antony-sm/Ovrajnaya_stadia_RD/06 ВК/razmery-perexodnikov-dlya-kanalizacionnih-trub.jpg

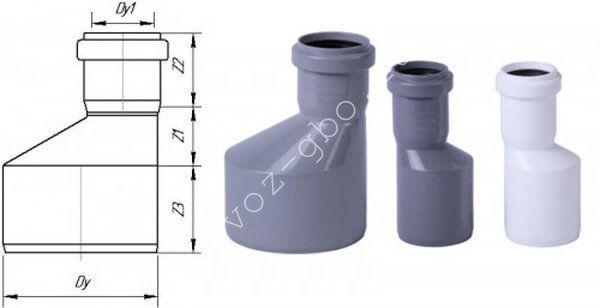
06 ВК/razmery-perexodnikov-dlya-kanalizacionnih-trub.jpg
