antony-sm/Ovrajnaya_stadia_RD/07 Перегородки потолки звукоизоляция/ПЗ.odt

# Звукоизоляция потолка.

Последовательность работ:

1. Застелить пол полиэтиленом.
2. Заложить пол листами ГВЛ старыми.
3. Занести материал.
4. Разметить высоту потолка.
5. Укрыть стены.
6. Наклеить ленту на подвесы (в т.ч. внутри) и направляющие профили.
7. Пристрелять подвесы.
8. Закрепить направляющие профили.
9. Нарезать несущие профили, нарезать Роквул и набить им профили.
10. Закрепить несущие профили.
11. Наклеить ленту по периметру и на несущие профили.
12. Закрепить Роквул.
13. Закрепить первый слой ГВЛ.
14. Промазать швы герметиком.
15. Закрепить второй слой ГВЛ.
16. Промазать швы герметиком.
17. Загрунтовать потолок.
