antony-sm/Ovrajnaya_stadia_RD/04 ЭОМ СС/ПЗ.odt

# Требования.

Расстояние между силой и СС — 20 см минимум.

Расстояние между ПС и пучком ЭО — 50 см минимум, между ПС и одиночным ЭО — 25 см.

# Аппаратура.

Звук — Logitech Media Server или HiFiBerry AMP+.

Датчик углекислого газа — TCS4161 или MQZ135.

Часы — комплектующие см. в проекте Кикад.

# Требования к электрике.

КУП для ванной и туалета.

Вводной автомат — тип C. Сразу после вводного автоматического выключателя желательно установить противопожарное УЗО на 100 мА с большим временем срабатывания.

Отключающая способность автоматов — не менее 6000А, для вводного — 10000А.

Отдельные автоматы:

- собственные нужды щита (розетка, освещение), трансформатор звонка, управляющие цепи импульсных реле;
- слаботочка и автоматика;
- ИБП;
- ПС.

Можно применить УЗО с номинальным током на 63А и не париться о сумме номиналов автоматов после него, ибо вводной автомат всё равно 45А.

УЗО - тип А.

Для линий розеток — УЗО 30 мА.

Для линий в ванной, туалете и лоджии — УЗО 10 мА.

Не более 5 линий на УЗО.

Собственные нужды щита (розетка, освещение), трансформатор звонка, управляющие цепи импульсных реле, слаботочка и автоматика — одно УЗО.

Рубильники и дистанционные расцепители:

- вводные;
- климатическое оборудование.

ВСЕ кнопки и управляющие цепи импульсных реле объединить на ОДИН автомат; выходные контакты каждого реле будут подавать на светильник фазу от его (светильника) автомата.

Устройство защиты от перенапряжения — УЗМ-51МД.

1,5 кв.мм (освещение) | 10 А, тип B
1,5 кв.мм (стационарное) | 10 А, тип C
2,5 кв.мм розетки | 16 А, тип B
2,5 кв.мм стационарное | 16 А, тип С
4 кв.мм стационарное | 20 А, тип С
6 кв.мм стационарное | 32 А, тип С

# Маркировка в электрощите.

Маркировка на плоских поверхностях (пластроны, крышки, модульное оборудование): подготовить наклейки и распечатать лазерником на самоклеящейся бумаге, два раза покрыть матовым нитролаком, порезать и наклеить.

Маркировка кабелей и проводов: подготовить наклейки и распечатать лазерником на самоклеящейся бумаге, порезать, наклеить на кабель, сверху надеть прозрачную термоусадку, осадить.

Правила формирования надписей.

1. Обозначения модульного оборудования - смотри в «перечне элементов щита».
2. Для входящих в щит кабелей и проводов: маркировка согласно кабельному журналу.
3. Для силовых проводов внутри шкафа: к обозначению модульного оборудования добавляется спереди префикс: L,N,PE. Например: «L-QD2», «N-QF5».
4. (?) Для проводов автоматики: обозначение составляется из соединяемых точек оборудования. Например, провод от клеммы X11 к клемме A2 K4.1 должен иметь обозначение «X11 - K4.1(A2)»
