antony-sm/Ovrajnaya_stadia_RD/09 Полы/ПЗ.odt

# Расчёт высот.

Кнауф Суперпол: минимальная толщина засыпки — 20 мм, элемент пола — 20 мм.

Высшая точка пола — угол кухни, отметка -0,065. При 20 мм засыпки, 20 мм элемента пола и 12,5 фанеры или ГВЛ получим отметку чернового пола -0,0125. Плюс кварцвиниловая плитка на клей 3 мм, получим отметку чистового пола около -0,01.

Высота чернового пола в «грязной» зоне: -7,6+3+2 = -2,6 см.

Высота чернового пола в «чистая» зоне: -6,5+2+2 = -2,5 см.

Будем сыпать с запасом в 3 мм. Итого, отталкиваясь от «грязной» зоны: -7,6 + 3,3 (засыпка) + 2 (элемент пола) = -2,3 см. С плиткой -1,3 см.

Чистая зона: -6,5 + 2,3 (засыпка) + 2 (элемент пола) = -2,2 см. Плюс доп слой фанеры или ГВЛ: -2,2 + 1,3 = -0,9 см. Плюс кварцвинил на клей: -0,9 + 0,3 = -0,6 см.

Получили разницу зон в 0,7 см (грязная ниже).

Верхняя отметка засыпки: -6,5 + 2,3 = -4,2 см.

Высота нижней кромки балконной двери — не ниже 1 см от отметки чистого пола. Примем 2,5 см — расстояние от кромки створки стеклоблока до кромки рамы. Высота нижней кромки блока балконного: 1 — 2,5 см = -1,5 см. В итоге нужно поднять балконный блок относительно местной отметки плиты перекрытия на: 6,6 — 0,6 + 1 -2,5 = 4,5 см.

Кирпич имеет высоту 6,5 см. Будем ставить стеклоблок прямо на существующий ряд кирпича.

В развёртках стен за нулевую отметку принимается существующая нулевая отметка — порог входной двери.
