antony-sm/Ovrajnaya_stadia_RD/05 ОВиК/TD-160 SILENTdraw01.JPG

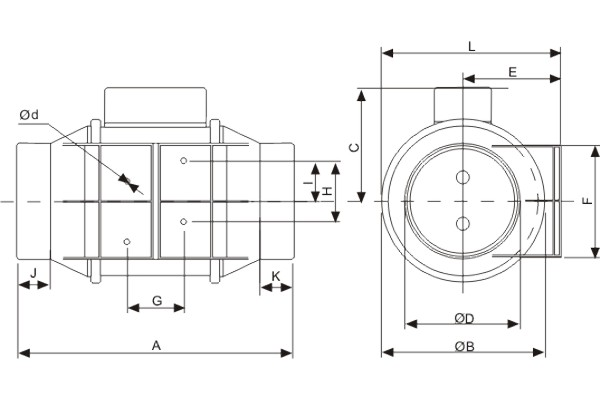
05 ОВиК/TD-160 SILENTdraw01.JPG
