antony-sm/Ovrajnaya_stadia_RD/05 ОВиК/zea3_2.jpg

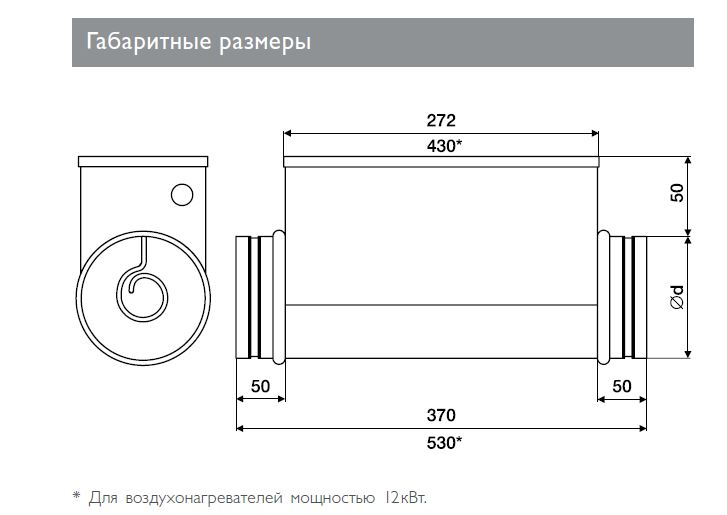
05 ОВиК/zea3_2.jpg
