antony-sm/Ovrajnaya_stadia_RD/06 ВК/mid_smesitel-dlya-vanny-hansgrohe-ecostat-13114000(5).jpg

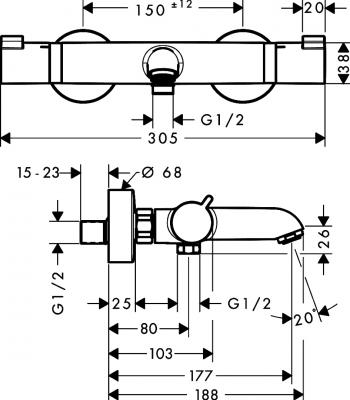
06 ВК/mid_smesitel-dlya-vanny-hansgrohe-ecostat-13114000(5).jpg
