antony-sm/Ovrajnaya_stadia_RD/06 ВК/Odeon Up E4701-00.gif

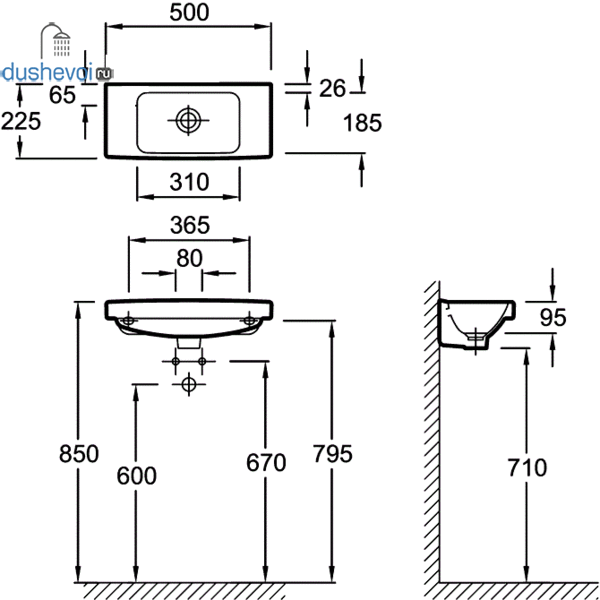
06 ВК/Odeon Up E4701-00.gif
