antony-sm/Ovrajnaya_stadia_RD/06 ВК/бачок.jpeg

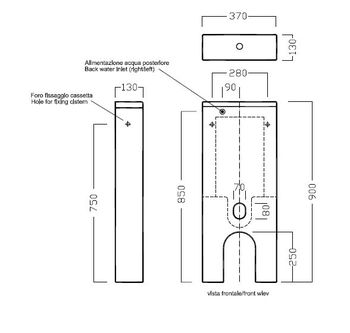
06 ВК/бачок.jpeg
