antony-sm/Ovrajnaya_stadia_RD/06 ВК/инсталляция сбоку.jpg

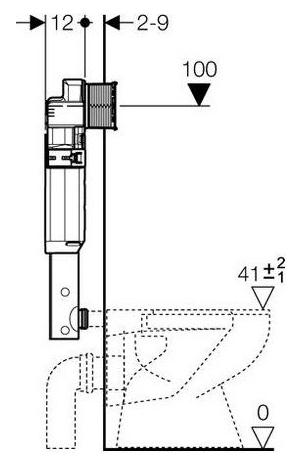
06 ВК/инсталляция сбоку.jpg
