antony-sm/Ovrajnaya_stadia_RD/06 ВК/инсталляция.jpg

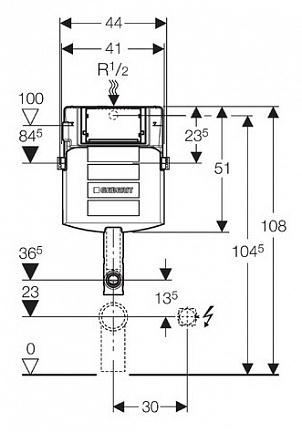
06 ВК/инсталляция.jpg
