antony-sm/Ovrajnaya_stadia_RD/06 ВК/клапан обратный 50 мм.jpg

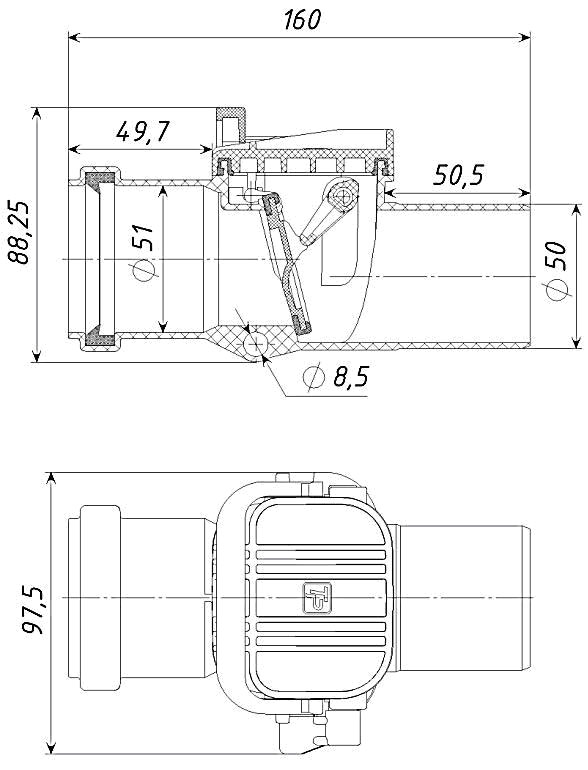
06 ВК/клапан обратный 50 мм.jpg
