antony-sm/Ovrajnaya_stadia_RD/06 ВК/клипса 20 мм.jpg

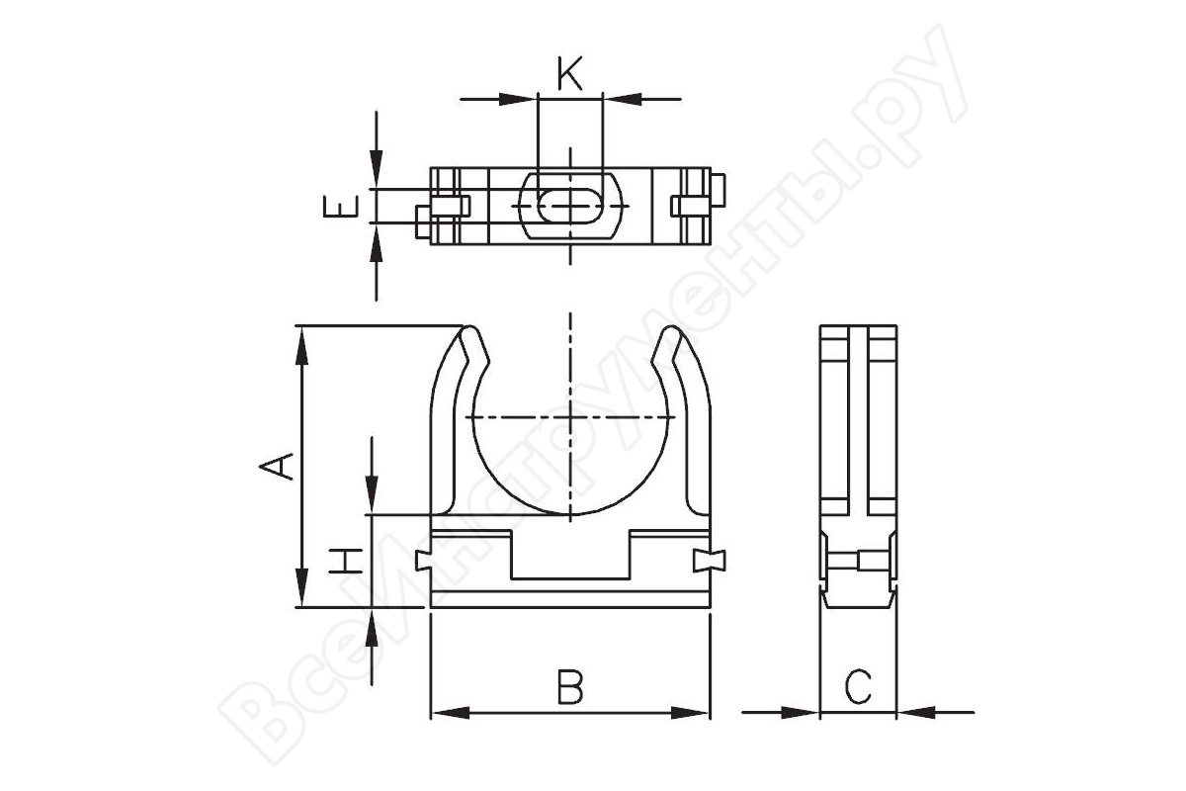
06 ВК/клипса 20 мм.jpg
