antony-sm/Ovrajnaya_stadia_RD/06 ВК/охта.jpg

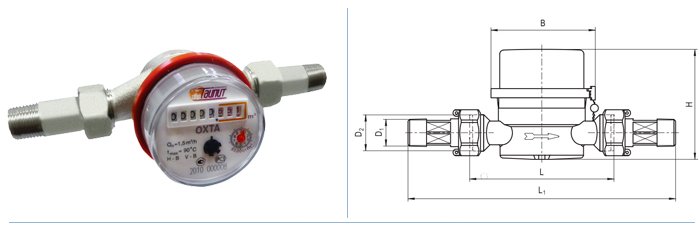
06 ВК/охта.jpg
