antony-sm/Ovrajnaya_stadia_RD/06 ВК/полотенцесушитель.jpg

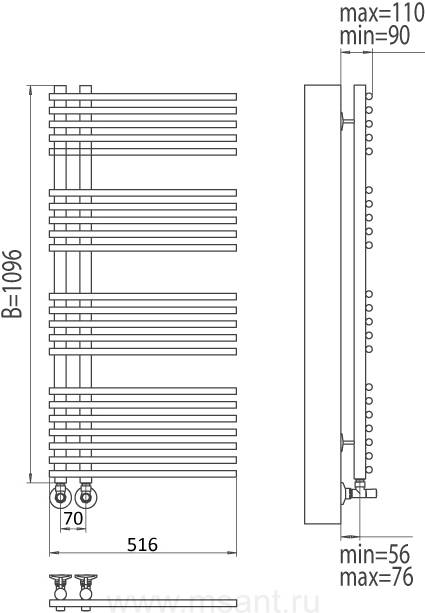
06 ВК/полотенцесушитель.jpg
