antony-sm/Ovrajnaya_stadia_RD/06 ВК/раковина.jpg

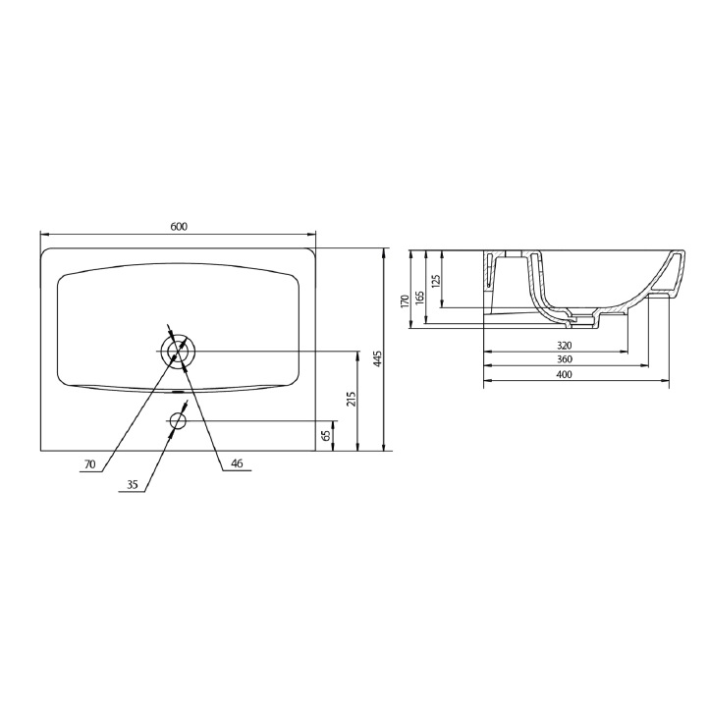
06 ВК/раковина.jpg
