antony-sm/Ovrajnaya_stadia_RD/07 Перегородки потолки звукоизоляция/knauf.jpg

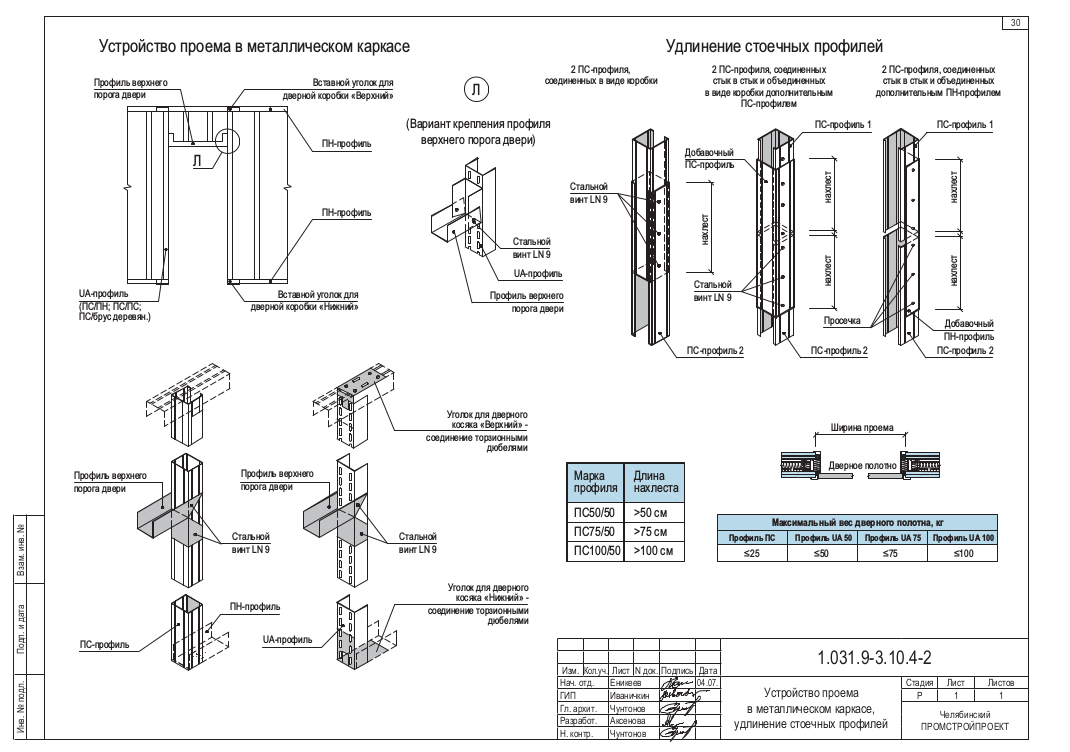
07 Перегородки потолки звукоизоляция/knauf.jpg
