antony-sm/Ovrajnaya_stadia_RD/100 Мебель/Санузлы/г.о. Химки, мкр. Сходня, ул. Овражная, д. 4, п. 2, эт. 76. Пенал подвесной + зеркало в коробе..jpg

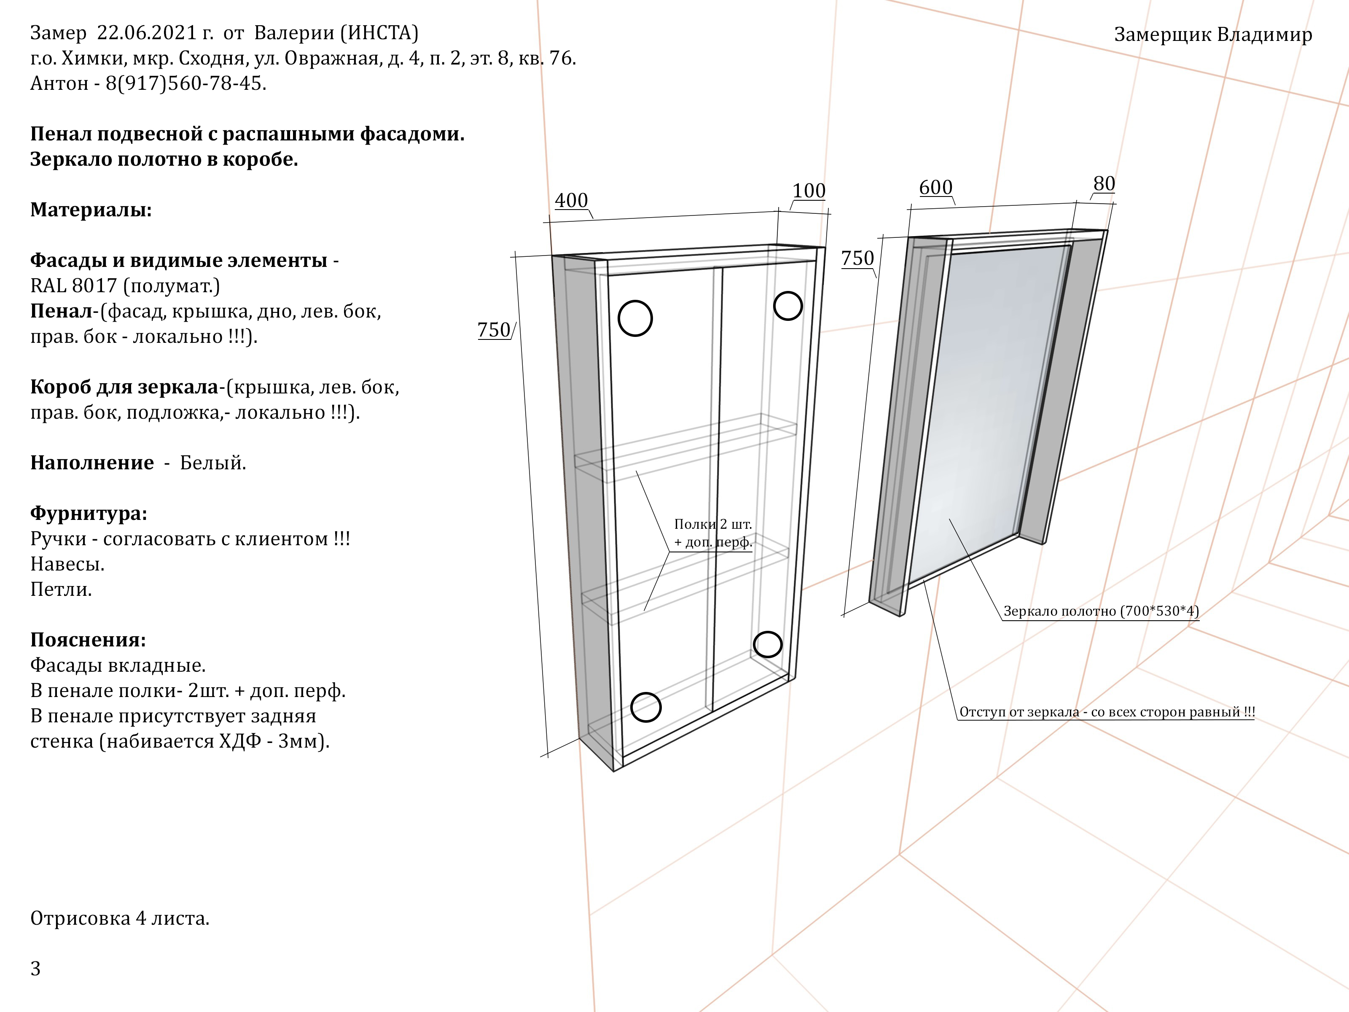
100 Мебель/Санузлы/г.о. Химки, мкр. Сходня, ул. Овражная, д. 4, п. 2, эт. 76. Пенал подвесной + зеркало в коробе..jpg
