antony-sm/Ovrajnaya_stadia_RD/Расчет точки росы/_Жилое помещение. Стена. R 1.30  29.11.2018 12_32_09 (1).png

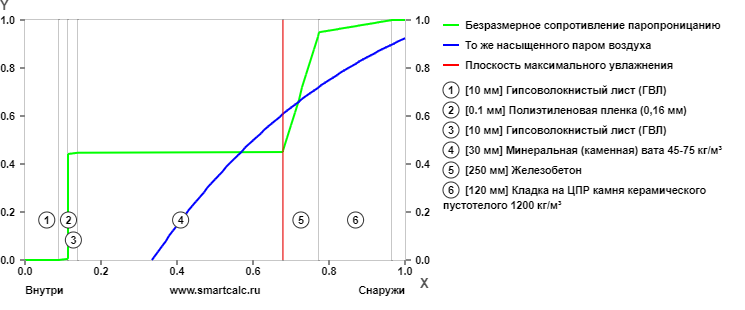
Расчет точки росы/_Жилое помещение. Стена. R 1.30 29.11.2018 12_32_09 (1).png
