antony-sm/Ovrajnaya_stadia_RD/04 ЭОМ СС/кабжур.xls

Sheet: ЭОМ
 | Опуск, см |  |  |  |  |  |  | Труба | Длина | Из автокад | 1.1
ЭОМ-1.1 | 120 | ША.6 | XD-1.1 | ВВГнг(А)-LS 3x2,5 | 10 |  |  |  |  | 8.2 | 7.2 | 1
ЭОМ-1.2 |  | XD-1.1 | XD-1.2 | ВВГнг(А)-LS 3x2,5 | 6 |  |  | 20 мм | 6 | 5.1 | 5.1
ЭОМ-1.3 |  | XD-1.2 | XS-1.3,XS-1.4 | ВВГнг(А)-LS 3x2,5 | 3 |  |  | 20 мм | 3 | 2.2 | 2.2
ЭОМ-1.4 |  | XD-1.1 | XD-1.3 | ВВГнг(А)-LS 3x2,5 | 2 |  |  | 20 мм | 2 | 1.0 | 1.0
ЭОМ-1.5 |  | XD-1.3 | XS-1.1,XS-1.2 | ВВГнг(А)-LS 3x2,5 | 3 |  |  | 20 мм | 3 | 2.5 | 2.2 | 0.3
ЭОМ-1.6 |  | XD-1.3 | XD-1.4 | ВВГнг(А)-LS 3x2,5 | 3 |  |  | 20 мм | 3 | 1.9 | 1.9
ЭОМ-1.7 |  | XD-1.4 | XS-1.5..XS-1.8 | ВВГнг(А)-LS 3x2,5 | 2 |  |  | 20 мм | 2 | 1.3 | 1.0 | 0.3
ЭОМ-1.8 |  | XD-1.4 | XD-1.7 | ВВГнг(А)-LS 3x2,5 | 2 |  |  | 20 мм | 2 | 1.4 | 1.4
ЭОМ-1.9 |  | XD-1.2 | XD-1.5 | ВВГнг(А)-LS 3x2,5 | 3 |  |  | 20 мм | 3 | 2.2 | 2.2
ЭОМ-1.10 |  | XD-1.5 | XS-1.11,XS-1.12 | ВВГнг(А)-LS 3x2,5 | 3 |  |  | 20 мм | 3 | 2.2 | 2.2
ЭОМ-1.11 |  | XD-1.5 | XD-1.8 | ВВГнг(А)-LS 3x2,5 | 2 |  |  | 20 мм | 2 | 1.4 | 1.4
ЭОМ-1.12 |  | XD-1.8 | XS-1.13,XS-1.14 | ВВГнг(А)-LS 3x2,5 | 4 |  |  | 20 мм | 4 | 2.9 | 0.4 | 2.5
ЭОМ-1.13 |  | XD-1.8 | XS-1.15,XS-1.16 | ВВГнг(А)-LS 3x2,5 | 3 |  |  | 20 мм | 3 | 1.9 | 0.4 | 1.5
ЭОМ-1.14 |  | XD-1.7 | XS-1.9,XS-1.10 | ВВГнг(А)-LS 3x2,5 | 4 |  |  | 20 мм | 4 | 2.9 | 0.4 | 2.5
ЭОМ-1.15 |  | XD-1.7 | XS-1.17,XS-1.18 | ВВГнг(А)-LS 3x2,5 | 3 |  |  | 20 мм | 3 | 2.5 | 1.0 | 1.5
ЭОМ-1.31 | 120 | ША.6 | XF-1.1 | ВВГнг(А)-LS 3x2,5 | 10 | 0.02 | Вентилятор канальный | 20 мм | 2 | 9.0 | 8.0 | 1
ЭОМ-1.32 | 120 | ША.6 | XF-1.2 | ВВГнг(А)-LS 3x2,5 | 14 | 2.1 | Канальный нагреватель | 20 мм | 6 | 12.0 | 11.0 | 1
ЭОМ-1.51 | 120 | ША.6 | HL-1.1 | ВВГнг(А)-LS 3x1,5 | 14 |  |  | 16 мм | 6 | 12.0 | 11.0 | 1
ЭОМ-1.52 | 120 | ША.6 | XD-1.3 | ВВГнг(А)-LS 3x1,5 | 10 |  |  | 16 мм | 2 | 9.0 | 8.0 | 1
ЭОМ-1.53 |  | XD-1.3 | HL-1.2 | ВВГнг(А)-LS 3x1,5 | 2 |  |  | 16 мм | 2 | 1.0 | 1.0
ЭОМ-1.54 |  | XD-1.3 | HL-1.3 | ВВГнг(А)-LS 3x1,5 | 4 |  |  | 16 мм | 4 | 3.0 | 3.0
ЭОМ-1.55 | 120 | ША.6 | HL-1.4 | ВВГнг(А)-LS 3x1,5 | 17 |  |  | 16 мм | 9 | 15.1 | 12.5 | 1 | 1.6
ЭОМ-1.56 | 120 | ША.6 | HL-1.5 | ВВГнг(А)-LS 3x1,5 | 18 |  |  | 16 мм | 10 | 16.3 | 13.7 | 1 | 1.6
ЭОМ-1.57 | 120 | ША.6 | QS-1.2 | ВВГнг(А)-LS 2x1,5 | 17 |  |  | 16 мм | 9 | 15.3 | 12.0 | 1 | 2.3
ЭОМ-1.58 | 120 | ША.6 | QS-1.3 | ВВГнг(А)-LS 2x1,5 | 20 |  |  | 16 мм | 12 | 17.5 | 14.2 | 1 | 2.3
ЭОМ-1.59 | 120 | ША.6 | XD-1.6 | ВВГнг(А)-LS 2x1,5 | 10 |  |  | 16 мм | 2 | 9.0 | 8.0 | 1
ЭОМ-1.60 |  | XD-1.6 | QS-1.1 | ВВГнг(А)-LS 2x1,5 | 3 |  |  | 16 мм | 3 | 1.9 | 1.9
ЭОМ-1.61 |  | XD-1.6 | XD-1.2 | ВВГнг(А)-LS 2x1,5 | 5 |  |  | 16 мм | 5 | 4.0 | 4.0
ЭОМ-1.62 |  | XD-1.2 | QS-1.2 | ВВГнг(А)-LS 2x1,5 | 3 |  |  | 16 мм | 3 | 2.3 | 2.3
ЭОМ-1.63 |  | XD-1.2 | QS-1.3 | ВВГнг(А)-LS 2x1,5 | 5 |  |  | 16 мм | 5 | 4.5 | 2.2 | 2.3
ЭОМ-2.1 | 120 | ША.6 | XD-2.1 | ВВГнг(А)-LS 3x2,5 | 9 |  |  |  |  | 8.0 | 7.0 | 1
ЭОМ-2.2 |  | XD-2.1 | XD-2.2 | ВВГнг(А)-LS 3x2,5 | 2 |  |  | 20 мм | 2 | 1.1 | 1.1
ЭОМ-2.3 |  | XD-2.1 | XS-2.5..XS-2.8 | ВВГнг(А)-LS 3x2,5 | 3 |  |  | 20 мм | 3 | 2.7 | 0.8 | 1.9
ЭОМ-2.4 |  | XD-2.2 | XS-2.1,XS-2.2 | ВВГнг(А)-LS 3x2,5 | 6 |  |  | 20 мм | 6 | 4.7 | 2.8 | 1.9
ЭОМ-2.5 |  | XD-2.2 | XS-2.3,XS-2.4 | ВВГнг(А)-LS 3x2,5 | 3 |  |  | 20 мм | 3 | 2.5 | 2.5
ЭОМ-2.31 | 120 | ША.6 | XF-2.1 | ВВГнг(А)-LS 3x2,5 | 13 | 2.13 | Кондиционер | 20 мм | 5 | 11.0 | 10.0 | 1
ЭОМ-2.51 | 120 | ША.6 | XD-2.1 | ВВГнг(А)-LS 3x1,5 | 9
ЭОМ-2.52 |  | XD-2.1 | HL-2.1 | ВВГнг(А)-LS 3x1,5 | 3 |  |  | 16 мм | 3 | 2.4 | 2.4
ЭОМ-2.53 |  | XD-2.1 | HL-2.2 | ВВГнг(А)-LS 3x1,5 | 3 |  |  | 16 мм | 3 | 1.9 | 1.9
ЭОМ-2.54 | 120 | ША.6 | QS-2.1 | ВВГнг(А)-LS 2x1,5 | 12 |  |  | 16 мм | 3 | 10.3 | 7.4 | 1 | 1.9
ЭОМ-3.1 | 120 | ША.6 | XD-3.1 | ВВГнг(А)-LS 3x2,5 | 9 |  |  | 20 мм | 1 | 7.7 | 6.7 | 1
ЭОМ-3.2 |  | XD-3.1 | XS-3.1,XS-3.2 | ВВГнг(А)-LS 3x2,5 | 3 |  |  | 20 мм | 3 | 2.6 | 2.6
ЭОМ-3.3 |  | XD-3.1 | XS-3.3..XS-3.5 | ВВГнг(А)-LS 3x2,5 | 4 |  |  | 20 мм | 4 | 3.4 | 1.5 | 1.9
ЭОМ-3.4 |  | XD-3.1 | XD-3.2 | ВВГнг(А)-LS 3x2,5 | 3 |  |  | 20 мм | 3 | 2.6 | 2.6
ЭОМ-3.5 |  | XD-3.2 | XS-3.6..XS-3.9 | ВВГнг(А)-LS 3x2,5 | 2 |  |  | 20 мм | 2 | 1.4 | 1.4
ЭОМ-3.6 |  | XD-3.2 | XD-3.3 | ВВГнг(А)-LS 3x2,5 | 2 |  |  | 20 мм | 2 | 1.5 | 1.5
ЭОМ-3.7 |  | XD-3.3 | XS-3.10..XS-3.13 | ВВГнг(А)-LS 3x2,5 | 3 |  |  | 20 мм | 3 | 2.0 | 2.0
ЭОМ-3.8 |  | XD-3.3 | XS-3.14,XS-3.15 | ВВГнг(А)-LS 3x2,5 | 5 |  |  | 20 мм | 5 | 3.8 | 2.3 | 1.5
ЭОМ-3.9 | 350 | ША.6 | XS-3.16..XS-3.19 | ВВГнг(А)-LS 3x2,5 | 16.5 |  |  | 20 мм |  | 2.6 | 2.6
ЭОМ-3.51 | 120 | ША.6 | HL-3.1 | ВВГнг(А)-LS 3x1,5 | 14 |  |  | 16 мм | 6 | 12.2 | 11.2 | 1
ЭОМ-3.52 | 120 | ША.6 | XD-3.4 | ВВГнг(А)-LS 3x1,5 | 11 |  |  | 16 мм | 3 | 9.1 | 8.1 | 1
ЭОМ-3.53 |  | XD-3.4 | HL-3.2 | ВВГнг(А)-LS 3x1,5 | 2 |  |  | 16 мм | 2 | 1.7 | 1.7
ЭОМ-3.54 |  | XD-3.4 | HL-3.4 | ВВГнг(А)-LS 3x1,5 | 2 |  |  | 16 мм | 2 | 1.4 | 1.4
ЭОМ-3.55 | 120 | ША.6 | HL-3.3 | ВВГнг(А)-LS 3x1,5 | 16 |  |  | 16 мм | 8 | 14.4 | 2.2 | 11.2 | 1
ЭОМ-3.56 | 120 | ША.6 | XD-3.1 | ВВГнг(А)-LS 2x1,5 | 9 |  |  | 16 мм | 1
ЭОМ-3.57 |  | XD-3.1 | QS-3.1 | ВВГнг(А)-LS 2x1,5 | 3 |  |  | 16 мм | 3 | 1.9 | 1.9
ЭОМ-3.58 |  | XD-3.1 | QS-3.2 | ВВГнг(А)-LS 2x1,5 | 4 |  |  | 16 мм | 4 | 3.5 | 1.5 | 2
ЭОМ-3.59 | 120 | ША.6 | QS-3.2 | ВВГнг(А)-LS 2x1,5 | 12 |  |  | 16 мм | 4 | 10.1 | 8.1 | 2
ЭОМ-3.60 |  | XD-3.1 | QS-3.3 | ВВГнг(А)-LS 2x1,5 | 9 |  |  | 16 мм | 9 | 8.1 | 6.2 | 1.9
ЭОМ-3.61 | 120 | ША.6 | QS-3.3 | ВВГнг(А)-LS 2x1,5 | 16 |  |  | 16 мм | 8 | 14.2 | 12.3 | 1.9
ЭОМ-4.1 | 120 | ША.6 | XD-4.1 | ВВГнг(А)-LS 3x2,5 | 5 |  |  |  |  | 4.0 | 3.0 | 1
ЭОМ-4.2 |  | XD-4.1 | XD-4.2 | ВВГнг(А)-LS 3x2,5 | 2 |  |  | 20 мм | 2 | 1.8 | 1.8
ЭОМ-4.3 |  | XD-4.2 | XS-4.1..XS-4.3 | ВВГнг(А)-LS 3x2,5 | 3 |  |  | 20 мм | 3 | 2.6 | 2.6
ЭОМ-4.4 |  | XD-4.2 | XD-4.3 | ВВГнг(А)-LS 3x2,5 | 4 |  |  | 20 мм | 4 | 3.1 | 3.1
ЭОМ-4.5 |  | XD-4.3 | XS-4.4..XS-4.6 | ВВГнг(А)-LS 3x2,5 | 3 |  |  | 20 мм | 3 | 2.5 | 2.5
ЭОМ-4.6 |  | XD-4.3 | XD-4.6 | ВВГнг(А)-LS 3x2,5 | 3 |  |  | 20 мм | 3 | 2.3 | 2.3
ЭОМ-4.7 |  | XD-4.6 | XS-4.7,XS-4.8 | ВВГнг(А)-LS 3x2,5 | 3 |  |  | 20 мм | 3 | 2.0 | 2.0
ЭОМ-4.8 |  | XD-4.6 | XS-4.16,XS-4.17 | ВВГнг(А)-LS 3x2,5 | 4 |  |  | 20 мм | 4 | 2.9 | 1.4 | 1.5
ЭОМ-4.9 |  | XD-4.1 | XD-4.4 | ВВГнг(А)-LS 3x2,5 | 2 |  |  | 20 мм | 2 | 1.3 | 1.3
ЭОМ-4.10 |  | XD-4.4 | XS-4.9..XS-4.11 | ВВГнг(А)-LS 3x2,5 | 3 |  |  | 20 мм | 3 | 2.5 | 2.5
ЭОМ-4.11 |  | XD-4.4 | XD-4.5 | ВВГнг(А)-LS 3x2,5 | 3 |  |  | 20 мм | 3 | 2.5 | 2.5
ЭОМ-4.12 |  | XD-4.5 | XS-4.12,XS-4.13 | ВВГнг(А)-LS 3x2,5 | 3 |  |  | 20 мм | 3 | 2.5 | 2.0 | 0.5
ЭОМ-4.13 |  | XD-4.5 | XS-4.14,XS-4.15 | ВВГнг(А)-LS 3x2,5 | 4 |  |  | 20 мм | 4 | 3.0 | 2.5 | 0.5
ЭОМ-4.14 |  | XD-4.5 | XS-4.18,XS-4.19 | ВВГнг(А)-LS 3x2,5 | 4 |  |  | 20 мм | 4 | 3.1 | 2.6 | 0.5
ЭОМ-4.51 | 120 | ША.6 | HL-4.1 | ВВГнг(А)-LS 3x1,5 | 9 |  |  | 16 мм | 4 | 7.5 | 6.5 | 1
ЭОМ-4.52 | 120 | ША.6 | HL-4.2 | ВВГнг(А)-LS 3x1,5 | 14 |  |  | 16 мм | 9 | 12.6 | 10.0 | 1 | 1.6
ЭОМ-4.53 | 120 | ША.6 | HL-4.3 | ВВГнг(А)-LS 3x1,5 | 11 |  |  | 16 мм | 6 | 9.1 | 6.5 | 1 | 1.6
ЭОМ-4.54 | 120 | ША.6 | XD-4.1 | ВВГнг(А)-LS 2x1,5 | 5
ЭОМ-4.55 |  | XD-4.1 | QS-4.2 | ВВГнг(А)-LS 2x1,5 | 7 |  |  | 16 мм | 7 | 6.2 | 4.2 | 2
ЭОМ-4.56 |  | XD-4.1 | XD-4.4 | ВВГнг(А)-LS 2x1,5 | 2 |  |  | 16 мм | 2
ЭОМ-4.57 |  | XD-4.4 | QS-4.1 | ВВГнг(А)-LS 2x1,5 | 3 |  |  | 16 мм | 3 | 1.9 | 1.9
ЭОМ-4.58 | 120 | ША.6 | QS-4.2 | ВВГнг(А)-LS 2x1,5 | 15 |  |  | 16 мм | 10 | 12.9 | 10.0 | 1 | 1.9
ЭОМ-4.59 |  | XD-4.4 | QS-4.3 | ВВГнг(А)-LS 2x1,5 | 5 |  |  | 16 мм | 5 | 4.2 | 2.3 | 1.9
ЭОМ-4.60 | 120 | ША.6 | QS-4.3 | ВВГнг(А)-LS 2x1,5 | 9 |  |  | 16 мм | 4 | 7.4 | 6.4 | 1
ЭОМ-5.1 | 120 | ША.6 | XS-5.1 | ВВГнг(А)-LS 3x6 | 10 | 12 кВт | плита | 25 мм | 1 | 9.0 | 5.3 | 1 | 2.7
ЭОМ-5.2 | 120 | ША.6 | XS-5.2 | ВВГнг(А)-LS 3x4 | 10 | 8 кВт | духовка | 25 мм | 1
ЭОМ-5.3 | 120 | ША.6 | XD-5.1 | ВВГнг(А)-LS 3x2,5 | 7 |  |  |  |  | 5.8 | 4.8 | 1
ЭОМ-5.4 |  | XD-5.1 | XD-5.2 | ВВГнг(А)-LS 3x2,5 | 4 |  |  | 20 мм | 4 | 2.9 | 2.9
ЭОМ-5.5 |  | XD-5.2 | XS-5.3,XS-5.4 | ВВГнг(А)-LS 3x2,5 | 2 |  |  | 20 мм | 2 | 1.6 | 1.6
ЭОМ-5.6 |  | XD-5.2 | XD-5.3 | ВВГнг(А)-LS 3x2,5 | 1 |  |  | 20 мм | 1 | 0.8 | 0.8
ЭОМ-5.7 |  | XD-5.3 | XS-5.5..XS-5.8 | ВВГнг(А)-LS 3x2,5 | 2 |  |  | 20 мм | 2 | 1.8 | 1.8
ЭОМ-5.8 |  | XD-5.3 | XS-5.19,XS-5.20 | ВВГнг(А)-LS 3x2,5 | 3 |  |  | 20 мм | 3 | 2.6 | 1.0 | 1.6
ЭОМ-5.9 |  | XD-5.1 | XS-5.9,XS-5.10 | ВВГнг(А)-LS 3x2,5 | 2 |  |  |  |  | 1.5 |  | 1 | 0.5
ЭОМ-5.10 |  | XD-5.1 | XS-5.11,XS-5.12 | ВВГнг(А)-LS 3x2,5 | 6 |  |  |  |  | 5.0 | 2.0 | 3
ЭОМ-5.11 |  | XD-5.1 | XS-5.13..XS-5.15 | ВВГнг(А)-LS 3x2,5 | 6 |  |  |  |  | 5.3 | 3.3 | 2
ЭОМ-5.12 |  | XD-5.1 | XS-5.16..XS-5.18 | ВВГнг(А)-LS 3x2,5 | 8 |  |  |  |  | 7.0 | 4.0 | 3
ЭОМ-5.13 |  | XD-5.3 | XS-5.21,XS-5.22 | ВВГнг(А)-LS 3x2,5 | 5 |  |  | 20 мм | 5 | 4.5 | 2.9 | 1.6
ЭОМ-5.51 | 120 | ША.6 | HL-5.1 | ВВГнг(А)-LS 3x1,5 | 11 |  |  | 16 мм | 4 | 9.6 | 8.6 | 1
ЭОМ-5.52 | 120 | ША.6 | HL-5.2 | ВВГнг(А)-LS 3x1,5 | 7 |  |  | 16 мм | 1
ЭОМ-5.57 | 120 | ША.6 | QS-5.1 | ВВГнг(А)-LS 2x1,5 | 8 |  |  | 16 мм | 2 | 6.6 | 4.7 | 1.9
ЭОМ-5.58 | 120 | ША.6 | HL-5.3 | ВВГнг(А)-LS 2x1,5 | 9 |  |  | 16 мм | 2 | 7.6 | 5.9 | 1.7
ЭОМ-6.1 | 120 | ША.6 | XD-6.1 | ВВГнг(А)-LS 3x2,5 | 3 |  |  |  |  | 2.2 | 1.2 | 1
ЭОМ-6.2 |  | XD-6.1 | XD-6.2 | ВВГнг(А)-LS 3x2,5 | 2 |  |  | 20 мм | 2 | 1.5 | 1.5
ЭОМ-6.3 |  | XD-6.2 | XS-6.1,XS-6.2 | ВВГнг(А)-LS 3x2,5 | 3 |  |  | 20 мм | 3 | 2.7 | 0.2 | 2.5
ЭОМ-6.4 |  | XD-6.2 | XS-6.3,XS-6.4 | ВВГнг(А)-LS 3x2,5 | 5 |  |  | 20 мм | 5 | 3.8 | 1.3 | 2.5
ЭОМ-6.5 |  | XD-6.1 | XD-6.3 | ВВГнг(А)-LS 3x2,5 | 5 |  |  |  |  | 4.4 | 4.4
ЭОМ-6.6 |  | XD-6.3 | XS-6.5,XS-6.6 | ВВГнг(А)-LS 3x2,5 | 4 |  |  | 20 мм | 4 | 3.1 | 0.6 | 2.5
ЭОМ-6.7 |  | XD-6.3 | XS-6.7,XS-6.8 | ВВГнг(А)-LS 3x2,5 | 5 |  |  | 20 мм | 3 | 4.2 | 1.7 | 2.5
ЭОМ-6.8 | - | ША.6 | XS-6.9,XS-6.10 | 3 x ПуГВ | 3 |  |  |  |  | 2.0 | 2.0
ЭОМ-6.9 | 120 | ША.6 | XS-6.11,XS-6.12 | ВВГнг(А)-LS 3x2,5 | 8 |  |  | 20 мм | 3 | 7.0 | 4.5 | 2.5
ЭОМ-6.51 | 120 | ША.6 | XD-6.1 | ВВГнг(А)-LS 3x1,5 | 3
ЭОМ-6.52 |  | XD-6.1 | HL-6.1 | ВВГнг(А)-LS 3x1,5 | 6 |  |  | 16 мм | 1 | 4.8 | 4.8
ЭОМ-6.53 |  | XD-6.1 | HL-6.2 | ВВГнг(А)-LS 3x1,5 | 1 |  |  | 16 мм | 1 | 0.5 | 0.5
ЭОМ-6.54 | 120 | ША.6 | HL-6.3 | ВВГнг(А)-LS 3x1,5 | 6 |  |  | 16 мм | 1 | 4.7 | 3.7 | 1
ЭОМ-6.55 | 120 | ША.6 | QS-6.4 | ВВГнг(А)-LS 2x1,5 | 3 |  |  | 16 мм | 1 | 2.0 | 2.0
ЭОМ-6.56 | 120 | ША.6 | XD-6.3 | ВВГнг(А)-LS 2x1,5 | 8 |  |  |  |  | 6.5 | 5.5 | 1
ЭОМ-6.57 |  | XD-6.3 | QS-6.3 | ВВГнг(А)-LS 2x1,5 | 4 |  |  | 16 мм | 3 | 3.1 | 1.2 | 1.9
ЭОМ-6.58 |  | XD-6.3 | QS-6.1 | ВВГнг(А)-LS 2x1,5 | 6 |  |  |  |  | 1.2 | 1.2
ЭОМ-6.61 | 120 | ША.6 | XD-6.4 | ВВГнг(А)-LS 2x1,5 | 5 |  |  | 16 мм | 1 | 4.0 | 3.0 | 1
ЭОМ-6.62 |  | XD-6.4 | QS-6.5 | ВВГнг(А)-LS 2x1,5 | 5 |  |  | 16 мм | 5 | 3.7 | 1.8 | 1.9
ЭОМ-6.63 |  | XD-6.4 | QS-6.6 | ВВГнг(А)-LS 2x1,5 | 5 |  |  | 16 мм | 2 | 3.8 | 1.9 | 1.9
ЭОМ-6.64 | 120 | ША.6 | QS-6.7 | ВВГнг(А)-LS 2x1,5 | 3 |  |  | 16 мм | 1
ЭОМ-6.65 | - | ША.6 | HL-6.4 | 3 x ПуГВ | 2 |  |  |  |  | 1.0 | 1.0
ЭОМ-6.66 | - | ША.6 | QS-6.8 | ВВГнг(А)-LS 2x1,5 | 2 |  |  |  |  | 1.0 | 1.0
ЭОМ-6.67 | 120 | ША.6 | QS-6.9 | ВВГнг(А)-LS 2x1,5 | 5 |  |  | 16 мм | 2 | 4.0 | 3.0 | 1
--//-- | 120 | ША.6 | QS-6.9 | ВВГнг(А)-LS 2x1,5 | 5 |  |  | 16 мм | 2
ЭОМ-6.68 | 120 | ША.6 | BGRV-6.1 | ВВГнг(А)-LS 3x1,5 | 11 |  |  | 16 мм | 3 | 9.1 | 7.2 | 1.9
ЭОМ-6.69 | 120 | ША.6 | BGRV-6.2 | ВВГнг(А)-LS 3x1,5 | 5 |  |  | 16 мм | 2
ЭОМ-7.1 | 120 | ША.6 | XS-7.1 | ВВГнг(А)-LS 3x2,5 | 8 |  |  | 20 мм | 3 | 6.6 | 3.1 | 1 | 2.5
ЭОМ-7.2 | 120 | ША.6 | XS-7.2 | ВВГнг(А)-LS 3x2,5 | 8 |  |  | 20 мм | 3
ЭОМ-7.3 | 120 | ША.6 | XS-7.3,XS-7.4 | ВВГнг(А)-LS 3x2,5 | 8 |  |  | 20 мм | 3 | 6.6 | 4.6 | 1 | 1
ЭОМ-7.51 | 120 | ША.6 | XD-7.1 | ВВГнг(А)-LS 3x1,5 | 7 |  |  | 16 мм | 1 | 5.8 | 4.6 | 1.2
ЭОМ-7.52 |  | ER-7.1 | HL-7.1 | ВВГнг(А)-LS 2x1,5 | 2 |  |  | 16 мм | 2 | 1.0 | 1.0
ЭОМ-7.53 | 120 | ША.6 | HL-7.2 | ВВГнг(А)-LS 3x1,5 | 7 |  |  | 16 мм | 2 | 6.0 | 5.0 | 1
ЭОМ-7.54 |  | ER-7.2 | HL-7.3 | ВВГнг(А)-LS 2x1,5 | 2 |  |  | 16 мм | 2 | 1.0 | 1.0
ЭОМ-8.1 | 120 | ША.6 | XS-8.1..XS-8.3 | ВВГнг(А)-LS 3x2,5 | 8 |  |  | 20 мм | 5 | 6.5 | 4.2 | 1 | 1.3
ЭОМ-8.31 | 120 | ША.6 | XF-8.1 | ВВГнг(А)-LS 3x1,5 | 7 | 0.05 | Увлажнитель | 16 мм | 5 | 6.2 | 4.2 | 1 | 1
ЭОМ-8.32 | 120 | ША.6 | XF-8.2 | ВВГнг(А)-LS 3x6 | 10 | 6 | Водонагреватель | 25 мм | 7 | 8.2 | 4.2 | 1 | 3
ЭОМ-8.33 | 220 | ША.6 | XF-8.1 | ВВГнг(А)-LS 2x1,5 | 7 | 0.05 | Увлажнитель | 16 мм | 5
ЭОМ-8.51 | 120 | ША.6 | XD-8.1 | ВВГнг(А)-LS 3x1,5 | 5 |  |  | 16 мм | 1 | 3.8 | 2.6 | 1.2
ЭОМ-8.52 |  | ER-8.1 | HL-8.1 | ВВГнг(А)-LS 2x1,5 | 1 |  |  | 16 мм | 1 | 0.4 | 0.4
ЭОМ-8.53 | 120 | ША.6 | HL-8.2 | ВВГнг(А)-LS 3x1,5 | 7 |  |  | 16 мм | 4 | 6.2 | 4.2 | 1 | 1
ЭОМ-8.54 | 120 | ША.6 | QS-8.1 | ВВГнг(А)-LS 2x1,5 | 8 |  |  | 16 мм | 5 | 7.1 | 4.2 | 1 | 1.9
+ |  | XD-8.1 | автоматика гигиенического душа | ВВГнг(А)-LS 3x1,5 | 5
ЭОМ-9.1 | 120 | ША.6 | XS-9.1,XS-9.2 | ВВГнг(А)-LS 3x2,5 | 18 |  |  | 20 мм | 9 | 15.6 | 12.1 | 1 | 2.5
ЭОМ-9.31 | 120 | ША.6 | XF-9.1 | ВВГнг(А)-LS 3x2,5 | 18 | 0.6 | Теплый пол | 20 мм | 9 | 15.6 | 11.8 | 1 | 2.8
ЭОМ-9.51 | 120 | ША.6 | HL-9.1 | ВВГнг(А)-LS 3x1,5 | 16 |  |  | 16 мм | 7 | 14.3 | 13.3 | 1
ЭОМ-9.52 |  | HL-9.1 | HL-9.2 | ВВГнг(А)-LS 3x1,5 | 2 |  |  | 16 мм | 2 | 1.7 | 1.7
ЭОМ-9.53 | 120 | ША.6 | QS-9.1 | ВВГнг(А)-LS 2x1,5 | 18 |  |  | 16 мм | 9 | 15.7 | 12.8 | 1 | 1.9
ЭОМ-0.1 | 120 | ША.6 | ША.2 | ВВГнг(А)-LS 3x1,5 | 11 |  |  | 16 мм | 2 | 10.0 | 9.0 | 1
ЭОМ-0.2 | 120 | ША.6 | ША.4 | ВВГнг(А)-LS 3x1,5 | 7 |  |  | 16 мм | 2 | 5.9 | 4.9 | 1
ЭОМ-0.3 | 120 | ША.6 | ША.5 | ВВГнг(А)-LS 3x1,5 | 6 |  |  | 16 мм | 1 | 4.8 | 4.8
ЭОМ-0.4 | 120 | ША.6 | KB-1 | ВВГнг(А)-LS 2x1,5 | 5 |  |  | 16 мм | 3 | 3.9 | 1.6 | 1 | 1.3
ЭОМ-0.5 | 120 | ША.6 | HA-1 | ВВГнг(А)-LS 2x1,5 | 1
ДСУП-1 | 250 | ША.6 | КУП | ПуГВ 1х6 | 11 |  |  |  |  | 9.9 | 4.4 | 2.5 | 3
ДСУП-2 |  | КУП | ХВС | ПуГВ 1х4 | 1
ДСУП-3 |  | КУП | ГВС | ПуГВ 1х4 | 1
ДСУП-4 |  | КУП | оГВС | ПуГВ 1х4 | 1
ДСУП-5 |  | КУП | полотенцесушитель | ПуГВ 1х4 | 3
ДСУП-6 |  | КУП | ванна | ПуГВ 1х4 | 5
ДСУП-7 |  | КУП | умывальник | ПуГВ 1х4 | 5 |  |  |  |  | 4.5 | 3.0 | 1.5
ДСУП-8 | 250 | ША.6 | лоток ЭОМ | ПуГВ 1х4 | 10 |  |  |  |  | 8.3 | 5.8 | 2.5
ДСУП-9 | 250 | ША.6 | лоток ЭОМ | ПуГВ 1х4 | 7 |  |  |  |  | 5.5 | 3.0 | 2.5
ДСУП-10 | 250 | ША.6 | лоток СС | ПуГВ 1х4 | 12 |  |  |  |  | 10.2 | 7.7 | 2.5
ДСУП-11 |  | лоток ЭОМ | лоток ЭОМ | ПуГВ 1х4 | 3 |  |  |  |  | 2.5 | 2.5
ДСУП-13 |  | лоток СС | лоток СС | ПуГВ 1х4 | 9 |  |  |  |  | 7.6 | 7.6
ДСУП-14 |  | лоток СС | отвод | ПуГВ 1х4 | 2 |  |  |  |  | 1.1 | 1.1
ДСУП-15 |  | лоток СС | лоток СС | ПуГВ 1х4 | 8 |  |  |  |  | 6.5 | 6.5
ДСУП-16 |  | лоток СС | отвод | ПуГВ 1х4 | 3
ДСУП-17 |  | лоток СС | отвод | ПуГВ 1х4 | 2
ДСУП-18 |  | лоток СС | отвод | ПуГВ 1х4 | 2
ДСУП-19 |  | лоток СС | лоток СС | ПуГВ 1х4 | 4 |  |  |  |  | 3.4 | 3.4
ДСУП-20 |  | лоток СС | отвод | ПуГВ 1х4 | 4 |  |  |  |  | 2.8 | 2.8
ДСУП-21 |  | лоток СС | отвод | ПуГВ 1х4 | 1
ДСУП-22 |  | лоток СС | отвод | ПуГВ 1х4 | 2 |  |  |  |  | 1.1 | 1.1
ДСУП-23 |  | лоток СС | лоток СС | ПуГВ 1х4 | 5 |  |  |  |  | 4.5 | 4.5
ДСУП-24 |  | лоток СС | отвод | ПуГВ 1х4 | 2
ДСУП-25 |  | лоток СС | отвод | ПуГВ 1х4 | 2

Sheet: СС
 |  |  |  |  |  | Труба | Длина | Из автокад | 1.2
СС-1.1 | ША-6 | XL-1.1 | ParLan U/UTP 4х2х0,52 мм | 21 |  | 16 мм | 5 | 17.5 | 13.8 | 1.5 | 2.2
СС-1.2 | ША-6 | XL-1.2 | ParLan U/UTP 4х2х0,52 мм | 24 |  | 16 мм | 5 | 19.7 | 16.0 | 1.5 | 2.2
СС-1.3 | ША-6 | XL-1.3 | ParLan U/UTP 4х2х0,52 мм | 20 |  | 16 мм | 4 | 15.9 | 13.3 | 1.5 | 1.1
СС-1.4 | ША-6 | XT-1.1 | РК75-4,9-312А (RG-6) | 20 |  | 16 мм | 4
СС-1.5 | ША-6 | BA-1.1 | Аудиошнур 40183 2х2,5 кв.мм ГОСТ прозрачный | 17 |  | 16 мм | 2 | 14.1 | 12.1 | 1.5 | 0.5
СС-1.6 | ША-6 | BA-1.2 | Аудиошнур 40183 2х2,5 кв.мм ГОСТ прозрачный | 20 |  | 16 мм | 2 | 16.4 | 14.4 | 1.5 | 0.5
СС-2.1 | ША-6 | XL-2.1 | ParLan U/UTP 4х2х0,52 мм | 17 |  | 16 мм | 3 | 13.5 | 10.7 | 1.5 | 1.3
СС-2.2 | ША-6 | XL-2.2 | ParLan U/UTP 4х2х0,52 мм | 16 |  | 16 мм | 4 | 12.8 | 9.4 | 1.5 | 1.9
СС-3.1 | ША-6 | XL-3.1 | ParLan U/UTP 4х2х0,52 мм | 15 |  | 16 мм | 4 | 11.8 | 8.5 | 1.5 | 1.8
СС-3.2 | ША-6 | XL-3.2 | ParLan U/UTP 4х2х0,52 мм | 20 |  | 16 мм | 5 | 16.3 | 12.3 | 1.5 | 2.5
СС-3.3 | ША-6 | XL-3.3 | ParLan U/UTP 4х2х0,52 мм | 19 |  | 16 мм | 4 | 15.7 | 12.3 | 1.5 | 1.9
СС-3.4 | ША-6 | XL-3.4 | ParLan U/UTP 4х2х0,52 мм | 17 |  | 16 мм | 4 | 13.6 | 10.8 | 1.5 | 1.3
СС-3.5 | ША-6 | XT-3.1 | РК75-4,9-312А (RG-6) | 17 |  | 16 мм | 4
СС-3.6 | ША-6 | BA-3.1 | Аудиошнур 40183 2х2,5 кв.мм ГОСТ прозрачный | 17 |  | 16 мм | 3 | 13.8 | 12.0 | 1.5 | 0.3
СС-3.7 | ША-6 | BA-3.2 | Аудиошнур 40183 2х2,5 кв.мм ГОСТ прозрачный | 15 |  | 16 мм | 3 | 12.1 | 10.3 | 1.5 | 0.3
СС-4.1 | ША-6 | XL-4.1 | ParLan U/UTP 4х2х0,52 мм | 15 |  | 16 мм | 3 | 12.5 | 9.2 | 1.5 | 1.8
СС-4.2 | ША-6 | XL-4.2 | ParLan U/UTP 4х2х0,52 мм | 14 |  | 16 мм | 4 | 10.9 | 6.9 | 1.5 | 2.5
СС-4.3 | ША-6 | XL-4.3 | ParLan U/UTP 4х2х0,52 мм | 12 |  | 16 мм | 4 | 9.2 | 5.2 | 1.5 | 2.5
СС-4.4 | ША-6 | XL-4.4 | ParLan U/UTP 4х2х0,52 мм | 12 |  | 16 мм | 3 | 9.4 | 6.1 | 1.5 | 1.8
СС-4.5 | ША-6 | XL-4.5 | ParLan U/UTP 4х2х0,52 мм | 9 |  | 16 мм | 4 | 7.4 | 3.4 | 1.5 | 2.5
СС-4.6 | ША-6 | BA-4.1 | Аудиошнур 40183 2х2,5 кв.мм ГОСТ прозрачный | 9 |  | 16 мм | 1 | 7.0 | 4.9 | 1.5 | 0.6
СС-4.7 | ША-6 | BA-4.2 | Аудиошнур 40183 2х2,5 кв.мм ГОСТ прозрачный | 10 |  | 16 мм | 2 | 8.3 | 6.2 | 1.5 | 0.6
СС-5.1 | ША-6 | XL-5.1 | ParLan U/UTP 4х2х0,52 мм | 13 |  | 16 мм | 2 | 10.5 | 7.3 | 1.5 | 1.7
СС-5.2 | ША-6 | XT-5.1 | РК75-4,9-312А (RG-6) | 13 |  | 16 мм | 2
СС-5.3 | ША-6 | BA-5.1 | Аудиошнур 40183 2х2,5 кв.мм ГОСТ прозрачный | 12 |  | 16 мм | 1 | 9.3 | 7.5 | 1.5 | 0.3
СС-5.4 | ША-6 | BA-5.2 | Аудиошнур 40183 2х2,5 кв.мм ГОСТ прозрачный | 11 |  | 16 мм | 1 | 8.4 | 6.6 | 1.5 | 0.3
СС-6.1 | ША-6 | MON-0 | ВВГнг(А)-LS 2x1,5 | 6 |  | 16 мм | 3 | 4.3 | 1.5 | 1.5 | 1.3
СС-6.2 | ША-6 | MON-0 | РК75-4,9-312А (RG-6) | 6 |  | 16 мм | 3
СС-6.3 | ША-6 | V-0 | ВВГнг(А)-LS 2x1,5 | 3 |  | 16 мм | 2 | 2.2 | 0.7 | 1.5
СС-6.4 | ША-6 | V-0 | РК75-4,9-312А (RG-6) | 3 |  | 16 мм | 2
СС-6.5 | ША-6 | KB-2 | КСПВ 2х0,50 мм | 6
СС-6.6 | ША-6 | XL-6.1 | ParLan U/UTP 4х2х0,52 мм
СС-7.1 | ША-6 | BA-7.1 | Аудиошнур 40183 2х2,5 кв.мм ГОСТ прозрачный | 8 |  | 16 мм | 2 | 6.6 | 5.1 | 1.5
СС-8.1 | ША-6 | BA-8.1 | Аудиошнур 40183 2х2,5 кв.мм ГОСТ прозрачный | 7 |  | 16 мм | 2 | 5.2 | 3.7 | 1.5
СС-0.1 | ША-6 | XD-6.4 | ВВГнг(А)-LS 2x1,5 | 11 |  |  |  | 8.9 | 7.4 | 1.5
СС-0.2 | ША-6 | XD-6.4 | ParLan U/UTP 2х2х0,52 мм | 11
СС-0.3 | XD-6.4 | AT-2 | ВВГнг(А)-LS 2x1,5 | 4 |  | 20 мм | 4 | 2.8 | 1.0 | 1.8
СС-0.4 | XD-6.4 | AT-2 | ParLan U/UTP 2х2х0,52 мм | 4
СС-0.5 | XD-6.4 | AT-1 | ВВГнг(А)-LS 2x1,5 | 4 |  | 20 мм | 2 | 2.9 | 2.4 | 0.5
СС-0.6 | XD-6.4 | AT-1 | ParLan U/UTP 2х2х0,52 мм | 4
СС-0.8 | ША-6 | XD-6.4 | ParLan U/UTP 2х2х0,52 мм | #REF!
СС-0.9 | XD-6.4 | AT-3 | ВВГнг(А)-LS 2x1,5 | 2 |  | 20 мм | 2 | 1.6 | 1.1 | 0.5
СС-0.10 | XD-6.4 | AT-3 | ParLan U/UTP 2х2х0,52 мм | 2
СС-0.11 | XD-6.4 | AT-9 | ВВГнг(А)-LS 2x1,5 | 7 |  | 20 мм | 3 | 5.5 | 5.0 | 0.5
СС-0.12 | XD-6.4 | AT-9 | ParLan U/UTP 2х2х0,52 мм | 7
СС-0.13 | ША-6 | XD-6.1 | ВВГнг(А)-LS 2x1,5 | 3 |  |  |  | 2.4 | 0.9 | 1.5
СС-0.14 | ША-6 | XD-6.1 | ParLan U/UTP 2х2х0,52 мм | 3
СС-0.15 | XD-6.1 | AT-6 | ВВГнг(А)-LS 2x1,5 | 2 |  | 20 мм | 2 | 1.3 | 0.9 | 0.4
СС-0.16 | XD-6.1 | AT-6 | ParLan U/UTP 2х2х0,52 мм | 2
СС-0.17 | XD-6.1 | XD-6.2 | ВВГнг(А)-LS 2x1,5 | 2 |  |  |  | 1.6 | 1.6
СС-0.18 | XD-6.1 | XD-6.2 | ParLan U/UTP 2х2х0,52 мм | 2
СС-0.19 | XD-6.2 | AT-4 | ВВГнг(А)-LS 2x1,5 | 1 |  | 20 мм | 1 | 0.7 | 0.2 | 0.5
СС-0.20 | XD-6.2 | AT-4 | ParLan U/UTP 2х2х0,52 мм | 1
СС-0.21 | XD-6.2 | AT-5 | ВВГнг(А)-LS 2x1,5 | 5 |  | 20 мм | 1 | 3.4 | 2.9 | 0.5
СС-0.22 | XD-6.2 | AT-5 | ParLan U/UTP 2х2х0,52 мм | 5
СС-0.31 | ША-6 | ША-4 | ParLan U/UTP 2х2х0,52 мм | 8 |  | 16 мм | 1 | 6.5 | 5.0 | 1.5
СС-0.32 | ША-4 | ША-2 | ParLan U/UTP 2х2х0,52 мм | 14 |  | 16 мм | 2 | 10.9 | 9.4 | 1.5
СС-0.33 | ША-6 | ША-5 | ParLan U/UTP 2х2х0,52 мм | 10 |  | 16 мм | 1 | 7.6 | 6.1 | 1.5
СС-1.21 | ША-2 | MW-1 | ВВГнг(А)-LS 2x1,5 | 15 |  | 16 мм | 4 | 11.7 | 9.2 | 2.5
СС-1.22 | ША-2 | BC-1 | ParLan U/UTP 4х2х0,52 мм | 12 |  | 16 мм | 2 | 9.8 | 9.3 | 0.5
СС-1.23 | ША-2 | BC-1 | ParLan U/UTP 4х2х0,52 мм | 12 |  | 16 мм | 2
СС-1.24 | ША-2 | XD-1.1 | ParLan U/UTP 2х2х0,52 мм | 9 |  |  |  | 7.0 | 7.0
СС-1.25 | XD-1.1 | BT-1.2 | ParLan U/UTP 2х2х0,52 мм | 2 |  | 16 мм | 1 | 0.9 | 0.9
СС-1.26 | XD-1.1 | BT-1.1 | ParLan U/UTP 2х2х0,52 мм | 3 |  | 16 мм | 1 | 2.1 | 2.1
СС-1.27 | ША-2 | RP-1.1 | ParLan U/UTP 4х2х0,52 мм | 8 |  | 16 мм | 3 | 6.1 | 4.3 | 1.8
СС-1.28 | ША-2 | XF-1.1 | ParLan U/UTP 2х2х0,52 мм | 6 | вентилятор | 16 мм | 1 | 4.7 | 4.7
СС-2.21 | ША-2 | M-2.1 | ВВГнг(А)-LS 2x1,5 | 1 |  | 20 мм | 1 | 0.5 | 0.5
СС-2.22 | ША-2 | M-2.1 | ParLan U/UTP 2х2х0,52 мм | 1
СС-2.23 | ША-2 | M-2.2 | ВВГнг(А)-LS 2x1,5 | 1 |  | 20 мм | 1 | 0.8 | 0.8
СС-2.24 | ША-2 | M-2.2 | ParLan U/UTP 2х2х0,52 мм | 1
СС-2.25 | ША-2 | M-2.3 | ВВГнг(А)-LS 2x1,5 | 2 |  | 20 мм | 2 | 1.0 | 1.0
СС-2.26 | ША-2 | M-2.3 | ParLan U/UTP 2х2х0,52 мм | 2
СС-2.27 | ША-6 | RP-2.1 | ParLan U/UTP 2х2х0,52 мм | 5 |  | 20 мм | 2 | 3.5 | 1.7 | 1.8
СС-2.28 | ША-2 | RP-2.2 | ParLan U/UTP 2х2х0,52 мм | 5
СС-2.29 | YK-2 | XD-2.1 | штатный | - |  | 20 мм | 2
СС-2.30 | XD-2.1 | ША-6 | КВВГнг(А)-LS 5х0,75 | 12 |  |  |  | 9.4 | 7.9 | 1.5
СС-2.31 | ША-2 | BT-2.1 | ParLan U/UTP 2х2х0,52 мм | 2 |  | 16 мм | 2 | 1.4 | 1.4
СС-2.32 | ША-6 | XF-2.1 | КВВГнг(А)-LS 5х0,75 | 14 | кондиционер | 16 мм | 2 | 11.5 | 10.0 | 1.5
СС-3.21 | ША-2 | RP-3.1 | ParLan U/UTP 4х2х0,52 мм | 6 |  | 16 мм | 3 | 4.6 | 2.8 | 1.8
СС-3.22 | ША-2 | M-3.1 | ВВГнг(А)-LS 2x1,5 | 5 |  | 20 мм | 2 | 3.5 | 3.5
СС-3.23 | ША-2 | M-3.1 | ParLan U/UTP 2х2х0,52 мм | 5
СС-3.24 | ША-2 | MW-3 | ВВГнг(А)-LS 2x1,5 | 10 |  | 16 мм | 3 | 8.3 | 6.3 | 2
СС-3.25 | ША-2 | BC-3 | ParLan U/UTP 4х2х0,52 мм | 10 |  | 16 мм | 2 | 7.6 | 7.1 | 0.5
СС-3.26 | ША-2 | BC-3 | ParLan U/UTP 4х2х0,52 мм | 10 |  | 16 мм | 2
СС-4.21 | ША-4 | MW-4 | ВВГнг(А)-LS 2x1,5 | 9 |  | 16 мм | 3 | 7.3 | 5.3 | 2
СС-4.22 | ША-4 | BC-4 | ParLan U/UTP 4х2х0,52 мм | 7 |  | 16 мм | 2 | 5.7 | 5.2 | 0.5
СС-4.23 | ША-4 | BC-4 | ParLan U/UTP 4х2х0,52 мм | 7 |  | 16 мм | 2
СС-4.24 | ША-4 | M-4.1 | ВВГнг(А)-LS 2x1,5 | 6 |  | 20 мм | 1 | 4.2 | 4.2
СС-4.25 | ША-4 | M-4.1 | ParLan U/UTP 2х2х0,52 мм | 6
СС-4.26 | ША-4 | RP-4.1 | ParLan U/UTP 4х2х0,52 мм | 9 |  | 16 мм | 3 | 6.8 | 5.0 | 1.8
СС-5.21 | ША-5 | M-5.1 | ВВГнг(А)-LS 2x1,5 | 2 |  | 20 мм | 1 | 1.0 | 1.0
СС-5.22 | ША-5 | M-5.1 | ParLan U/UTP 2х2х0,52 мм | 2
СС-5.23 | ША-5 | RP-5.1 | ParLan U/UTP 4х2х0,52 мм | 3 |  | 16 мм | 3 | 2.3 | 0.5 | 1.8
СС-5.24 | ША-5 | MW-5 | ВВГнг(А)-LS 2x1,5 | 10 |  | 16 мм | 5 | 7.8 | 5.8 | 2
СС-5.25 | ША-5 | BC-5 | ParLan U/UTP 4х2х0,52 мм | 6 |  | 16 мм | 1 | 4.2 | 3.7 | 0.5
СС-5.26 | ША-5 | BC-5 | ParLan U/UTP 4х2х0,52 мм | 6 |  | 16 мм | 1
СС-6.21 | ША-2 | M-6.1 | ВВГнг(А)-LS 2x1,5 | 6 |  | 20 мм | 2 | 4.8 | 4.8
СС-6.22 | ША-2 | M-6.1 | ParLan U/UTP 2х2х0,52 мм | 6
СС-6.23 | ША-6 | BC-6 | ParLan U/UTP 4х2х0,52 мм | 2 |  | 16 мм | 1 | 1.5 | 1.5
СС-6.24 | ША-6 | BT-6.1 | ParLan U/UTP 4х2х0,52 мм | 14 |  | 16 мм | 1 | 11.4 | 9.7 | 1.5 | 0.2
СС-7.21 | ША-6 | M-7.1 | ВВГнг(А)-LS 2x1,5 | 9 |  | 20 мм | 2 | 7.0 | 5.5 | 1.5
СС-7.22 | ША-6 | M-7.1 | ParLan U/UTP 2х2х0,52 мм | 9
СС-7.23 | ША-6 | BC-7 | ParLan U/UTP 4х2х0,52 мм | 8 |  | 16 мм | 2 | 6.5 | 5.0 | 1.5
СС-8.21 | ША-6 | M-8.1 | ВВГнг(А)-LS 2x1,5 | 8 |  | 20 мм | 2 | 5.9 | 4.4 | 1.5
СС-8.22 | ША-6 | M-8.1 | ParLan U/UTP 2х2х0,52 мм | 8
СС-8.23 | ША-6 | BC-8 | ParLan U/UTP 4х2х0,52 мм | 8 |  | 16 мм | 3 | 6.3 | 4.8 | 1.5
СС-9.21 | ША-2 | BC-9 | ParLan U/UTP 4х2х0,52 мм | 9 |  | 16 мм | 3 | 7.3 | 6.9 | 0.4
СС-9.22 | ША-6 | BT-9 | ParLan U/UTP 2х2х0,52 мм | 20 |  | 16 мм | 5 | 16.4 | 12.1 | 1.5 | 2.8
СС-1.41 | ША-2 | M-1.1 | ParLan U/UTP 4х2х0,52 мм | 11 |  | 16 мм | 1 | 8.9 | 8.9
СС-1.42 | ША-2 | BR-1.1 | ParLan U/UTP 4х2х0,52 мм | 13 |  | 16 мм | 2 | 10.2 | 10.2
СС-1.43 | ША-2 | QS-1.1 | ParLan U/UTP 2х2х0,52 мм | 13 |  | 16 мм | 3 | 10.7 | 8.9 | 1.8
СС-3.41 | ША-2 | M-3.2 | ParLan U/UTP 4х2х0,52 мм | 11 |  | 16 мм | 3 | 8.4 | 8.4
СС-3.42 | ША-2 | BR-3.1 | ParLan U/UTP 4х2х0,52 мм | 10 |  | 16 мм | 3 | 7.7 | 7.7
СС-3.43 | ША-2 | QS-3.1 | ParLan U/UTP 2х2х0,52 мм | 8 |  | 20 мм | 3 | 6.0 | 6.0
СС-3.44 | ША-2 | M-3.3 | ParLan U/UTP 4х2х0,52 мм | 11 |  | 16 мм | 2 | 8.6 | 6.8 | 1.8
СС-3.45 | ША-2 | BR-3.2 | ParLan U/UTP 4х2х0,52 мм | 9 |  | 16 мм | 3 | 7.5 | 7.5
СС-3.46 | ША-2 | QS-3.2 | ParLan U/UTP 2х2х0,52 мм | 11
СС-3.47 | ША-2 | M-3.4 | ParLan U/UTP 4х2х0,52 мм | 8 |  | 16 мм | 2 | 6.5 | 6.5
СС-3.48 | ША-2 | BR-3.3 | ParLan U/UTP 4х2х0,52 мм | 8 |  | 16 мм | 1 | 6.1 | 6.1
СС-3.49 | ША-2 | QS-3.3 | ParLan U/UTP 2х2х0,52 мм | 11
СС-4.41 | ША-4 | M-4.2 | ParLan U/UTP 4х2х0,52 мм | 6 |  | 16 мм | 2 | 4.8 | 4.8
СС-4.42 | ША-4 | BR-4.1 | ParLan U/UTP 4х2х0,52 мм | 7 |  | 16 мм | 3 | 5.7 | 5.7
СС-4.43 | ША-4 | QS-4.1 | ParLan U/UTP 2х2х0,52 мм | 8 |  | 16 мм | 4 | 6.6 | 4.8 | 1.8
СС-5.41 | ША-5 | M-5.2 | ParLan U/UTP 4х2х0,52 мм | 7 |  | 16 мм | 4 | 5.5 | 5.5
СС-5.42 | ША-5 | BR-5.1 | ParLan U/UTP 4х2х0,52 мм | 5 |  | 16 мм | 2 | 3.8 | 3.8
СС-5.43 | ША-5 | QS-5.1 | ParLan U/UTP 2х2х0,52 мм | 7 |  | 16 мм | 4 | 5.6 | 3.8 | 1.8
СС-5.44 | ША-5 | BR-5.2 | ParLan U/UTP 2х2х0,52 мм | 6 |  | 16 мм | 6 | 4.5 | 1.7 | 2.8
СС-0.102 | BW-5 | ARKW-1 | ParLan U/UTP 2х2х0,52 мм | 6 |  | 16 мм | 6 | 4.5 | 3.0 | 1.5
СС-0.104 | BW-7 | ARKW-1 | ParLan U/UTP 2х2х0,52 мм | 3 |  | 16 мм | 3 | 2.2 | 0.7 | 1.5
СС-0.106 | BW-8 | ARKW-1 | ParLan U/UTP 2х2х0,52 мм | 2 |  | 16 мм | 2 | 1.5 | 1.5
СС-0.107 | ARKW-1 | XD-8.2 | ParLan U/UTP 2х2х0,52 мм | 4 |  | 16 мм | 4 | 3.0 | 3.0
СС-0.108 | BR-8.1 | XD-8.2 | КСПВ 2х0,50 мм | 3 |  | 16 мм | 3 | 2.0 | 2.0
СС-0.109 | BR-8.2 | XD-8.2 | КСПВ 2х0,50 мм | 3 |  | 16 мм | 3 | 2.0 | 2.0
СС-0.110 | BR-8.3 | XD-8.2 | ParLan U/UTP 2х2х0,52 мм | 4 |  | 16 мм | 4 | 3.0 | 3.0
СС-0.111 | XD-8.2 | ША-6 | ParLan U/UTP 4х2х0,52 мм | 9 |  | 20 мм | 3 | 7.0 | 5.5 | 1.5
СС-0.112 | XD-8.2 | ША-6 | ParLan U/UTP 4х2х0,52 мм | 9
ПС-0.1 | ARK-1 | BTH-1 | КПСнг(А)-FRLS 1x2x0,5 мм | 2 |  |  |  | 1.5 | 1.5
ПС-0.2 | BTH-1 | BTH-2 | КПСнг(А)-FRLS 1x2x0,5 мм | 4 |  | 16 мм | 1 | 2.7 | 2.7
ПС-0.3 | BTH-2 | BTH-3 | КПСнг(А)-FRLS 1x2x0,5 мм | 6 |  | 16 мм | 1 | 4.6 | 3.6 | 1
ПС-0.4 | BTH-3 | BTH-4 | КПСнг(А)-FRLS 1x2x0,5 мм | 8 |  | 16 мм | 1 | 6.2 | 5.2 | 1
ПС-0.5 | BTH-4 | BTH-5 | КПСнг(А)-FRLS 1x2x0,5 мм | 9 |  | 16 мм | 1 | 7.4 | 6.4 | 1
ПС-0.6 | BTH-5 | BTH-6 | КПСнг(А)-FRLS 1x2x0,5 мм | 4 |  | 16 мм | 2 | 2.7 | 2.2 | 0.5
ПС-0.7 | BTAR-1 | BTH-7 | КПСнг(А)-FRLS 1x2x0,5 мм | 1 |  | 16 мм | 1 | 0.5 | 0.5
ПС-0.8 | BTH-7 | BTH-8 | КПСнг(А)-FRLS 1x2x0,5 мм | 4 |  | 16 мм | 3 | 3.0 | 2.0 | 1
ПС-0.9 | BTH-8 | BTH-9 | КПСнг(А)-FRLS 1x2x0,5 мм | 4 |  | 16 мм | 2 | 3.3 | 2.3 | 1
ПС-0.10 | BTAR-3 | ARK-1 | КПСнг(А)-FRLS 1x2x0,5 мм | 15 |  |  |  | 12.1 | 10.1 | 1.5 | 0.5
ПС-0.11 | BTH-6 | BTAR-1 | КПСнг(А)-FRLS 1x2x0,5 мм | 1
ПС-0.12 | BTAR-1 | BTK-3 | КПСнг(А)-FRLS 1x2x0,5 мм | 2
ПС-0.13 | BTH-9 | BTAR-2 | КПСнг(А)-FRLS 1x2x0,5 мм | 1
ПС-0.14 | BTAR-2 | BTK-4 | КПСнг(А)-FRLS 1x2x0,5 мм | 1
ПС-0.15 | BTAR-2 | BTAR-3 | КПСнг(А)-FRLS 1x2x0,5 мм | 1
ПС-0.16 | BTAR-3 | BTK-5 | КПСнг(А)-FRLS 1x2x0,5 мм | 6
ТС-1.1 | ША-2 | BGB-1.1 | КСПВ 2х0,50 мм | 6 |  | 16 мм | 1 | 4.9 | 4.2 | 0.7
ТС-1.2 | ША-2 | BGB-1.2 | КСПВ 2х0,50 мм | 12 |  | 16 мм | 2 | 9.9 | 9.5 | 0.4
ТС-1.3 | BGB-1.2 | BGB-1.3 | КСПВ 2х0,50 мм | 1 |  | 16 мм | 1 | 0.5 | 0.5
ТС-1.4 | ША-2 | BGB-1.4 | КСПВ 2х0,50 мм | 12
ТС-1.5 | BGB-1.4 | BGB-1.5 | КСПВ 2х0,50 мм | 1 |  |  |  | 0.5 | 0.5
ТС-1.6 | ША-2 | BL-1 | КСПВ 2х0,50 мм | 12
ТС-2.1 | ША-2 | BGB-2.1 | КСПВ 2х0,50 мм | 4 |  | 16 мм | 2 | 2.6 | 1.9 | 0.7
ТС-3.1 | ША-2 | BGB-3.1 | КСПВ 2х0,50 мм | 9 |  | 16 мм | 1 | 7.3 | 6.6 | 0.7
ТС-3.2 | BGB-3.1 | BGB-3.2 | КСПВ 2х0,50 мм | 1 |  |  |  | 0.5 | 0.5
ТС-3.3 | ША-2 | BL-3 | КСПВ 2х0,50 мм | 8 |  |  |  | 6.6 | 6.6
ТС-3.4 | ША-2 | BGB-3.3 | КСПВ 2х0,50 мм | 5 |  | 16 мм | 1 | 3.7 | 3.0 | 0.7
ТС-4.1 | ША-4 | BGB-4.1 | КСПВ 2х0,50 мм | 7 |  | 16 мм | 2 | 5.3 | 4.9 | 0.4
ТС-4.2 | BGB-4.1 | BGB-4.2 | КСПВ 2х0,50 мм | 1 |  | 16 мм | 1 | 0.5 | 0.5
ТС-4.3 | ША-4 | BGB-4.3 | КСПВ 2х0,50 мм | 7
ТС-4.4 | BGB-4.3 | BGB-4.4 | КСПВ 2х0,50 мм | 1 |  |  |  | 0.5 | 0.5
ТС-4.5 | ША-4 | BL-4 | КСПВ 2х0,50 мм | 7
ТС-4.6 | ША-4 | BGB-4.5 | КСПВ 2х0,50 мм | 7 |  | 16 мм | 1 | 5.4 | 4.7 | 0.7
ТС-5.1 | ША-5 | BGB-5.1 | КСПВ 2х0,50 мм | 6 |  | 16 мм | 3 | 5.0 | 4.6 | 0.4
ТС-5.2 | BGB-5.1 | BGB-5.2 | КСПВ 2х0,50 мм | 1 |  | 16 мм | 1 | 0.5 | 0.5
ТС-5.3 | ША-5 | BGB-5.3 | КСПВ 2х0,50 мм | 6
ТС-5.4 | BGB-5.3 | BGB-5.4 | КСПВ 2х0,50 мм | 1 |  |  |  | 0.5 | 0.5
ТС-5.5 | ША-5 | BL-5 | КСПВ 2х0,50 мм | 6
ТС-5.6 | ША-5 | BGB-5.5 | КСПВ 2х0,50 мм | 2 |  | 16 мм | 2 | 1.3 | 0.6 | 0.7
ТС-6.1 | ША-6 | BGB-6.1, BGB-6.2 | КСПВ 2х0,50 мм | 3 |  | 16 мм | 1 | 2.1 | 0.6 | 1.5
ТС-7.1 | ША-6 | BGB-7.1 | КСПВ 2х0,50 мм | 8 |  | 16 мм | 2 | 6.1 | 5.4 | 0.7
ТС-7.2 | ША-6 | BIGL-7 | ParLan U/UTP 2х2х0,52 мм | 9 |  | 16 мм | 4 | 6.9 | 5.4 | 1.5
ТС-8.1 | ША-6 | BGB-8.1 | КСПВ 2х0,50 мм | 6 |  | 16 мм | 2 | 4.7 | 4.0 | 0.7
ТС-8.2 | ША-6 | BIGL-8 | ParLan U/UTP 2х2х0,52 мм | 7 |  | 16 мм | 4 | 5.5 | 4.0 | 1.5
ТС-9.1 | ША-2 | BGB-9.1 | КСПВ 2х0,50 мм | 10 |  | 16 мм | 3 | 7.6 | 7.6
ТС-9.2 | BGB-9.1 | BGB-9.2 | КСПВ 2х0,50 мм | 3 |  | 16 мм | 3 | 1.7 | 1.7
ТС-9.3 | BGB-9.2 | BGB-9.3 | КСПВ 2х0,50 мм | 2 |  | 16 мм | 2 | 1.4 | 1.4

Sheet: щит
Наим.
Магистраль
X1 | Q1 | ПУГВ 1х10 бел.
X2 | Q1 | ПУГВ 1х10 гол.
Q1 | VA1 | 0,75 кор.
Q1 | VA1 | 0,75 гол.
VA1(I+) | T1(1) | ПУГВ 1х2,5 ч.
VA1(I-) | T1(2) | ПУГВ 1х2,5 б.
VA1(I-) | земля | ПУГВ 1х2,5 ж/з.
Q1 | UZM1 | ПУГВ 1х10 бел.
Q1 | UZM1 | ПУГВ 1х2,5 гол.
UZM1 | X94 | ПУГВ 1х10 бел.
Q1 | X95 | ПУГВ 1х10 гол.
X94 | QD1 | ПУГВ 1х10 бел.
X95 | QD1 | ПУГВ 1х10 гол.
X94 | QD6 | ПУГВ 1х10 бел.
X95 | QD6 | ПУГВ 1х10 гол.
QD7 | Q2 | ПУГВ 1х10 бел.
QD7 | Q2 | ПУГВ 1х10 гол.
QD12 | QD18 | ПУГВ 1х10 бел.
QD12 | QD18 | ПУГВ 1х10 гол.
X94 | QF15 | ПУГВ 1х2,5 бел.
X95 | ПС | ПУГВ 1х2,5 гол.
X3 | X92 | ПУГВ 1х10 ж/з.
X3 | UPS1 | ПУГВ 1х2,5 ж/з.
X3 | X96 | ПУГВ 1х2,5 ж/з.
Разводка
QD1 | QF1 | ПУГВ 1х2,5 бел.
QD1 | QF2 | ПУГВ 1х2,5 бел.
QD1 | QF3 | ПУГВ 1х2,5 бел.
QD1 | X4 | ПУГВ 1х10 гол.
QF1 | X25 | ПУГВ 1х2,5 бел.
QF2 | X26 | ПУГВ 1х2,5 бел.
QF3 | X27 | ПУГВ 1х2,5 бел.
X4 | X25 | ПУГВ 1х2,5 гол.
X4 | X26 | ПУГВ 1х2,5 гол.
X4 | X27 | ПУГВ 1х2,5 гол.
QD2 | QF4 | ПУГВ 1х2,5 бел.
QD2 | UPS1 | ПУГВ 1х2,5 гол.
QD3 | QF5 | ПУГВ 1х2,5 бел.
QD3 | QF6 | ПУГВ 1х2,5 бел.
QD3 | X5 | ПУГВ 1х10 гол.
QF5 | X28 | ПУГВ 1х2,5 бел.
QF6 | X29 | ПУГВ 1х2,5 бел.
QF6 | X30 | ПУГВ 1х2,5 бел.
X5 | X28 | ПУГВ 1х2,5 гол.
X5 | X29 | ПУГВ 1х2,5 гол.
X5 | X30 | ПУГВ 1х2,5 гол.
QD4 | QF7 | ПУГВ 1х2,5 бел.
QD4 | X31 | ПУГВ 1х2,5 гол.
QF7 | X31 | ПУГВ 1х2,5 бел.
QD5 | QF8 | ПУГВ 1х6 бел.
QD5 | QF9 | ПУГВ 1х4 бел.
QD5 | X32 | ПУГВ 1х6 гол.
QD5 | X33 | ПУГВ 1х4 гол.
QF8 | X32 | ПУГВ 1х6 бел.
QF9 | X33 | ПУГВ 1х4 бел.
QD6 | QF10 | ПУГВ 1х2,5 бел.
QD6 | X34 | ПУГВ 1х2,5 гол.
QF10 | X34 | ПУГВ 1х2,5 бел.
QD7 | QF11 | ПУГВ 1х2,5 бел.
QD7 | X35 | ПУГВ 1х2,5 гол.
QF11 | X35 | ПУГВ 1х2,5 бел.
QD8 | QF12 | ПУГВ 1х2,5 бел.
QD8 | X36 | ПУГВ 1х2,5 гол.
QF12 | X36 | ПУГВ 1х2,5 бел.
QD9 | QF13 | ПУГВ 1х2,5 бел.
QD9 | X37 | ПУГВ 1х2,5 гол.
QF13 | X37 | ПУГВ 1х2,5 бел.
QD10 | QF14 | ПУГВ 1х2,5 бел.
QD10 | X38 | ПУГВ 1х2,5 гол.
QF14 | X38 | ПУГВ 1х2,5 бел.
Q2 | QD11 | ПУГВ 1х6 бел.
Q2 | QD11 | ПУГВ 1х6 гол.
QD11 | QF16 | ПУГВ 1х2,5 бел.
QD11 | QF17 | ПУГВ 1х2,5 бел.
QD11 | X6 | ПУГВ 1х6 гол.
QF16 | X7 | ПУГВ 1х2,5 бел.
QF17 | K18(1) | ПУГВ 1х2,5 бел.
X7 | X39 | ПУГВ 1х2,5 бел.
X6 | X39 | ПУГВ 1х2,5 гол.
X6 | X41 | ПУГВ 1х2,5 гол.
X6 | X42 | ПУГВ 1х2,5 гол.
X6 | K18(2) | ПУГВ 1х2,5 гол.
K18(3) | X42 | ПУГВ 1х2,5 бел.
QD12 | QF18 | ПУГВ 1х6 бел.
QD12 | X43 | ПУГВ 1х6 гол.
QF18 | X43 | ПУГВ 1х6 бел.
QD13 | QF19 | ПУГВ 1х2,5 бел.
QD14 | QF20 | ПУГВ 1х2,5 бел.
QD14 | QF21 | ПУГВ 1х2,5 бел.
QD14 | X9 | ПУГВ 1х4 гол.
QF20 | X8 | ПУГВ 1х2,5 бел.
QF21 | X10 | ПУГВ 1х2,5 бел.
X8 | X45 | ПУГВ 1х2,5 бел.
X8 | X46 | ПУГВ 1х2,5 бел.
X8 | X47 | ПУГВ 1х2,5 бел.
X10 | ER1 | ПУГВ 1х2,5 бел.
X10 | X96 | ПУГВ 1х2,5 бел.
X10 | X48 | ПУГВ 1х2,5 бел.
X10 | X49 | ПУГВ 1х2,5 бел.
X10 | X50 | ПУГВ 1х2,5 бел.
X9 | ER1 | ПУГВ 1х2,5 гол.
X9 | X45 | ПУГВ 1х2,5 гол.
X9 | X46 | ПУГВ 1х2,5 гол.
X9 | X47 | ПУГВ 1х2,5 гол.
X9 | X96 | ПУГВ 1х2,5 гол.
X9 | X48 | ПУГВ 1х2,5 гол.
X9 | X49 | ПУГВ 1х2,5 гол.
X9 | X50 | ПУГВ 1х2,5 гол.
QD15 | QF22 | ПУГВ 1х2,5 бел.
QD15 | QF25 | ПУГВ 1х2,5 бел.
QD15 | X18 | 2 х ПУГВ 1х2,5 гол.
QF23 | X19 | ПУГВ 1х2,5 бел.
QF24 | X20 | ПУГВ 1х2,5 бел.
QF25 | X21 | ПУГВ 1х2,5 бел.
QF27 | K14.2(2) | ПУГВ 1х2,5 бел.
K14.2(1) | X22 | ПУГВ 1х2,5 бел.
QF22 | K4.2(2) | ПУГВ 1х2,5 бел.
K4.2(1) | X72 | ПУГВ 1х2,5 бел.
X18 | X72 | ПУГВ 1х2,5 гол.
X19 | K5.2(2) | ПУГВ 1х2,5 бел.
K5.2(1) | X73 | ПУГВ 1х2,5 бел.
X18 | X73 | ПУГВ 1х2,5 гол.
X19 | K5.3(4) | ПУГВ 1х2,5 бел.
K5.3(3) | X74 | ПУГВ 1х2,5 бел.
X18 | X74 | ПУГВ 1х2,5 гол.
X19 | K6.2(2) | ПУГВ 1х2,5 бел.
K6.2(1) | X75 | ПУГВ 1х2,5 бел.
X18 | X75 | ПУГВ 1х2,5 гол.
X19 | K7.2(2) | ПУГВ 1х2,5 бел.
K7.2(1) | X76 | ПУГВ 1х2,5 бел.
X18 | X76 | ПУГВ 1х2,5 гол.
X20 | K8.2(2) | ПУГВ 1х2,5 бел.
K8.2(1) | X77 | ПУГВ 1х2,5 бел.
X18 | X77 | ПУГВ 1х2,5 гол.
X20 | K9.2(2) | ПУГВ 1х2,5 бел.
K9.2(1) | X78 | ПУГВ 1х2,5 бел.
X18 | X78 | ПУГВ 1х2,5 гол.
X20 | K9.3(4) | ПУГВ 1х2,5 бел.
K9.3(3) | X79 | ПУГВ 1х2,5 бел.
X18 | X79 | ПУГВ 1х2,5 гол.
X21 | K10.2(2) | ПУГВ 1х2,5 бел.
K10.2(1) | X80 | ПУГВ 1х2,5 бел.
X18 | X80 | ПУГВ 1х2,5 гол.
X21 | K11.2(2) | ПУГВ 1х2,5 бел.
K11.2(1) | X81 | ПУГВ 1х2,5 бел.
X18 | X81 | ПУГВ 1х2,5 гол.
X21 | K12.2(2) | ПУГВ 1х2,5 бел.
K12.2(1) | X82 | ПУГВ 1х2,5 бел.
X18 | X82 | ПУГВ 1х2,5 гол.
QF26 | K13.2(2) | ПУГВ 1х2,5 бел.
K13.2(1) | X83 | ПУГВ 1х2,5 бел.
X18 | X83 | ПУГВ 1х2,5 гол.
QF26 | K13.3(4) | ПУГВ 1х2,5 бел.
K13.3(3) | X84 | ПУГВ 1х2,5 бел.
X18 | X84 | ПУГВ 1х2,5 гол.
X22 | X85 | ПУГВ 1х2,5 бел.
X18 | X85 | ПУГВ 1х2,5 гол.
X22 | X86 | ПУГВ 1х2,5 бел.
X18 | X86 | ПУГВ 1х2,5 гол.
QD16 | QF28 | ПУГВ 1х2,5 бел.
QF28 | K15.2(2) | ПУГВ 1х2,5 бел.
K15.2(1) | X87 | ПУГВ 1х2,5 бел.
QD16 | X87 | ПУГВ 1х2,5 гол.
QD17 | QF29 | ПУГВ 1х2,5 бел.
QF29 | K16.2(2) | ПУГВ 1х2,5 бел.
K16.2(1) | X24 | ПУГВ 1х2,5 бел.
QD17 | X23 | ПУГВ 1х2,5 гол.
X24 | X88 | ПУГВ 1х2,5 бел.
X23 | X88 | ПУГВ 1х2,5 гол.
X24 | X89 | ПУГВ 1х2,5 бел.
X23 | X89 | ПУГВ 1х2,5 гол.
QD18 | QF30 | ПУГВ 1х2,5 бел.
QF30 | K17.2(2) | ПУГВ 1х2,5 бел.
K17.2(1) | X90 | ПУГВ 1х2,5 бел.
QD18 | X90 | ПУГВ 1х2,5 гол.
QD18 | X91 | ПУГВ 1х2,5 гол.
QF30 | X91 | ПУГВ 1х2,5 бел.
Освещение
ER1 | X11 | ПУГВ 1х2,5 ч.
ER1 | X12 | ПУГВ 1х2,5 кр.
X11 | K4.1(А2) | ПУГВ 1х2,5 ч.
X11 | K5.1(А2) | ПУГВ 1х2,5 ч.
X11 | K6.1(А2) | ПУГВ 1х2,5 ч.
X11 | K7.1(А2) | ПУГВ 1х2,5 ч.
X11 | K8.1(А2) | ПУГВ 1х2,5 ч.
X11 | K9.1(А2) | ПУГВ 1х2,5 ч.
X11 | K15.1(А2) | ПУГВ 1х2,5 ч.
X11 | K10.1(А2) | ПУГВ 1х2,5 ч.
X11 | K11.1(А2) | ПУГВ 1х2,5 ч.
X11 | K12.1(А2) | ПУГВ 1х2,5 ч.
X11 | K13.1(А2) | ПУГВ 1х2,5 ч.
X11 | K14.1(А2) | ПУГВ 1х2,5 ч.
X11 | K16.1(А2) | ПУГВ 1х2,5 ч.
X11 | K17.1(А2) | ПУГВ 1х2,5 ч.
X11 | X61 | ПУГВ 1х2,5 ч.
X12 | X51 | ПУГВ 1х2,5 кр.
X12 | X52 | ПУГВ 1х2,5 кр.
X12 | X53 | ПУГВ 1х2,5 кр.
X12 | X54 | ПУГВ 1х2,5 кр.
X12 | X55 | ПУГВ 1х2,5 кр.
X12 | X56 | ПУГВ 1х2,5 кр.
X12 | X57 | ПУГВ 1х2,5 кр.
X12 | X58 | ПУГВ 1х2,5 кр.
X12 | X59 | ПУГВ 1х2,5 кр.
X12 | X60 | ПУГВ 1х2,5 кр.
X12 | X62 | ПУГВ 1х2,5 кр.
X12 | X63 | ПУГВ 1х2,5 кр.
X12 | X64 | ПУГВ 1х2,5 кр.
X12 | X65 | ПУГВ 1х2,5 кр.
X12 | X66 | ПУГВ 1х2,5 кр.
X12 | X67 | ПУГВ 1х2,5 кр.
X12 | X68 | ПУГВ 1х2,5 кр.
X12 | X70 | ПУГВ 1х2,5 кр.
X12 | X71 | ПУГВ 1х2,5 кр.
K4.1(А1) | X51 | ПУГВ 1х2,5 бел.
K5.1(А1) | X52 | ПУГВ 1х2,5 бел.
K6.1(А1) | X53 | ПУГВ 1х2,5 бел.
K7.1(А1) | X54 | ПУГВ 1х2,5 бел.
K8.1(А1) | X55 | ПУГВ 1х2,5 бел.
K9.1(А1) | X56 | ПУГВ 1х2,5 бел.
K15.1(А1) | X15 | ПУГВ 1х2,5 бел.
X15 | X58 | ПУГВ 1х2,5 бел.
X15 | X59 | ПУГВ 1х2,5 бел.
K10.1(А1) | X62 | ПУГВ 1х2,5 бел.
K11.1(А1) | X63 | ПУГВ 1х2,5 бел.
K12.1(А1) | X64 | ПУГВ 1х2,5 бел.
K13.1(А1) | X16 | ПУГВ 1х2,5 бел.
X16 | X65 | ПУГВ 1х2,5 бел.
X16 | X66 | ПУГВ 1х2,5 бел.
K14.1(А1) | X17 | ПУГВ 1х2,5 бел.
X17 | X57 | ПУГВ 1х2,5 бел.
X17 | X67 | ПУГВ 1х2,5 бел.
X17 | X68 | ПУГВ 1х2,5 бел.
K16.1(А1) | X70 | ПУГВ 1х2,5 бел.
K17.1(А1) | X71 | ПУГВ 1х2,5 бел.
