antony-sm/Ovrajnaya_stadia_RD/04 ЭОМ СС/перечень элементов щита.xls

Sheet: щит
Обозначение | Наименование | Кол. | Примечание
 | Модульное оборудование
Q1,Q2 | Выключатель ABB SD202/63 | 2
UZM1 | Устройство защитное РН-260t | 1
VA1 | Прибор комбинированный OMIX P94-ML-1-0,5-RS485 | 1
T1 | Трансформатор тока ABB TRFM/60 | 1
ER1 | Источник питания «МОЛЛЮСК-12/1,3 DIN» | 1
UPS1 | ИБП Штиль STR1101SL | 1 | 490х88х400
QF1..QF7 | Выключатель автоматический ABB S201-B16 | 7
QF8 | Выключатель автоматический ABB S201-C32 | 1
QF9 | Выключатель автоматический ABB S201-C20 | 1
QF10..QF14 | Выключатель автоматический ABB S201-B16 | 5
QF15 | Выключатель автоматический ABB S201-C10 | 1
QF16,QF17 | Выключатель автоматический ABB S201-C16 | 2
QF18 | Выключатель автоматический ABB S201-C32 | 1
QF19 | Выключатель автоматический ABB S201-C16 | 1
QF20,QF21 | Выключатель автоматический ABB S201-C10 | 2
QF22..QF30 | Выключатель автоматический ABB S201-B10 | 9
QD0 | существующее | 1
QD1 | Устройство защитного отключения ABB F202 A-63/0.03 | 1
QD2 | Устройство защитного отключения ABB F202 A-25/0.03 | 1
QD3 | Устройство защитного отключения ABB F202 A-40/0.03 | 1
QD4 | Устройство защитного отключения ABB F202 A-16/0.01 | 1
QD5 | Устройство защитного отключения ABB F202 A-63/0.03 | 1
QD6..QD10 | Устройство защитного отключения ABB F202 A-16/0.01 | 5
QD11,QD12 | Устройство защитного отключения ABB F202 A-40/0.03 | 2
QD13 | Устройство защитного отключения ABB F202 A-16/0.01 | 1
QD14 | Устройство защитного отключения ABB F202 A-40/0.03 | 1
QD15 | Устройство защитного отключения ABB F202 A-63/0.03 | 1
QD16..QD18 | Устройство защитного отключения ABB F202 A-16/0.01 | 3
K1,K2 | Расцепитель независимый ABB S2C-A1 | 2
K4 | Реле блокировочное ABB E290-16-10/24 | 1
K5 | Реле блокировочное ABB E291S-16-20/24 | 1
K6..K8 | Реле блокировочное ABB E290-16-10/24 | 3
K9 | Реле блокировочное ABB E291S-16-20/24 | 1
K10..K12 | Реле блокировочное ABB E290-16-10/24 | 3
K13 | Реле блокировочное ABB E291S-16-20/24 | 1
K14..K17 | Реле блокировочное ABB E290-16-10/24 | 4
K18 | Реле напряжения РН-104 | 1
 | Клеммы
X1..X3 | Блок ИЕК ШНК4х7 | 1
X4..X6 | Блок JHUKK-80 | 3
X7 | Клемма ABB ZS4 | 3
 | Перемычка ABB JB5 | 1
X8 | Клемма ABB ZS4 | 4
 | Перемычка ABB JB5 | 1
X9 | Блок JHUKK-80 | 2
X10 | Клемма ABB ZS4 | 3
 | Перемычка ABB JB5 | 1
X11 | Блок JHUKK-80 | 3
X12 | Блок JHUKK-80 | 4
X15 | Клемма ABB ZS4 | 2
 | Перемычка ABB JB5 | 1
X16 | Клемма ABB ZS4 | 2
 | Перемычка ABB JB5 | 1
X17 | Клемма ABB ZS4 | 2
 | Перемычка ABB JB5 | 1
X18 | Блок JHUKK-80 | 4
X19 | Клемма ABB ZS4 | 3
 | Перемычка ABB JB5 | 1
X20 | Клемма ABB ZS4 | 2
 | Перемычка ABB JB5 | 1
X21 | Клемма ABB ZS4 | 2
 | Перемычка ABB JB5 | 1
X22 | Клемма ABB ZS4 | 2
 | Перемычка ABB JB5 | 1
X23 | Клемма ABB ZS4-BL | 2
 | Перемычка ABB JB5 | 1
X24 | Клемма ABB ZS4 | 2
 | Перемычка ABB JB5 | 1
X25 | Клемма ABB ZS4 | 1
 | Клемма ABB ZS4-BL | 1
X26 | Клемма ABB ZS4 | 1
 | Клемма ABB ZS4-BL | 1
X27 | Клемма ABB ZS4 | 1
 | Клемма ABB ZS4-BL | 1
X28 | Клемма ABB ZS4 | 1
 | Клемма ABB ZS4-BL | 1
X29 | Клемма ABB ZS4 | 1
 | Клемма ABB ZS4-BL | 1
X30 | Клемма ABB ZS4 | 1
 | Клемма ABB ZS4-BL | 1
X31 | Клемма ABB ZS4 | 1
 | Клемма ABB ZS4-BL | 1
X32 | Клемма NSYTRV62 | 1
 | Клемма NSYTRV62BL | 1
X33 | Клемма ABB ZS4 | 1
 | Клемма ABB ZS4-BL | 1
X34 | Клемма ABB ZS4 | 1
 | Клемма ABB ZS4-BL | 1
X35 | Клемма ABB ZS4 | 1
 | Клемма ABB ZS4-BL | 1
X36 | Клемма ABB ZS4 | 1
 | Клемма ABB ZS4-BL | 1
X37 | Клемма ABB ZS4 | 1
 | Клемма ABB ZS4-BL | 1
X38 | Клемма ABB ZS4 | 1
 | Клемма ABB ZS4-BL | 1
X39 | Клемма ABB ZS4 | 1
 | Клемма ABB ZS4-BL | 1
X40 | Клемма ABB ZS4 | 1
 | Клемма ABB ZS4-BL | 1
X41 | Клемма ABB ZS4 | 1
 | Клемма ABB ZS4-BL | 1
X42 | Клемма ABB ZS4 | 1
 | Клемма ABB ZS4-BL | 1
X43 | Клемма NSYTRV62 | 1
 | Клемма NSYTRV62BL | 1
X44 | Клемма ABB ZS4 | 1
 | Клемма ABB ZS4-BL | 1
X45 | Клемма ABB ZS4 | 1
 | Клемма ABB ZS4-BL | 1
X46 | Клемма ABB ZS4 | 1
 | Клемма ABB ZS4-BL | 1
X47 | Клемма ABB ZS4 | 1
 | Клемма ABB ZS4-BL | 1
X48 | Клемма MRK 4 1652 | 1
 | Клемма ABB ZS4 | 1
 | Клемма ABB ZS4-BL | 1
X49 | Клемма ABB ZS4 | 1
 | Клемма ABB ZS4-BL | 1
 | Клемма ABB ZS4 | 1
X50 | Клемма ABB ZS4 | 1
 | Клемма ABB ZS4-BL | 1
 | Клемма ABB ZS4 | 1
X51..X71 | Клемма MRK 4 1652 | 21
X72 | Клемма ABB ZS4 | 1
 | Клемма ABB ZS4-BL | 1
X73 | Клемма ABB ZS4 | 1
 | Клемма ABB ZS4-BL | 1
X74 | Клемма ABB ZS4 | 1
 | Клемма ABB ZS4-BL | 1
X75 | Клемма ABB ZS4 | 1
 | Клемма ABB ZS4-BL | 1
X76 | Клемма ABB ZS4 | 1
 | Клемма ABB ZS4-BL | 1
X77 | Клемма ABB ZS4 | 1
 | Клемма ABB ZS4-BL | 1
X78 | Клемма ABB ZS4 | 1
 | Клемма ABB ZS4-BL | 1
X79 | Клемма ABB ZS4 | 1
 | Клемма ABB ZS4-BL | 1
X80 | Клемма ABB ZS4 | 1
 | Клемма ABB ZS4-BL | 1
X81 | Клемма ABB ZS4 | 1
 | Клемма ABB ZS4-BL | 1
X82 | Клемма ABB ZS4 | 1
 | Клемма ABB ZS4-BL | 1
X83 | Клемма ABB ZS4 | 1
 | Клемма ABB ZS4-BL | 1
X84 | Клемма ABB ZS4 | 1
 | Клемма ABB ZS4-BL | 1
X85 | Клемма ABB ZS4 | 1
 | Клемма ABB ZS4-BL | 1
X86 | Клемма ABB ZS4 | 1
 | Клемма ABB ZS4-BL | 1
X87 | Клемма ABB ZS4 | 1
 | Клемма ABB ZS4-BL | 1
X88 | Клемма ABB ZS4 | 1
 | Клемма ABB ZS4-BL | 1
X89 | Клемма ABB ZS4 | 1
 | Клемма ABB ZS4-BL | 1
X90 | Клемма ABB ZS4 | 1
 | Клемма ABB ZS4-BL | 1
X91 | Клемма ABB ZS4 | 1
 | Клемма ABB ZS4-BL | 1
 | Клемма MRK 4 1652 | 1
X92 | Шина ABB 12535 (25 отв.) | 1
 | Держатель шины ABB 12541 | 1
X93 | Шина ABB 12535 (25 отв.) | 1
 | Держатель шины ABB 12541 | 1
X94 | Блок JHUKK-80 | 1 | после УЗМ
X95 | Блок JHUKK-80 | 1 | после УЗМ
X96 | Розетки со шторкой | 2
 | Слаботочное оборудование
X100 | Блок ИЕК ШНК4х7 | 1
X101 | Блок розеток 19" 8 розеток евро, 16А, клеммное подключение — MDX-PDU-8E-16A-Term | 1
X102..X120 | Клеммы
TX0 | PP3-19-16-8P8C-C5E-110D Патч-панель 19", 1U, 16 портов RJ-45, категория 5e | 1 | 483x44x44
SW0 | TP-LINK T2600G-28TS, коммутатор 24 порта управляемый | 1
KRB0 | Rexant 05-6002, разветвитель ТВ 1 на 3 | 1
 | Аудио
PC1..PC5 | Paspberry Pi B+, компьютер одноплатный | 5
 | HiFiBerry Amp2, аудиомодуль | 5
 | Steel case for HiFiBerry Amp2 | 5
ER2 | МОЛЛЮСК-12/10 IP20-DIN, источник питания 12В 10А | 1
X121,X122 | Блок JHUKK-80 | 2
 | Автоматика
PC0 | Paspberry Pi 3B, компьютер одноплатный | 1 | сервер, есть
 | Официальный корпус для Raspberry Pi 3 красно-белый | 1
 | Адаптер 5В 1А, USB | 1
 | Шнур USB-microUSB | 1
CNV1..CNV3 | Преобразователь USB-RS485 | 3
 | Удлинитель USB | 3
TR1 | Теплолюкс ТР 510, терморегулятор | 1 | 220В
TR2 | TC F-3,7/1, терморегулятор | 1 | 220В
TR3 | Kentatsu AF-KS, контроллер | 1
K20 | ABB CR-P012DC1, реле промежуточное 12В 1 перекл. | 1 | 12В
 | ABB CR-PLSx, колодка реле | 1
K21 | ABB CR-P012DC1, реле промежуточное 12В 1 перекл. | 1 | 12В
 | ABB CR-PLSx, колодка реле | 1
 | Клемма ABB ZS4 | 5
BP1..BP7 | Датчик давления QBM2030-1U | 7 | 24В
 | Блок питания увлажнителя | 1
K3 | Реле влажности RH-1 | 1
X123 | Клемма ABB ZS4 | 1
X124 | Клемма ABB ZS4 | 2
 | Перемычка ABB JB5 | 1
X125 | Клемма ABB ZS4 | 2
 | Перемычка ABB JB5 | 1
ER3 | Блок питания 1ф выход 24В пост. тока 2,5А стабилизированный MDR-60-24 | 1
ER4 | Блок питания MDR-20-12 1ф выход 12В пост. тока 1,7А стабилизированный | 1
X126..X129 | Блок JHUKK-80 | 4
 | Пожарная сигнализация
ARK-1 | Контроллер двухпроводной линии С2000-КДЛ | 1
ARK-2 | Пульт контроля и управления С2000М | 1
K-1 | Блок реле С2000-СП1 | 1
ER5 | СКАТ-1200С, источник питания | 1
 | Аккумулятор 12В 7Ач | 1
 | Кросс
 | Плинт LSA-PLUS 2/10 10 пар неразмык. контакты маркировка 0…9 | 6
 | Хомут KR-FRAME-30 монтажный на 3 плинта 2/10 глубина 30мм шаг 22,5мм (Hyperline Тайвань) | 2
 | Кабели и шнуры
1 | Патч-корд | 21
 | F-разъем | 4

Sheet: для спеки
0 | 18
Выключатель автоматический ABB S201-B10 | 9
Выключатель автоматический ABB S201-B16 | 12
Выключатель автоматический ABB S201-C10 | 3
Выключатель автоматический ABB S201-C16 | 3
Выключатель автоматический ABB S201-C20 | 1
Выключатель автоматический ABB S201-C32 | 2
Выключатель ABB SD202/63 | 2
Держатель шины ABB 12541 | 2
Источник питания «МОЛЛЮСК-12/1,3 DIN» | 1
Блок JHUKK-80 | 18
Клемма ABB ZCBC10GR | 1
Клемма ABB ZCBI10 | 1
Клемма ABB ZS4 | 73
Клемма ABB ZS4-BL | 46
Клемма MRK 4 1652 | 23
Клемма NSYTRV62 | 2
Клемма NSYTRV62BL | 2
Перемычка ABB JB5 | 12
Прибор комбинированный OMIX P94-ML-1-0,5-RS485 | 1
Расцепитель независимый ABB S2C-A1 | 2
Реле блокировочное ABB E290-16-10/24 | 11
Реле блокировочное ABB E291S-16-20/24 | 3
Реле влажности RH-1 | 1
Реле напряжения РН-104 | 1
Розетки со шторкой | 2
Трансформатор тока ABB TRFM/60 | 1
Устройство защитного отключения ABB F202 A S-63/0.1 | 1
Устройство защитного отключения ABB F202 A-16/0.01 | 10
Устройство защитного отключения ABB F202 A-25/0.03 | 1
Устройство защитного отключения ABB F202 A-40/0.03 | 4
Устройство защитного отключения ABB F202 A-63/0.03 | 3
Устройство защитное РН-260t | 1
Шина ABB 12535 (25 отв.) | 2
Э1322 | 1
APC Smart-UPS XL 1000 ВА, ИБП | 1
Блок РБД-80А | 3
Блок РБД-80А | 2
Блок РБД-80А | 3
Блок РБД-80А | 4
Блок РБД-80А | 4
Блок РБД-80А | 1 | после УЗМ
Блок РБД-80А | 1 | после УЗМ
Выключатель автоматический ABB S201-B10 | 9
Выключатель автоматический ABB S201-B16 | 7
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
Устройство защитного отключения ABB F202 A-63/0.03 | 1
Устройство защитного отключения ABB F202 A-63/0.03 | 1
Устройство защитное РН-260t | 1
Шина ABB 12535 (25 отв.) | 1
Шина ABB 12535 (25 отв.) | 1
Э1322 | 1
APC Smart-UPS XL 1000 ВА, ИБП | 1
