antony-sm/Ovrajnaya_stadia_RD/04 ЭОМ СС/расчеты.xls

Sheet: потребление
Потребитель | Мощность, кВт | Кол-во | Коэффициент спроса | Общее, кВт
Климатика
Кондиционер | 2.13 | 1 | 0.35 | 0.7455
Канальный нагреватель | 2.1 | 1 | 0.35 | 0.735
Вентилятор канальный | 0.02 | 1 | 0.9 | 0.018
Увлажнитель | 0.05 | 1 | 0.5 | 0.025
Приводы | 0.0041 | 9 | 0.01 | 0.000369
Теплый пол | 0.6 | 1 | 0.5 | 0.3
Бытовая техника
Стиральная машина | 2 | 1 | 0.6 | 1.2
Сушильная машина | 2.8 | 1 | 0.6 | 1.68
Варочная панель | 7 | 1 | 0.4 | 2.8
Духовой шкаф | 3 | 1 | 0.32 | 0.96
Посудомоечная машина | 1 | 1 | 0.8 | 0.8
Мультиварка | 0.5 | 1 | 0.4 | 0.2
Микроволновка | 1.4 | 1 | 0.2 | 0.28
Холодильник | 0.6 | 1 | 0.5 | 0.3
Водонагреватель | 6 | 1 | 0.3 | 1.8
Утюг | 1.8 | 1 | 0.3 | 0.54
Фен | 1.2 | 1 | 0.3 | 0.36
Чайник/кофеварка | 1.2 | 1 | 0.3 | 0.36
Пылесос | 1 | 1 | 0.3 | 0.3
Электроника
Телевизор | 0.3 | 3 | 0.5 | 0.45
Компьютер | 0.5 | 1 | 1 | 0.5
Монитор | 0.1 | 2 | 1 | 0.2
Сервер | 0.2 | 1 | 1 | 0.2
Принтер | 0.5 | 1 | 0.05 | 0.025
Слаботочка | 0.1 | 1 | 1 | 0.1
Освещение
Спальня | 0.08 | 1 | 0.7 | 0.056
Кабинет | 0.08 | 1 | 0.7 | 0.056
Кладовая | 0.02 | 1 | 0.7 | 0.014
Коридор | 0.18 | 1 | 0.7 | 0.126
Детская | 0.08 | 1 | 0.7 | 0.056
Кухня | 0.06 | 1 | 0.7 | 0.042
Туалет | 0.02 | 1 | 0.7 | 0.014
Ванная | 0.04 | 1 | 0.7 | 0.028
Лоджия | 0.02 | 1 | 0.7 | 0.014
ИТОГО |  |  |  | 15.284869

Sheet: шкаф
Наименование | № кабеля | Тип кабеля | Номинал и тип автомата | Клеммы | Примеч.
Розетки спальня | ЭОМ-1.1 | ВВГнг(А)-LS 3x2,5 | 16 A, тип B
Розетки кладовая | ЭОМ-2.1 | ВВГнг(А)-LS 3x2,5 | 16 A, тип B
Розетки кабинет | ЭОМ-3.1 | ВВГнг(А)-LS 3x2,5 | 16 A, тип B
Розетки ИБП кабинет | ЭОМ-3.9 | ВВГнг(А)-LS 3x2,5 | 16 A, тип B
Розетки детская | ЭОМ-4.1 | ВВГнг(А)-LS 3x2,5 | 16 A, тип B
Варочная панель | ЭОМ-5.1 | ВВГнг(А)-LS 3x6 | 32 A, тип C
Духовка | ЭОМ-5.2 | ВВГнг(А)-LS 3x4 | 20 A, тип C
Розетки коридора | ЭОМ-6.1 | ВВГнг(А)-LS 3x2,5 | 16 A, тип B
 | ЭОМ-6.9 | ВВГнг(А)-LS 3x2,5
Стиральная машина | ЭОМ-7.1 | ВВГнг(А)-LS 3x2,5 | 16 A, тип B
Сушильная машина | ЭОМ-7.2 | ВВГнг(А)-LS 3x2,5 | 16 A, тип B
Розетки ванной | ЭОМ-7.3 | ВВГнг(А)-LS 3x2,5 | 16 A, тип B
Розетки туалет | ЭОМ-8.1 | ВВГнг(А)-LS 3x2,5 | 16 A, тип B
Розетки лоджия | ЭОМ-9.1 | ВВГнг(А)-LS 3x2,5 | 16 A, тип B
Вентилятор | ЭОМ-1.31 | ВВГнг(А)-LS 3x2,5 | 16 A, тип C
Нагреватель | ЭОМ-1.32 | ВВГнг(А)-LS 3x2,5
Кондиционер | ЭОМ-2.31 | ВВГнг(А)-LS 3x2,5 | 16 A, тип C
Увлажнитель | ЭОМ-8.31 | ВВГнг(А)-LS 3x1,5 | 10 A, тип C
 | ЭОМ-8.33 | ВВГнг(А)-LS 2x1,5 | - (36 В)
Водонагреватель | ЭОМ-8.32 | ВВГнг(А)-LS 3x6 | 32 A, тип C
Теплый пол | ЭОМ-9.31 | ВВГнг(А)-LS 3x2,5 | 16 A, тип C
Автоматика, ША, слаботочное оборудование | ЭОМ-0.1 | ВВГнг(А)-LS 3x1,5 | 10 A, тип C
 | ЭОМ-0.2 | ВВГнг(А)-LS 3x1,5
 | ЭОМ-0.3 | ВВГнг(А)-LS 3x1,5
Кнопка звонка | ЭОМ-0.4 | ВВГнг(А)-LS 2x1,5 | - (24 В)
Звонок | ЭОМ-0.5 | ВВГнг(А)-LS 2x1,5 | - (24 В)
Кнопки спальня | ЭОМ-1.57 | ВВГнг(А)-LS 2x1,5 | 10 A, тип B
 | ЭОМ-1.58 | ВВГнг(А)-LS 2x1,5
 | ЭОМ-1.59 | ВВГнг(А)-LS 2x1,5
Кнопка кладовой | ЭОМ-2.54 | ВВГнг(А)-LS 2x1,5
Кнопки кабинета | ЭОМ-3.56 | ВВГнг(А)-LS 2x1,5
 | ЭОМ-3.59 | ВВГнг(А)-LS 2x1,5
 | ЭОМ-3.61 | ВВГнг(А)-LS 2x1,5
Кнопки детской | ЭОМ-4.54 | ВВГнг(А)-LS 2x1,5
 | ЭОМ-4.58 | ВВГнг(А)-LS 2x1,5
 | ЭОМ-4.60 | ВВГнг(А)-LS 2x1,5
Кнопки кухни | ЭОМ-5.57 | ВВГнг(А)-LS 2x1,5
 | ЭОМ-5.58 | ВВГнг(А)-LS 2x1,5
Кнопки коридора | ЭОМ-6.55 | ВВГнг(А)-LS 2x1,5
 | ЭОМ-6.56 | ВВГнг(А)-LS 2x1,5
 | ЭОМ-6.61 | ВВГнг(А)-LS 2x1,5
 | ЭОМ-6.64 | ВВГнг(А)-LS 2x1,5
 | ЭОМ-6.66 | ВВГнг(А)-LS 2x1,5
 | ЭОМ-6.67 | ВВГнг(А)-LS 2x1,5
 | --//-- | ВВГнг(А)-LS 2x1,5
Датчики коридора | ЭОМ-6.68 | ВВГнг(А)-LS 3x1,5
 | ЭОМ-6.69 | ВВГнг(А)-LS 3x1,5
Кнопки туалет | ЭОМ-8.55 | ВВГнг(А)-LS 2x1,5
Кнопки лоджия | ЭОМ-9.53 | ВВГнг(А)-LS 2x1,5
Светильники спальня | ЭОМ-1.51 | ВВГнг(А)-LS 3x1,5 | 10 A, тип B
 | ЭОМ-1.52 | ВВГнг(А)-LS 3x1,5
 | ЭОМ-1.55 | ВВГнг(А)-LS 3x1,5
 | ЭОМ-1.56 | ВВГнг(А)-LS 3x1,5
Светильники кладовая | ЭОМ-2.51 | ВВГнг(А)-LS 3x1,5 | 10 A, тип B
Светильники кабинет | ЭОМ-3.51 | ВВГнг(А)-LS 3x1,5 | 10 A, тип B
 | ЭОМ-3.52 | ВВГнг(А)-LS 3x1,5
 | ЭОМ-3.55 | ВВГнг(А)-LS 3x1,5
Светильники детская | ЭОМ-4.51 | ВВГнг(А)-LS 3x1,5 | 10 A, тип B
 | ЭОМ-4.52 | ВВГнг(А)-LS 3x1,5
 | ЭОМ-4.53 | ВВГнг(А)-LS 3x1,5
Светильники кухня | ЭОМ-5.51 | ВВГнг(А)-LS 3x1,5 | 10 A, тип B
 | ЭОМ-5.52 | ВВГнг(А)-LS 3x1,5
Светильники коридор | ЭОМ-6.51 | ВВГнг(А)-LS 3x1,5 | 10 A, тип B
 | ЭОМ-6.54 | ВВГнг(А)-LS 3x1,5
Светильники ванная | ЭОМ-7.51 | ВВГнг(А)-LS 3x1,5 | 10 A, тип B
 | ЭОМ-7.56 | ВВГнг(А)-LS 3x1,5
Светильники туалет | ЭОМ-8.51 | ВВГнг(А)-LS 3x1,5 | 10 A, тип B
 | ЭОМ-8.54 | ВВГнг(А)-LS 3x1,5
Светильники лоджия | ЭОМ-9.51 | ВВГнг(А)-LS 3x1,5 | 10 A, тип B
Пожарная сигнализация | - |  | 10 A, тип C | - | Без УЗО!
Собственные нужды шкафа | ЭОМ-6.8 | ВВГнг(А)-LS 3x2,5 | 10 A, тип B
 | ЭОМ-6.65 | ВВГнг(А)-LS 3x1,5
Подсчёт
10 A, тип C | 3
10 A, тип B | 11
16 A, тип B | 11
16 A, тип C | 3
20 A, тип C | 1
32 A, тип C | 2
---------------------------------------------
10 A, тип C | 1
10 A, тип C | 1
10 A, тип C | 1
10 A, тип B | 1
10 A, тип B | 1
10 A, тип B | 1
10 A, тип B | 1
10 A, тип B | 1
10 A, тип B | 1
10 A, тип B | 1
10 A, тип B | 1
10 A, тип B | 1
10 A, тип B | 1
10 A, тип B | 1
16 A, тип B | 1
16 A, тип B | 1
16 A, тип B | 1
16 A, тип B | 1
16 A, тип B | 1
16 A, тип B | 1
16 A, тип B | 1
16 A, тип B | 1
16 A, тип B | 1
16 A, тип B | 1
16 A, тип B | 1
16 A, тип C | 1
16 A, тип C | 1
16 A, тип C | 1
20 A, тип C | 1
32 A, тип C | 1
32 A, тип C | 1

Sheet: приход кабелей
Слева по плану |  |  | Номер клемм |  | Отв. PE
ЭОМ-0.1 | ША.6 | ША.2 | X45 | ВВГнг(А)-LS 3x1,5 | 1
ЭОМ-1.1 | ША.6 | XD-1.1 | X25 | ВВГнг(А)-LS 3x2,5 | 1
ЭОМ-1.31 | ША.6 | XF-1.1 | X39 | ВВГнг(А)-LS 3x2,5 | 1
ЭОМ-1.32 | ША.6 | XF-1.2 | X40 | ВВГнг(А)-LS 3x2,5 | 1
ЭОМ-1.51 | ША.6 | HL-1.1 | X73 | ВВГнг(А)-LS 3x1,5 | 1
ЭОМ-1.52 | ША.6 | XD-1.3 | X74 | ВВГнг(А)-LS 3x1,5 | 1
ЭОМ-1.55 | ША.6 | HL-1.4 | X75 | ВВГнг(А)-LS 3x1,5 | 1
ЭОМ-1.56 | ША.6 | HL-1.5 | X76 | ВВГнг(А)-LS 3x1,5 | 1
ЭОМ-1.57 | ША.6 | QS-1.2 | X53 | ВВГнг(А)-LS 2x1,5
ЭОМ-1.58 | ША.6 | QS-1.3 | X54 | ВВГнг(А)-LS 2x1,5
ЭОМ-1.59 | ША.6 | XD-1.6 | X52 | ВВГнг(А)-LS 2x1,5
ЭОМ-2.1 | ША.6 | XD-2.1 | X26 | ВВГнг(А)-LS 3x2,5 | 1
ЭОМ-2.31 | ША.6 | XF-2.1 | X42 | ВВГнг(А)-LS 3x2,5 | 1
ЭОМ-2.51 | ША.6 | XD-2.1 | X72 | ВВГнг(А)-LS 3x1,5 | 1
ЭОМ-2.54 | ША.6 | QS-2.1 | X51 | ВВГнг(А)-LS 2x1,5
ЭОМ-3.1 | ША.6 | XD-3.1 | X27 | ВВГнг(А)-LS 3x2,5 | 1
ЭОМ-3.51 | ША.6 | HL-3.1 | X77 | ВВГнг(А)-LS 3x1,5 | 1
ЭОМ-3.52 | ША.6 | XD-3.4 | X78 | ВВГнг(А)-LS 3x1,5 | 1
ЭОМ-3.55 | ША.6 | HL-3.3 | X79 | ВВГнг(А)-LS 3x1,5 | 1
ЭОМ-3.56 | ША.6 | XD-3.1 | X55 | ВВГнг(А)-LS 2x1,5
ЭОМ-3.59 | ША.6 | QS-3.2 | X56 | ВВГнг(А)-LS 2x1,5
ЭОМ-3.61 | ША.6 | QS-3.3 | X58 | ВВГнг(А)-LS 2x1,5
ЭОМ-3.9 | ША.6 | XS-3.16..XS-3.19 | - | ВВГнг(А)-LS 3x2,5 | 1
ЭОМ-6.1 | ША.6 | XD-6.1 | X29 | ВВГнг(А)-LS 3x2,5 | 1
ЭОМ-6.51 | ША.6 | XD-6.1 | X85 | ВВГнг(А)-LS 3x1,5 | 1
ЭОМ-6.56 | ША.6 | XD-6.3 | X57 | ВВГнг(А)-LS 2x1,5
ЭОМ-6.65 | ША.6 | HL-6.4 | X48 | ВВГнг(А)-LS 3x1,5 | 1
ЭОМ-6.66 | ША.6 | QS-6.8 | X48 | ВВГнг(А)-LS 2x1,5
ЭОМ-6.68 | ША.6 | BGRV-6.1 | X49 | ВВГнг(А)-LS 3x1,5 | 1
ЭОМ-9.1 | ША.6 | XS-9.1,XS-9.2 | X38 | ВВГнг(А)-LS 3x2,5 | 1
ЭОМ-9.31 | ША.6 | XF-9.1 | X44 | ВВГнг(А)-LS 3x2,5 | 1
ЭОМ-9.51 | ША.6 | HL-9.1 | X87 | ВВГнг(А)-LS 3x1,5 | 1
ЭОМ-9.53 | ША.6 | QS-9.1 | X59 | ВВГнг(А)-LS 2x1,5
 |  |  |  |  | 23
Справа по плану |  |  |  |  | Отв. PE
ЭОМ-0.2 | ША.6 | ША.4 | X46 | ВВГнг(А)-LS 3x1,5 | 1
ЭОМ-0.3 | ША.6 | ША.5 | X47 | ВВГнг(А)-LS 3x1,5 | 1
ЭОМ-0.4 | ША.6 | KB-1 | X60 | ВВГнг(А)-LS 2x1,5
ЭОМ-0.5 | ША.6 | HA-1 | X61 | ВВГнг(А)-LS 2x1,5
ЭОМ-4.1 | ША.6 | XD-4.1 | X28 | ВВГнг(А)-LS 3x2,5 | 1
ЭОМ-4.51 | ША.6 | HL-4.1 | X80 | ВВГнг(А)-LS 3x1,5 | 1
ЭОМ-4.52 | ША.6 | HL-4.2 | X81 | ВВГнг(А)-LS 3x1,5 | 1
ЭОМ-4.53 | ША.6 | HL-4.3 | X82 | ВВГнг(А)-LS 3x1,5 | 1
ЭОМ-4.54 | ША.6 | XD-4.1 | X62 | ВВГнг(А)-LS 2x1,5
ЭОМ-4.58 | ША.6 | QS-4.2 | X63 | ВВГнг(А)-LS 2x1,5
ЭОМ-4.60 | ША.6 | QS-4.3 | X64 | ВВГнг(А)-LS 2x1,5
ЭОМ-5.1 | ША.6 | XS-5.1 | X32 | ВВГнг(А)-LS 3x6 | 1
ЭОМ-5.2 | ША.6 | XS-5.2 | X33 | ВВГнг(А)-LS 3x4 | 1
ЭОМ-5.3 | ША.6 | XD-5.1 | X31 | ВВГнг(А)-LS 3x2,5 | 1
ЭОМ-5.51 | ША.6 | HL-5.1 | X83 | ВВГнг(А)-LS 3x1,5 | 1
ЭОМ-5.52 | ША.6 | ER-5.1 | X84 | ВВГнг(А)-LS 3x1,5 | 1
ЭОМ-5.57 | ША.6 | QS-5.1 | X65 | ВВГнг(А)-LS 2x1,5
ЭОМ-5.58 | ША.6 | QS-5.2 | X66 | ВВГнг(А)-LS 2x1,5
ЭОМ-6.54 | ША.6 | HL-6.3 | X86 | ВВГнг(А)-LS 3x1,5 | 1
ЭОМ-6.55 | ША.6 | QS-6.4 | X67 | ВВГнг(А)-LS 2x1,5
ЭОМ-6.61 | ША.6 | XD-6.4 | X68 | ВВГнг(А)-LS 2x1,5
ЭОМ-6.64 | ША.6 | QS-6.7 | X69 | ВВГнг(А)-LS 2x1,5
ЭОМ-6.67 | ША.6 | QS-6.9 | X70 | ВВГнг(А)-LS 2x1,5
--//-- | ША.6 | QS-6.9 | X71 | ВВГнг(А)-LS 2x1,5
ЭОМ-6.69 | ША.6 | BGRV-6.2 | X50 | ВВГнг(А)-LS 3x1,5 | 1
ЭОМ-6.9 | ША.6 | XS-6.11,XS-6.12 | X30 | ВВГнг(А)-LS 3x2,5 | 1
ЭОМ-7.1 | ША.6 | XS-7.1 | X34 | ВВГнг(А)-LS 3x2,5 | 1
ЭОМ-7.2 | ША.6 | XS-7.2 | X35 | ВВГнг(А)-LS 3x2,5 | 1
ЭОМ-7.3 | ША.6 | XS-7.3,XS-7.4 | X36 | ВВГнг(А)-LS 3x2,5 | 1
ЭОМ-7.51 | ША.6 | ER-7.1 | X88 | ВВГнг(А)-LS 3x1,5 | 1
ЭОМ-7.56 | ША.6 | HL-7.5 | X89 | ВВГнг(А)-LS 3x1,5 | 1
ЭОМ-8.1 | ША.6 | XS-8.1..XS-8.3 | X37 | ВВГнг(А)-LS 3x2,5 | 1
ЭОМ-8.31 | ША.6 | XF-8.1 | X41 | ВВГнг(А)-LS 3x1,5 | 1
ЭОМ-8.32 | ША.6 | XF-8.2 | X43 | ВВГнг(А)-LS 3x6 | 1
ЭОМ-8.33 | ША.6 | XF-8.1 | - | ВВГнг(А)-LS 2x1,5
ЭОМ-8.51 | ША.6 | ER-8.1 | X90 | ВВГнг(А)-LS 3x1,5 | 1
ЭОМ-8.54 | ША.6 | HL-8.3 | X91 | ВВГнг(А)-LS 3x1,5 | 1
ЭОМ-8.55 | ША.6 | QS-8.1 | X91 | ВВГнг(А)-LS 2x1,5
 |  |  |  |  | 24
ЭОМ-0.5 | ША.6 | HA-1 |  | ВВГнг(А)-LS 2x1,5

Sheet: питание
Наименование | Ток норма, А | Ток тревога, А | Кол-во | Общий норма, А | Общий тревога, А
Пожарная сигнализация
С2000М | 0.060 | 0.080 | 1 | 0.06 | 0.08
С2000-КДЛ | 0.1 | 0.4 | 1 | 0.10 | 0.4 | Резерв 24+3 часа
С2000-СП1 | 0.02 | 0.3 | 1 | 0.02 | 0.3
 |  |  |  | 0.18 | 0.78 | 6.66 | СКАТ-1200С
 |  |  |  |  |  |  | 7Ач
24В
QBM2030-1U | 0.02 |  | 7 | 0.15
часофикация | 2.00 |  | 1 | 2.00
DA04N24P | 0.10 |  | 2 | 0.20
 |  |  |  | 2.15 |  |  | MDR-60-24
12В
AF-KS | 0.15 |  | 1 | 0.15 |  |  | MDR-20-12
