antony-sm/Ovrajnaya_stadia_RD/04 ЭОМ СС/перечень элементов основной.xls

Sheet: розетки
Поз. | Наименование | Кол. | Примечание
XS-1.1, XS-1.2 | ДКС 76482B, модуль розеточный с заземлением и шторками, белый | 2
 | ДКС 75012W, рамка для монтажа ЭУИ "Brava" в стены и коробки PDD-N60, двухместная (4 модуля) | 1
 | ДКС 75023W, каркас для монтажа ЭУИ "Brava" в стены и коробки PDD-N60, белый, без лапок | 2
 | Коробка установочная 65-68 мм, глубина не менее 40 мм | 2
XS-1.3, XS-1.4 | ДКС 76482B, модуль розеточный с заземлением и шторками, белый | 2
 | ДКС 75014W, рамка для монтажа ЭУИ "Brava" в стены и коробки PDD-N60, четыреххместная (8 модулей) | 0.5
 | ДКС 75023W, каркас для монтажа ЭУИ "Brava" в стены и коробки PDD-N60, белый, без лапок | 2
 | Коробка установочная 65-68 мм, глубина не менее 40 мм | 2
XS-1.5… XS-1.8 | ДКС 76482B, модуль розеточный с заземлением и шторками, белый | 4
 | ДКС 75012W, рамка для монтажа ЭУИ "Brava" в стены и коробки PDD-N60, двухместная (4 модуля) | 2
 | ДКС 75023W, каркас для монтажа ЭУИ "Brava" в стены и коробки PDD-N60, белый, без лапок | 4
 | Коробка установочная 65-68 мм, глубина не менее 40 мм | 4
XS-1.9, XS-1.10 | ДКС 76482B, модуль розеточный с заземлением и шторками, белый | 2
 | ДКС 75012W, рамка для монтажа ЭУИ "Brava" в стены и коробки PDD-N60, двухместная (4 модуля) | 1
 | ДКС 75023W, каркас для монтажа ЭУИ "Brava" в стены и коробки PDD-N60, белый, без лапок | 2
 | Коробка установочная 65-68 мм, глубина не менее 40 мм | 2
XS-1.11, XS-1.12 | ДКС 76482B, модуль розеточный с заземлением и шторками, белый | 2
 | ДКС 75014W, рамка для монтажа ЭУИ "Brava" в стены и коробки PDD-N60, четыреххместная (8 модулей) | 0.5
 | ДКС 75023W, каркас для монтажа ЭУИ "Brava" в стены и коробки PDD-N60, белый, без лапок | 2
 | Коробка установочная 65-68 мм, глубина не менее 40 мм | 2
XS-1.13.. XS-1.18 | ДКС 76482B, модуль розеточный с заземлением и шторками, белый | 6
 | ДКС 75012W, рамка для монтажа ЭУИ "Brava" в стены и коробки PDD-N60, двухместная (4 модуля) | 3
 | ДКС 75023W, каркас для монтажа ЭУИ "Brava" в стены и коробки PDD-N60, белый, без лапок | 6
 | Коробка установочная 65-68 мм, глубина не менее 40 мм | 6
XS-2.1,XS-2.2 | ДКС 10482, коробка в сборе с силовой электрической розеткой, с заземлением, с защитными шторками | 2
XS-2.5...XS-2.8 | ДКС 76482B, модуль розеточный с заземлением и шторками, белый | 4
 | ДКС 75015W, рамка для монтажа ЭУИ "Brava" в стены и коробки PDD-N60, пятиместная (10 модулей) | 0.8
 | ДКС 75023W, каркас для монтажа ЭУИ "Brava" в стены и коробки PDD-N60, белый, без лапок | 4
 | Коробка установочная 65-68 мм, глубина не менее 40 мм | 4
XS-2.3,XS-2.4 | ДКС 76482B, модуль розеточный с заземлением и шторками, белый | 2
 | ДКС 75012W, рамка для монтажа ЭУИ "Brava" в стены и коробки PDD-N60, двухместная (4 модуля) | 1
 | ДКС 75023W, каркас для монтажа ЭУИ "Brava" в стены и коробки PDD-N60, белый, без лапок | 2
 | Коробка установочная 65-68 мм, глубина не менее 40 мм | 2
XS-3.1,XS-3.2 | ДКС 76482B, модуль розеточный с заземлением и шторками, белый | 2
 | ДКС 75012W, рамка для монтажа ЭУИ "Brava" в стены и коробки PDD-N60, двухместная (4 модуля) | 1
 | ДКС 75023W, каркас для монтажа ЭУИ "Brava" в стены и коробки PDD-N60, белый, без лапок | 2
 | Коробка установочная 65-68 мм, глубина не менее 40 мм | 2
XS-3.3..XS-3.5 | ДКС 76482B, модуль розеточный с заземлением и шторками, белый | 3
 | ДКС 75015W, рамка для монтажа ЭУИ "Brava" в стены и коробки PDD-N60, пятиместная (10 модулей) | 0.6
 | ДКС 75023W, каркас для монтажа ЭУИ "Brava" в стены и коробки PDD-N60, белый, без лапок | 3
 | Коробка установочная 65-68 мм, глубина не менее 40 мм | 3
XS-3.6..XS-3.9 | ДКС 76482B, модуль розеточный с заземлением и шторками, белый | 4
 | ДКС 75012W, рамка для монтажа ЭУИ "Brava" в стены и коробки PDD-N60, двухместная (4 модуля) | 2
 | ДКС 75023W, каркас для монтажа ЭУИ "Brava" в стены и коробки PDD-N60, белый, без лапок | 4
 | Коробка установочная 65-68 мм, глубина не менее 40 мм | 4
XS-3.10..XS-3.13 | ДКС 76482B, модуль розеточный с заземлением и шторками, белый | 4
 | ДКС 75015W, рамка для монтажа ЭУИ "Brava" в стены и коробки PDD-N60, пятиместная (10 модулей) | 0.8
 | ДКС 75023W, каркас для монтажа ЭУИ "Brava" в стены и коробки PDD-N60, белый, без лапок | 4
 | Коробка установочная 65-68 мм, глубина не менее 40 мм | 4
XS-3.14,XS-3.15 | ДКС 76482B, модуль розеточный с заземлением и шторками, белый | 2
 | ДКС 75012W, рамка для монтажа ЭУИ "Brava" в стены и коробки PDD-N60, двухместная (4 модуля) | 1
 | ДКС 75023W, каркас для монтажа ЭУИ "Brava" в стены и коробки PDD-N60, белый, без лапок | 2
 | Коробка установочная 65-68 мм, глубина не менее 40 мм | 2
XS-3.16..XS-3.19 | ДКС 76482B, модуль розеточный с заземлением и шторками, белый | 4
 | ДКС 75015W, рамка для монтажа ЭУИ "Brava" в стены и коробки PDD-N60, пятиместная (10 модулей) | 0.8
 | ДКС 75023W, каркас для монтажа ЭУИ "Brava" в стены и коробки PDD-N60, белый, без лапок | 4
 | Коробка установочная 65-68 мм, глубина не менее 40 мм | 4
XS-4.1..XS-4.3 | ДКС 76482B, модуль розеточный с заземлением и шторками, белый | 3
 | ДКС 75014W, рамка для монтажа ЭУИ "Brava" в стены и коробки PDD-N60, четыреххместная (8 модулей) | 0.75
 | ДКС 75023W, каркас для монтажа ЭУИ "Brava" в стены и коробки PDD-N60, белый, без лапок | 3
 | Коробка установочная 65-68 мм, глубина не менее 40 мм | 3
XS-4.4..XS-4.6 | ДКС 76482B, модуль розеточный с заземлением и шторками, белый | 3
 | ДКС 75014W, рамка для монтажа ЭУИ "Brava" в стены и коробки PDD-N60, четыреххместная (8 модулей) | 0.75
 | ДКС 75023W, каркас для монтажа ЭУИ "Brava" в стены и коробки PDD-N60, белый, без лапок | 3
 | Коробка установочная 65-68 мм, глубина не менее 40 мм | 3
XS-4.7,XS-4.8 | ДКС 76482B, модуль розеточный с заземлением и шторками, белый | 2
 | ДКС 75014W, рамка для монтажа ЭУИ "Brava" в стены и коробки PDD-N60, четыреххместная (8 модулей) | 0.5
 | ДКС 75023W, каркас для монтажа ЭУИ "Brava" в стены и коробки PDD-N60, белый, без лапок | 2
 | Коробка установочная 65-68 мм, глубина не менее 40 мм | 2
XS-4.9..XS-4.11 | ДКС 76482B, модуль розеточный с заземлением и шторками, белый | 3
 | ДКС 75014W, рамка для монтажа ЭУИ "Brava" в стены и коробки PDD-N60, четыреххместная (8 модулей) | 0.75
 | ДКС 75023W, каркас для монтажа ЭУИ "Brava" в стены и коробки PDD-N60, белый, без лапок | 3
 | Коробка установочная 65-68 мм, глубина не менее 40 мм | 3
XS-4.12,XS-4.13 | ДКС 76482B, модуль розеточный с заземлением и шторками, белый | 2
 | ДКС 75014W, рамка для монтажа ЭУИ "Brava" в стены и коробки PDD-N60, четыреххместная (8 модулей) | 0.5
 | ДКС 75023W, каркас для монтажа ЭУИ "Brava" в стены и коробки PDD-N60, белый, без лапок | 2
 | Коробка установочная 65-68 мм, глубина не менее 40 мм | 2
XS-4.14..XS-4.19 | ДКС 76482B, модуль розеточный с заземлением и шторками, белый | 6
 | ДКС 75012W, рамка для монтажа ЭУИ "Brava" в стены и коробки PDD-N60, двухместная (4 модуля) | 3
 | ДКС 75023W, каркас для монтажа ЭУИ "Brava" в стены и коробки PDD-N60, белый, без лапок | 6
 | Коробка установочная 65-68 мм, глубина не менее 40 мм | 6
XS-5.1,XS-5.2 | ДКС 10482, коробка в сборе с силовой электрической розеткой, с заземлением, с защитными шторками | 2
XS-5.3,XS-5.4 | ДКС 76482B, модуль розеточный с заземлением и шторками, белый | 2
 | ДКС 75014W, рамка для монтажа ЭУИ "Brava" в стены и коробки PDD-N60, четыреххместная (8 модулей) | 0.5
 | ДКС 75023W, каркас для монтажа ЭУИ "Brava" в стены и коробки PDD-N60, белый, без лапок | 2
 | Коробка установочная 65-68 мм, глубина не менее 40 мм | 2
XS-5.5..XS-5.8 | ДКС 76482B, модуль розеточный с заземлением и шторками, белый | 4
 | ДКС 75014W, рамка для монтажа ЭУИ "Brava" в стены и коробки PDD-N60, четыреххместная (8 модулей) | 1
 | ДКС 75023W, каркас для монтажа ЭУИ "Brava" в стены и коробки PDD-N60, белый, без лапок | 4
 | Коробка установочная 65-68 мм, глубина не менее 40 мм | 4
XS-5.9, XS-5.10 | ДКС 10482, коробка в сборе с силовой электрической розеткой, с заземлением, с защитными шторками | 2
XS-5.11..XS-5.16 | Розетка угловая | 6
XS-5.17..XS-5.19 | ДКС 10482, коробка в сборе с силовой электрической розеткой, с заземлением, с защитными шторками | 3
XS-5.20..XS-5.23 | ДКС 76482B, модуль розеточный с заземлением и шторками, белый | 4
 | ДКС 75012W, рамка для монтажа ЭУИ "Brava" в стены и коробки PDD-N60, двухместная (4 модуля) | 2
 | ДКС 75023W, каркас для монтажа ЭУИ "Brava" в стены и коробки PDD-N60, белый, без лапок | 4
 | Коробка установочная 65-68 мм, глубина не менее 40 мм | 4
XS-6.1..XS-6.8 | ДКС 76482B, модуль розеточный с заземлением и шторками, белый | 8
 | ДКС 75012W, рамка для монтажа ЭУИ "Brava" в стены и коробки PDD-N60, двухместная (4 модуля) | 4
 | ДКС 75023W, каркас для монтажа ЭУИ "Brava" в стены и коробки PDD-N60, белый, без лапок | 8
 | Коробка установочная 65-68 мм, глубина не менее 40 мм | 8
XS-6.9,XS-6.10 | ДКС 10482, коробка в сборе с силовой электрической розеткой, с заземлением, с защитными шторками | 2
XS-6.11,XS-6.12 | ДКС 76482B, модуль розеточный с заземлением и шторками, белый | 2
 | ДКС 75012W, рамка для монтажа ЭУИ "Brava" в стены и коробки PDD-N60, двухместная (4 модуля) | 1
 | ДКС 75023W, каркас для монтажа ЭУИ "Brava" в стены и коробки PDD-N60, белый, без лапок | 2
 | Коробка установочная 65-68 мм, глубина не менее 40 мм | 2
XS-7.1..XS-7.4 | ДКС 76482B, модуль розеточный с заземлением и шторками, белый | 4
 | ДКС 75012W, рамка для монтажа ЭУИ "Brava" в стены и коробки PDD-N60, двухместная (4 модуля) | 2
 | ДКС 75023W, каркас для монтажа ЭУИ "Brava" в стены и коробки PDD-N60, белый, без лапок | 4
 | Коробка установочная 65-68 мм, глубина не менее 40 мм | 4
XS-8.1..XS-8.3 | ДКС 10482, коробка в сборе с силовой электрической розеткой, с заземлением, с защитными шторками | 3
XS-9.1,XS-9.2 | ДКС 76482B, модуль розеточный с заземлением и шторками, белый | 2
 | ДКС 75012W, рамка для монтажа ЭУИ "Brava" в стены и коробки PDD-N60, двухместная (4 модуля) | 1
 | ДКС 75023W, каркас для монтажа ЭУИ "Brava" в стены и коробки PDD-N60, белый, без лапок | 2
 | Коробка установочная 65-68 мм, глубина не менее 40 мм | 2

Sheet: освещение
Обозначение | Наименование | Кол. | Примечание
 | Светильники
HL-1.1 | Светильник настенно-потолочный ARTE LAMP A6462PL-3CK ARCHIMEDE 3xE27 60W 220V IP | 1
HL-1.2 | Потолочный светильник Velante 592-727-01 | 1 | возможна замена на Люстра потолочная Svetresurs/Светресурс 513-727-01
HL-1.3 | Потолочный светильник Velante 592-727-01 | 1
HL-1.4 | Светильник настенно-потолочный Arte Lamp ARCHIMEDE A6462AP-1CK (1х40) | 1
HL-1.5 | Светильник настенно-потолочный Arte Lamp ARCHIMEDE A6462AP-1CK (1х40) | 1
HL-2.1 | Светильник настенно-потолочный Arte Lamp ARCHIMEDE A6462AP-1CK (1х40) | 1
HL-2.2 | Светильник настенно-потолочный Arte Lamp ARCHIMEDE A6462AP-1CK (1х40) | 1
HL-3.1 | Светильник настенно-потолочный ARTE LAMP A6462PL-3CK ARCHIMEDE 3xE27 60W 220V IP | 1
HL-3.2 | Светильник Citilux CL512523 Готика | 1
HL-3.3 | Светильник Citilux CL512523 Готика | 1
HL-3.4 | Светильник Citilux CL512523 Готика | 1
HL-4.1 | Светильник настенно-потолочный ARTE LAMP A6462PL-3CK ARCHIMEDE 3xE27 60W 220V IP | 1
HL-4.2 | Светильник настенно-потолочный Arte Lamp ARCHIMEDE A6462AP-1CK (1х40) | 1
HL-4.3 | Светильник настенно-потолочный Arte Lamp ARCHIMEDE A6462AP-1CK (1х40) | 1
HL-5.1 | Светильник настенно-потолочный ARTE LAMP A6462PL-3CK ARCHIMEDE 3xE27 60W 220V IP | 1
HL-5.2 | Встраиваемый светильник WOOD 369715, 50 Вт, GX5.3, Лампа светодиодная Philips LED MR16 5W (50W) 2700K 24° 12V 415lm GU5.3 теплый свет | 1 | устанавливают мебельщики
HL-5.3 | Встраиваемый светильник WOOD 369715, 50 Вт, GX5.3, Лампа светодиодная Philips LED MR16 5W (50W) 2700K 24° 12V 415lm GU5.3 теплый свет | 1 | устанавливают мебельщики
HL-5.4 | Встраиваемый светильник WOOD 369715, 50 Вт, GX5.3, Лампа светодиодная Philips LED MR16 5W (50W) 2700K 24° 12V 415lm GU5.3 теплый свет | 1 | устанавливают мебельщики
HL-5.5 | Встраиваемый светильник WOOD 369715, 50 Вт, GX5.3, Лампа светодиодная Philips LED MR16 5W (50W) 2700K 24° 12V 415lm GU5.3 теплый свет | 1 | устанавливают мебельщики
HL-6.1 | Светильник настенно-потолочный ARTE LAMP A6462PL-3CK ARCHIMEDE 3xE27 60W 220V IP | 1
HL-6.2 | Светильник настенно-потолочный ARTE LAMP A6462PL-3CK ARCHIMEDE 3xE27 60W 220V IP | 1
HL-6.3 | Светильник настенно-потолочный ARTE LAMP A6462PL-3CK ARCHIMEDE 3xE27 60W 220V IP | 1
HL-6.4 | Светильник 94822 NBL-PO1-7-4K-WH-IP65-LED светодиод. настенно-потолочный 7Вт бел.IP65 (Navigator) | 1 | или любой другой овальный настенно-потолочный
HL-7.1 | Светодиодная лента | 1
HL-7.2 | Светодиодная лента | 1
HL-7.3 | Светодиодная лента | 1
HL-7.4 | Светодиодная лента | 1
HL-7.5 | Светильник для ванных комнат Svetresurs IP44 254-101-02 | 1
HL-8.1 | Светодиодная лента | 1
HL-8.2 | Светодиодная лента | 1
HL-8.3 | Светильник 94822 NBL-PO1-7-4K-WH-IP65-LED светодиод. настенно-потолочный 7Вт бел.IP65 (Navigator) | 1 | или любой другой овальный настенно-потолочный
HL-9.1 | Светильник настенно-потолочный Arte Lamp ARCHIMEDE A6462AP-1CK (1х40) | 1
HL-9.2 | Светильник настенно-потолочный Arte Lamp ARCHIMEDE A6462AP-1CK (1х40) | 1
 | Источники питания
ER-5.1 | Блок питания ARPV-12045B (12V, 3.75A, 45W) | 1
ER-7.1 | Блок питания ARPV-12045B (12V, 3.75A, 45W) | 1
ER-8.1 | Блок питания ARPV-12045B (12V, 3.75A, 45W) | 1
 | Кнопки
QS-1.1 | ДКС 76022B, кнопка белая, 2 модуля | 1
 | ДКС 75010W, рамка для монтажа ЭУИ "Brava" в стены и коробки PDD-N60, одноместная (2 модуля) | 1
 | ДКС 75023W, каркас для монтажа ЭУИ "Brava" в стены и коробки PDD-N60, белый, без лапок | 1
 | Коробка установочная 65-68 мм, глубина не менее 40 мм | 1
QS-1.2 | ДКС 76021B, кнопка белая, 1 модуль | 2
 | ДКС 75014W, рамка для монтажа ЭУИ "Brava" в стены и коробки PDD-N60, четыреххместная (8 модулей) | 0.25
 | ДКС 75023W, каркас для монтажа ЭУИ "Brava" в стены и коробки PDD-N60, белый, без лапок | 1
 | Коробка установочная 65-68 мм, глубина не менее 40 мм | 1
QS-1.3 | ДКС 76021B, кнопка белая, 1 модуль | 2
 | ДКС 75014W, рамка для монтажа ЭУИ "Brava" в стены и коробки PDD-N60, четыреххместная (8 модулей) | 0.25
 | ДКС 75023W, каркас для монтажа ЭУИ "Brava" в стены и коробки PDD-N60, белый, без лапок | 1
 | Коробка установочная 65-68 мм, глубина не менее 40 мм | 1
QS-2.1 | ДКС 76022B, кнопка белая, 2 модуля | 1
 | ДКС 75010W, рамка для монтажа ЭУИ "Brava" в стены и коробки PDD-N60, одноместная (2 модуля) | 1
 | ДКС 75023W, каркас для монтажа ЭУИ "Brava" в стены и коробки PDD-N60, белый, без лапок | 1
 | Коробка установочная 65-68 мм, глубина не менее 40 мм | 1
QS-3.1 | ДКС 76022B, кнопка белая, 2 модуля | 1
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
 | ДКС 75010W, рамка для монтажа ЭУИ "Brava" в стены и коробки PDD-N60, одноместная (2 модуля) | 1
 | ДКС 75023W, каркас для монтажа ЭУИ "Brava" в стены и коробки PDD-N60, белый, без лапок | 1
 | Коробка установочная 65-68 мм, глубина не менее 40 мм | 1

Sheet: электрика прочее
Обозначение | Наименование | Кол. | Примечание
 | Извещатели
BGRV-6.1, BGRV-6.2 | Датчик движения ЭРА MD10 | 2
 | Коробка установочная 65-68 мм, глубина не менее 40 мм | 2
 | Коробки
XD-1.1..XD-1.8 | Коробка 84х84х45 мм ДКС 53700 | 8
XD-2.1, XD-2.2 | Коробка 84х84х45 мм ДКС 53700 | 2
XD-3.1..XD-3.4 | Коробка 84х84х45 мм ДКС 53700 | 4
XD-4.1..XD-4.7 | Коробка 84х84х45 мм ДКС 53700 | 7
XD-5.1..XD-5.6 | Коробка 84х84х45 мм ДКС 53700 | 6
XD-6.1..XD-6.4 | Коробка 84х84х45 мм ДКС 53700 | 4
 | Звонок
KB-1 | Кнопка звонка | 1
HA-1 | Звонок дверной | 1

Sheet: слаботочка
Обозначение | Наименование | Кол. | Примечание
 | СКС
XL-1.1 | ДКС 76655B, компьютерная розетка RJ-45 с 1 разъемом, 2 модуля, белая | 1
 | ДКС 75014W, рамка для монтажа ЭУИ "Brava" в стены и коробки PDD-N60, четыреххместная (8 модулей) | 0.25
 | ДКС 75023W, каркас для монтажа ЭУИ "Brava" в стены и коробки PDD-N60, белый, без лапок | 1
 | Коробка установочная 65-68 мм, глубина не менее 40 мм | 1
XL-1.2 | ДКС 76655B, компьютерная розетка RJ-45 с 1 разъемом, 2 модуля, белая | 1
 | ДКС 75014W, рамка для монтажа ЭУИ "Brava" в стены и коробки PDD-N60, четыреххместная (8 модулей) | 0.25
 | ДКС 75023W, каркас для монтажа ЭУИ "Brava" в стены и коробки PDD-N60, белый, без лапок | 1
 | Коробка установочная 65-68 мм, глубина не менее 40 мм | 1
XL-1.3 | ДКС 76655B, компьютерная розетка RJ-45 с 1 разъемом, 2 модуля, белая | 1
 | ДКС 75012W, рамка для монтажа ЭУИ "Brava" в стены и коробки PDD-N60, двухместная (4 модуля) | 0.5
 | ДКС 75023W, каркас для монтажа ЭУИ "Brava" в стены и коробки PDD-N60, белый, без лапок | 1
 | Коробка установочная 65-68 мм, глубина не менее 40 мм | 1
XL-2.1 | ДКС 76655B, компьютерная розетка RJ-45 с 1 разъемом, 2 модуля, белая | 1
 | ДКС 10034, PDB коробка монтажная под 2 модуля "Brava" | 1
XL-2.2 | ДКС 76655B, компьютерная розетка RJ-45 с 1 разъемом, 2 модуля, белая | 1
 | ДКС 75015W, рамка для монтажа ЭУИ "Brava" в стены и коробки PDD-N60, пятиместная (10 модулей) | 0.2
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
 | Коробка установочная 65-68 мм, глубина не менее 40 мм | 1
XT-5.1 | ДКС 76721B, розетка ТВ, 1 модуль, белая | 1
 | ДКС 76616B, заглушка 1 модуль, белая | 1
 | ДКС 75014W, рамка для монтажа ЭУИ "Brava" в стены и коробки PDD-N60, четыреххместная (8 модулей) | 0.25
 | ДКС 75023W, каркас для монтажа ЭУИ "Brava" в стены и коробки PDD-N60, белый, без лапок | 1
 | Коробка установочная 65-68 мм, глубина не менее 40 мм | 1
 | Аудио
BA-1.1, BA-1.2 | Колонка настенная SHOW CSB150/CV BK | 2
BA-3.1, BA-3.2 | Колонка настенная SHOW CSB150/CV BK | 2
BA-4.1, BA-4.2 | Колонка настенная SHOW CSB150/CV BK | 2
BA-5.1, BA-5.2 | Колонка настенная SHOW CSB150/CV BK | 2
BA-7.1 | Колонка потолочная встраиваемая Apart CM5EH White | 1
BA-8.1 | Колонка потолочная встраиваемая Apart CM5EH White | 1
 | Коробка установочная 65-68 мм, глубина не менее 40 мм | 10
 | Шкафы, коробки
ША.2 | Шкаф автоматики | 1
ША.4 | Шкаф автоматики | 1
ША.5 | Шкаф автоматики | 1
 | Часы вторичные
AT-1 | Часы вторичные | 1
AT-2 | Часы вторичные | 1
AT-3 | Часы вторичные | 1
AT-4 | Часы вторичные | 1
AT-5 | Часы вторичные | 1
AT-6 | Часы вторичные | 1
AT-9 | Часы вторичные | 1
 | Коробка установочная 65-68 мм, глубина не менее 40 мм | 7
 | Автоматика климата
MW-1 | Головка электротермическая нормально открытая двухпроводная 24В FAR 1929 | 1
MW-3 | Головка электротермическая нормально открытая двухпроводная 24В FAR 1929 | 1
MW-4 | Головка электротермическая нормально открытая двухпроводная 24В FAR 1929 | 1
MW-5 | Головка электротермическая нормально открытая двухпроводная 24В FAR 1929 | 1
 | Коробка установочная 65-68 мм, глубина не менее 40 мм | 4
BG-1 | Детектор углекислого газа SNS-MQ135 | 1
BHT-1 | Датчик температуры и влажности SHT1x | 1
 | Коробка установочная 65-68 мм, глубина не менее 40 мм | 1
BG-3 | Детектор углекислого газа SNS-MQ135 | 1
BHT-3 | Датчик температуры и влажности SHT1x | 1
 | Коробка установочная 65-68 мм, глубина не менее 40 мм | 1
BG-4 | Детектор углекислого газа SNS-MQ135 | 1
BHT-4 | Датчик температуры и влажности SHT1x | 1
 | Коробка установочная 65-68 мм, глубина не менее 40 мм | 1
BG-5 | Детектор углекислого газа SNS-MQ135 | 1
BHT-5 | Датчик температуры и влажности SHT1x | 1
 | Коробка установочная 65-68 мм, глубина не менее 40 мм | 1
BHT-6 | Датчик температуры и влажности SHT1x | 1
BHT-7 | Датчик температуры и влажности SHT1x | 1
BHT-8 | Датчик температуры и влажности SHT1x | 1
BHT-9 | Датчик температуры и влажности SHT1x | 1
 | Коробка установочная 65-68 мм, глубина не менее 40 мм | 4
BT-1.1, BT-1.2 | Датчик температуры DS18B20 | 2
BT-2.1 | Датчик температуры DS18B20 | 1
BT-9 | Датчик температуры VALTEC VT.AC501.0.0 | 1
 | Коробка установочная 65-68 мм, глубина не менее 40 мм | 1
BT-6.1 | Датчик температуры VALTEC VT.AC501.0.0 | 1
M-2.1..M-2.3 | Электропривод воздушных клапанов Luftberg DA04N24P | 3
M-3.1 | Электропривод воздушных клапанов Luftberg DA04N24P | 1
M-4.1 | Электропривод воздушных клапанов Luftberg DA04N24P | 1
M-5.1 | Электропривод воздушных клапанов Luftberg DA04N24P | 1
M-6.1 | Электропривод воздушных клапанов Luftberg DA04N24P | 1
M-7.1 | Электропривод воздушных клапанов Luftberg DA04N24P | 1
M-8.1 | Электропривод воздушных клапанов Luftberg DA04N24P | 1
RP-1.1 | Регулятор 0/1-10В Arlight Rotary SR-2202-IN | 1
 | Коробка установочная 65-68 мм, глубина не менее 40 мм | 1
RP-2.1 | Резистор переменный 10 кОм* | 1
 | ДКС 75012W, рамка для монтажа ЭУИ "Brava" в стены и коробки PDD-N60, двухместная (4 модуля) | 0.5
 | ДКС 75023W, каркас для монтажа ЭУИ "Brava" в стены и коробки PDD-N60, белый, без лапок | 1
 | Коробка установочная 65-68 мм, глубина не менее 40 мм | 1
RP-2.2 | Резистор переменный 10 кОм* | 1
 | ДКС 75012W, рамка для монтажа ЭУИ "Brava" в стены и коробки PDD-N60, двухместная (4 модуля) | 0.5
 | ДКС 75023W, каркас для монтажа ЭУИ "Brava" в стены и коробки PDD-N60, белый, без лапок | 1
 | Коробка установочная 65-68 мм, глубина не менее 40 мм | 1
RP-3.1 | Регулятор 0/1-10В Arlight Rotary SR-2202-IN | 1
 | Коробка установочная 65-68 мм, глубина не менее 40 мм | 1
RP-4.1 | Регулятор 0/1-10В Arlight Rotary SR-2202-IN | 1
 | Коробка установочная 65-68 мм, глубина не менее 40 мм | 1
RP-5.1 | Регулятор 0/1-10В Arlight Rotary SR-2202-IN | 1
 | Коробка установочная 65-68 мм, глубина не менее 40 мм | 1
YK-2 | Пульт управления кондиционером Kentatsu KWC | 1
 | Коробка установочная 65-68 мм, глубина не менее 40 мм | 1
BP-1..BP-7 | Дифференциальный датчик давления Siemens QBM2030-1U | 7
 | Общая автоматика
M-1.1 | Сервопривод FS5103R | 1
M-3.2..M-3.4 | Сервопривод FS5103R | 3
M-4.2 | Сервопривод FS5103R | 1
M-5.2 | Сервопривод FS5103R | 1
BR-1.1 | Энкодер miniQ | 1
BR-3.1..BR-3.3 | Энкодер miniQ | 3
BR-4.1 | Энкодер miniQ | 1
BR-5.1 | Энкодер miniQ | 1
 | Коробка установочная в гипсокартон неглубокая | 12
QS-1.1 | ДКС 76021B, кнопка белая, 1 модуль | 2
 | ДКС 75010W, рамка для монтажа ЭУИ "Brava" в стены и коробки PDD-N60, одноместная (2 модуля) | 1
 | ДКС 75023W, каркас для монтажа ЭУИ "Brava" в стены и коробки PDD-N60, белый, без лапок | 1
 | Коробка установочная 65-68 мм, глубина не менее 40 мм | 1
QS-3.1..QS-3.3 | ДКС 76021B, кнопка белая, 1 модуль | 6
 | ДКС 75014W, рамка для монтажа ЭУИ "Brava" в стены и коробки PDD-N60, четыреххместная (8 модулей) | 0.75
 | ДКС 75023W, каркас для монтажа ЭУИ "Brava" в стены и коробки PDD-N60, белый, без лапок | 3
 | Коробка установочная 65-68 мм, глубина не менее 40 мм | 3
QS-4.1 | ДКС 76021B, кнопка белая, 1 модуль | 2
 | ДКС 75010W, рамка для монтажа ЭУИ "Brava" в стены и коробки PDD-N60, одноместная (2 модуля) | 1
 | ДКС 75023W, каркас для монтажа ЭУИ "Brava" в стены и коробки PDD-N60, белый, без лапок | 1
 | Коробка установочная 65-68 мм, глубина не менее 40 мм | 1
QS-5.1 | ДКС 76021B, кнопка белая, 1 модуль | 2
 | ДКС 75010W, рамка для монтажа ЭУИ "Brava" в стены и коробки PDD-N60, одноместная (2 модуля) | 1
 | ДКС 75023W, каркас для монтажа ЭУИ "Brava" в стены и коробки PDD-N60, белый, без лапок | 1
 | Коробка установочная 65-68 мм, глубина не менее 40 мм | 1
BR-5.2 | Счетчик воды с импульсным выходом ½ Valtec | 1
 | Коробка установочная в гипсокартон неглубокая | 1
BR-8.1 | Счетчик воды с импульсным выходом ½ Valtec | 1
BR-8.2 | Счетчик воды с импульсным выходом ¾ ВСКМ 90-20 | 1
BR-8.3 | Счетчик воды с импульсным выходом ¾ ВСКМ 90-20 | 1
 | ДКС 53500R, коробка круглая ответвительная | 3
BW-5 | Датчик протечки (из комплекта «Аквасторож») | 1
 | Коробка установочная в гипсокартон неглубокая | 1
BW-7 | Датчик протечки (из комплекта «Аквасторож») | 1
BW-8 | Датчик протечки (из комплекта «Аквасторож») | 1
 | ДКС 53500R, коробка круглая ответвительная | 2
ARKW-1 | Контроллер «Аквасторож-Эксперт» | 1
 | Пожарная сигнализация
BTH-1..BTH-9 | Извещатель пожарный дымовой адресный ДИП-34А-03 | 9
 | Технологическая сигнализация
BGB-1.1 | Извещатель магнитоконтактный врезной ИО 102-5 | 1
BGB-1.2..BGB-1.5 | Извещатель магнитоконтактный накладной ИО 102-14, белый | 4
BL-1 | Фотодиод SFH 203 P | 1
 | Коробка установочная в монолит | 3
BGB-2.1 | Извещатель магнитоконтактный врезной ИО 102-5 | 1
 | Коробка установочная в монолит | 1
BGB-3.1, BGB-3.2 | Извещатель магнитоконтактный накладной ИО 102-14, белый | 2
BL-3 | Фотодиод SFH 203 P | 1
 | Коробка установочная в гипсокартон неглубокая | 1
BGB-3.3 | Извещатель магнитоконтактный врезной ИО 102-5 | 1
 | Коробка установочная в монолит | 1
BGB-4.1..BGB-4.4 | Извещатель магнитоконтактный накладной ИО 102-14, белый | 4
BL-4 | Фотодиод SFH 203 P | 1
 | Коробка установочная в монолит | 1
BGB-4.5 | Извещатель магнитоконтактный врезной ИО 102-5 | 1
 | Коробка установочная в монолит | 1
BGB-5.1..BGB-5.4 | Извещатель магнитоконтактный накладной ИО 102-14, белый | 4
BL-5 | Фотодиод SFH 203 P | 1
 | Коробка установочная в монолит | 1
BGB-5.5 | Извещатель магнитоконтактный врезной ИО 102-5 | 1
 | Коробка установочная в монолит | 1
BGB-6.1 | Извещатель магнитоконтактный врезной ИО 102-5 | 1
BGB-6.2 | Извещатель магнитоконтактный накладной для металлических конструкций ИО 102-29 "Эстет-сейф" | 1
 | Коробка установочная в монолит | 2
BGB-7.1 | Извещатель магнитоконтактный врезной ИО 102-5 | 1
BGB-8.1 | Извещатель магнитоконтактный врезной ИО 102-5 | 1
 | Коробка установочная в монолит | 2
BGB-9.1..BGB-9.3 | Извещатель магнитоконтактный накладной ИО 102-14, белый | 3
 | Коробка установочная в гипсокартон неглубокая | 3
BIGL-7 | L-814Y, Светодиод с держателем желтый 12V | 1
BIGL-8 | L-814Y, Светодиод с держателем желтый 12V | 1
 | Коробка установочная в монолит | 2
 | Коробки
XD-1.1 | Коробка 84х84х45 мм ДКС 53700 | 1
XD-2.1 | Коробка 84х84х45 мм ДКС 53700 | 1
XD-3.1 | Коробка 84х84х45 мм ДКС 53700 | 1
XD-5.1 | Коробка 84х84х45 мм ДКС 53700 | 1
XD-6.1 | Коробка 84х84х45 мм ДКС 53700 | 1
XD-6.2 | Коробка 84х84х45 мм ДКС 53700 | 1
XD-6.3 | Коробка 84х84х45 мм ДКС 53700 | 1
XD-6.4 | Коробка 84х84х45 мм ДКС 53700 | 1
XD-7.1 | Коробка 84х84х45 мм ДКС 53700 | 1
XD-8.1 | Коробка 84х84х45 мм ДКС 53700 | 1
XD-8.2 | Коробка большая (для плинтов) | 1
 | Система безопасности
BA-0 | Аудиодомофон | 1
V-0 | Камера-видеоглазок цветная | 1
MON-0 | Монитор TFT миниатюрный цветной | 1
 | Коробка установочная в монолит | 3

Sheet: ЭУИ ABB Cosmo
Поз. | Наименование | Кол. | Примечание
Спальня
XS-1.1, XS-1.2 | ABB 619-010200-243, модуль розеточный с заземлением и шторками, белый | 2
 | ABB 612-010200-226, рамка 2 поста белая | 1
XS-1.3, XS-1.4 | ABB 619-010200-243, модуль розеточный с заземлением и шторками, белый | 2
XL-1.1 | ABB 619-010200-247, розетка RJ-45, белая | 1
QS-1.2 | ABB 619-010200-257, выключатель кнопочный двуклавишный | 1
 | ABB 612-010200-228, рамка 4 поста белая | 1
XS-1.5… XS-1.8 | ABB 619-010200-243, модуль розеточный с заземлением и шторками, белый | 4
XL-1.3 | ABB 619-010200-247, розетка RJ-45, белая | 1
XT-1.1 | ABB 619-010200-273, розетка ТВ оконечная с экранированием, белая | 1
 | ABB 612-010200-226, рамка 2 поста белая | 3
XS-1.9, XS-1.10 | ABB 619-010200-243, модуль розеточный с заземлением и шторками, белый | 2
 | ABB 612-010200-226, рамка 2 поста белая | 1
XS-1.11, XS-1.12 | ABB 619-010200-243, модуль розеточный с заземлением и шторками, белый | 2
XL-1.2 | ABB 619-010200-247, розетка RJ-45, белая | 1
QS-1.3 | ABB 619-010200-257, выключатель кнопочный двуклавишный | 1
 | ABB 612-010200-228, рамка 4 поста белая | 1
XS-1.13.. XS-1.18 | ABB 619-010200-243, модуль розеточный с заземлением и шторками, белый | 6
 | ABB 612-010200-226, рамка 2 поста белая | 3
QS-1.1 (свет) | ABB 619-010200-205, выключатель кнопочный одноклавишный | 1
 | ABB 612-010200-271, рамка 1 пост белая | 1
RP-1.1 | Регулятор 0/1-10В Arlight Rotary SR-2202-IN | 1
BA-1.1, BA-1.2 | ABB 619-010200-241, аудиорозетка двойная, белая | 2
 | ABB 612-010200-271, рамка 1 пост белая | 2
QS-1.1 (жалюзи) | ABB 619-010200-216, выключатель кнопочный 2-клавишный для управления жалюзи | 1
 | ABB 612-010200-271, рамка 1 пост белая | 1
Кладовая
XS-2.1,XS-2.2 | ABB 619-010200-243, модуль розеточный с заземлением и шторками, белый | 2
XL-2.1 | ABB 619-010200-247, розетка RJ-45, белая | 1
 | ABB 612-010200-227, рамка 3 поста белая | 1
XS-2.3,XS-2.4 | ABB 619-010200-243, модуль розеточный с заземлением и шторками, белый | 2
 | ABB 612-010200-226, рамка 2 поста белая | 1
XS-2.5...XS-2.8 | ABB 619-010200-243, модуль розеточный с заземлением и шторками, белый | 4
 | ABB 612-010200-228, рамка 4 поста белая | 1
XL-2.2 | ABB 619-010200-247, розетка RJ-45, белая | 1
 | ABB 612-010200-271, рамка 1 пост белая | 1
QS-2.1 | ABB 619-010200-205, выключатель кнопочный одноклавишный | 1
RP-2.1 | Резистор переменный 10 кОм* | 1
RP-2.2 | Резистор переменный 10 кОм* | 1
 | ABB 619-010200-299, заглушка белая | 2
 | ABB 612-010200-227, рамка 3 поста белая | 1
YK-2
Кабинет
XS-3.1,XS-3.2 | ABB 619-010200-243, модуль розеточный с заземлением и шторками, белый | 2
 | ABB 612-010200-226, рамка 2 поста белая | 1
XS-3.3..XS-3.5 | ABB 619-010200-243, модуль розеточный с заземлением и шторками, белый | 3
QS-3.2 (свет) | ABB 619-010200-257, выключатель кнопочный двуклавишный | 1
 | ABB 612-010200-228, рамка 4 поста белая | 1
XL-3.1 | ABB 619-010200-247, розетка RJ-45, белая | 1
 | ABB 612-010200-271, рамка 1 пост белая | 1
XS-3.6..XS-3.9 | ABB 619-010200-243, модуль розеточный с заземлением и шторками, белый | 4
XL-3.4 | ABB 619-010200-247, розетка RJ-45, белая | 1
XT-3.1 | ABB 619-010200-273, розетка ТВ оконечная с экранированием, белая | 1
 | ABB 612-010200-226, рамка 2 поста белая | 3
XS-3.10..XS-3.13 | ABB 619-010200-243, модуль розеточный с заземлением и шторками, белый | 4
 | ABB 612-010200-228, рамка 4 поста белая | 1
XL-3.3 | ABB 619-010200-247, розетка RJ-45, белая | 1
 | ABB 612-010200-271, рамка 1 пост белая | 1
XS-3.14,XS-3.15 | ABB 619-010200-243, модуль розеточный с заземлением и шторками, белый | 2
 | ABB 612-010200-226, рамка 2 поста белая | 1
XS-3.16..XS-3.19 | ABB 619-010200-243, модуль розеточный с заземлением и шторками, белый | 4
 | ABB 612-010200-228, рамка 4 поста белая | 1
XL-3.2 | ABB 619-010200-247, розетка RJ-45, белая | 1
 | ABB 612-010200-271, рамка 1 пост белая | 1
QS-3.1 (свет) | ABB 619-010200-205, выключатель кнопочный одноклавишный | 1
 | ABB 612-010200-271, рамка 1 пост белая | 1
RP-3.1 | Регулятор 0/1-10В Arlight Rotary SR-2202-IN | 1
QS-3.3 (свет) | ABB 619-010200-257, выключатель кнопочный двуклавишный | 1
QS-3.1..QS-3.3 (жалюзи) | ABB 619-010200-216, выключатель кнопочный 2-клавишный для управления жалюзи | 3
 | ABB 612-010200-228, рамка 4 поста белая | 1
BA-3.1, BA-3.2 | ABB 619-010200-241, аудиорозетка двойная, белая | 2
 | ABB 612-010200-271, рамка 1 пост белая | 2
Детская
XS-4.1..XS-4.3 | ABB 619-010200-243, модуль розеточный с заземлением и шторками, белый | 3
XL-4.3 | ABB 619-010200-247, розетка RJ-45, белая | 1
 | ABB 612-010200-228, рамка 4 поста белая | 1
XS-4.4..XS-4.6 | ABB 619-010200-243, модуль розеточный с заземлением и шторками, белый | 3
XL-4.2 | ABB 619-010200-247, розетка RJ-45, белая | 1
 | ABB 612-010200-228, рамка 4 поста белая | 1
XS-4.7,XS-4.8 | ABB 619-010200-243, модуль розеточный с заземлением и шторками, белый | 2
XL-4.1 | ABB 619-010200-247, розетка RJ-45, белая | 1
QS-4.2 | ABB 619-010200-257, выключатель кнопочный двуклавишный | 1
 | ABB 612-010200-228, рамка 4 поста белая | 1
XS-4.9..XS-4.11 | ABB 619-010200-243, модуль розеточный с заземлением и шторками, белый | 3
XL-4.5 | ABB 619-010200-247, розетка RJ-45, белая | 1
 | ABB 612-010200-228, рамка 4 поста белая | 1
XS-4.12,XS-4.13 | ABB 619-010200-243, модуль розеточный с заземлением и шторками, белый | 2
XL-4.4 | ABB 619-010200-247, розетка RJ-45, белая | 1
QS-4.3 | ABB 619-010200-257, выключатель кнопочный двуклавишный | 1
 | ABB 612-010200-228, рамка 4 поста белая | 1
XS-4.14..XS-4.19 | ABB 619-010200-243, модуль розеточный с заземлением и шторками, белый | 6
 | ABB 612-010200-226, рамка 2 поста белая | 3
QS-4.1 (свет) | ABB 619-010200-205, выключатель кнопочный одноклавишный | 1
 | ABB 612-010200-271, рамка 1 пост белая | 1
RP-4.1 | Регулятор 0/1-10В Arlight Rotary SR-2202-IN | 1
QS-4.1 (жалюзи) | ABB 619-010200-216, выключатель кнопочный 2-клавишный для управления жалюзи | 1
 | ABB 612-010200-271, рамка 1 пост белая | 1
BA-4.1, BA-4.2 | ABB 619-010200-241, аудиорозетка двойная, белая | 2
 | ABB 612-010200-271, рамка 1 пост белая | 2
Кухня
XS-5.1,XS-5.2 | - |  |  | коробка
XS-5.3,XS-5.4 | ABB 619-010200-243, модуль розеточный с заземлением и шторками, белый | 2
XL-5.1 | ABB 619-010200-247, розетка RJ-45, белая | 1
XT-5.1 | ABB 619-010200-273, розетка ТВ оконечная с экранированием, белая | 1
 | ABB 612-010200-228, рамка 4 поста белая | 1
XS-5.5..XS-5.8 | ABB 619-010200-243, модуль розеточный с заземлением и шторками, белый | 4
 | ABB 612-010200-228, рамка 4 поста белая | 1
XS-5.9, XS-5.10 | - |  |  | накладные
XS-5.11..XS-5.16 | - |  |  | угловые
XS-5.17..XS-5.19 | - |  |  | накладные
XS-5.20..XS-5.23 | ABB 619-010200-243, модуль розеточный с заземлением и шторками, белый | 4
 | ABB 612-010200-226, рамка 2 поста белая | 2
QS-5.1 (свет) | ABB 619-010200-205, выключатель кнопочный одноклавишный | 1
 | ABB 612-010200-271, рамка 1 пост белая | 1
RP-5.1 | Регулятор 0/1-10В Arlight Rotary SR-2202-IN | 1
QS-5.2 | ABB 619-010200-205, выключатель кнопочный одноклавишный | 1
 | ABB 612-010200-271, рамка 1 пост белая | 1
QS-5.1 (жалюзи) | ABB 619-010200-216, выключатель кнопочный 2-клавишный для управления жалюзи | 1
 | ABB 612-010200-271, рамка 1 пост белая | 1
BA-5.1, BA-5.2 | ABB 619-010200-241, аудиорозетка двойная, белая | 2
 | ABB 612-010200-271, рамка 1 пост белая | 2
Коридор
XS-6.1..XS-6.8 | ABB 619-010200-243, модуль розеточный с заземлением и шторками, белый | 8
 | ABB 612-010200-226, рамка 2 поста белая | 4
XS-6.9,XS-6.10 | - |  |  | накладные
XS-6.11,XS-6.12 | ABB 619-010200-243, модуль розеточный с заземлением и шторками, белый | 2
 | ABB 612-010200-226, рамка 2 поста белая | 1
QS-6.1..QS-6.3 | ABB 619-010200-205, выключатель кнопочный одноклавишный | 3
 | ABB 612-010200-271, рамка 1 пост белая | 3
QS-6.4 | ABB 619-010200-205, выключатель кнопочный одноклавишный | 1
QS-6.7 | ABB 619-010200-205, выключатель кнопочный одноклавишный | 1
 | ABB 612-010200-226, рамка 2 поста белая | 1
QS-6.5, QS-6.6 | ABB 619-010200-205, выключатель кнопочный одноклавишный | 2
 | ABB 612-010200-271, рамка 1 пост белая | 2
QS-6.8 | - |  |  | накладные
QS-6.9 | ABB 619-010200-257, выключатель кнопочный двуклавишный | 1
BGRV-6.2 | ABB 619-010200-262, датчик движения релейный | 1
 | ABB 612-010200-226, рамка 2 поста белая | 1
BGRV-6.1 | ABB 619-010200-262, датчик движения релейный | 1
 | ABB 612-010200-271, рамка 1 пост белая | 1
Ванная
XS-7.1..XS-7.4 | ABB 619-010200-218, модуль розеточный с заземлением и крышкой, белый | 4
 | ABB 612-010200-226, рамка 2 поста белая | 2
Туалет
XS-8.1..XS-8.3 | - |  |  | накладные
QS-8.1 | - |  |  | накладные
Лоджия
QS-9.1 | ABB 619-010200-205, выключатель кнопочный одноклавишный | 1
 | ABB 612-010200-271, рамка 1 пост белая | 1
XS-9.1,XS-9.2 | ABB 619-010200-218, модуль розеточный с заземлением и крышкой, белый | 2
 | ABB 612-010200-226, рамка 2 поста белая | 1

Sheet: ЭУИ ABB Cosmo для спеки
 | ABB 612-010200-226, рамка 2 поста белая | 29
 | ABB 612-010200-227, рамка 3 поста белая | 2
 | ABB 612-010200-228, рамка 4 поста белая | 14
 | ABB 612-010200-271, рамка 1 пост белая | 27
 | ABB 619-010200-205, выключатель кнопочный одноклавишный | 14
 | ABB 619-010200-216, выключатель кнопочный 2-клавишный для управления жалюзи | 6
 | ABB 619-010200-218, модуль розеточный с заземлением и крышкой, белый | 6
 | ABB 619-010200-241, аудиорозетка двойная, белая | 8
 | ABB 619-010200-243, модуль розеточный с заземлением и шторками, белый | 84
 | ABB 619-010200-247, розетка RJ-45, белая | 15
 | ABB 619-010200-257, выключатель кнопочный двуклавишный | 7
 | ABB 619-010200-262, датчик движения релейный | 2
 | ABB 619-010200-273, розетка ТВ оконечная с экранированием, белая | 3
 | ABB 619-010200-299, заглушка белая | 2
RP-1.1 | Регулятор 0/1-10В Arlight Rotary SR-2202-IN | 1
RP-3.1 | Регулятор 0/1-10В Arlight Rotary SR-2202-IN | 1
RP-4.1 | Регулятор 0/1-10В Arlight Rotary SR-2202-IN | 1
RP-5.1 | Регулятор 0/1-10В Arlight Rotary SR-2202-IN | 1
RP-2.1 | Резистор переменный 10 кОм* | 1
RP-2.2 | Резистор переменный 10 кОм* | 1
 | ABB 612-010200-226, рамка 2 поста белая | 1
 | ABB 612-010200-226, рамка 2 поста белая | 3
 | ABB 612-010200-226, рамка 2 поста белая | 1
 | ABB 612-010200-226, рамка 2 поста белая | 3
 | ABB 612-010200-226, рамка 2 поста белая | 1
 | ABB 612-010200-226, рамка 2 поста белая | 1
 | ABB 612-010200-226, рамка 2 поста белая | 3
 | ABB 612-010200-226, рамка 2 поста белая | 1
 | ABB 612-010200-226, рамка 2 поста белая | 3
 | ABB 612-010200-226, рамка 2 поста белая | 2
 | ABB 612-010200-226, рамка 2 поста белая | 4
 | ABB 612-010200-226, рамка 2 поста белая | 1
 | ABB 612-010200-226, рамка 2 поста белая | 1
 | ABB 612-010200-226, рамка 2 поста белая | 1
 | ABB 612-010200-226, рамка 2 поста белая | 2
 | ABB 612-010200-226, рамка 2 поста белая | 1
 | ABB 612-010200-227, рамка 3 поста белая | 1
 | ABB 612-010200-227, рамка 3 поста белая | 1
 | ABB 612-010200-228, рамка 4 поста белая | 1
 | ABB 612-010200-228, рамка 4 поста белая | 1
 | ABB 612-010200-228, рамка 4 поста белая | 1
 | ABB 612-010200-228, рамка 4 поста белая | 1
 | ABB 612-010200-228, рамка 4 поста белая | 1
 | ABB 612-010200-228, рамка 4 поста белая | 1
 | ABB 612-010200-228, рамка 4 поста белая | 1
 | ABB 612-010200-228, рамка 4 поста белая | 1
 | ABB 612-010200-228, рамка 4 поста белая | 1
 | ABB 612-010200-228, рамка 4 поста белая | 1
 | ABB 612-010200-228, рамка 4 поста белая | 1
 | ABB 612-010200-228, рамка 4 поста белая | 1
 | ABB 612-010200-228, рамка 4 поста белая | 1
 | ABB 612-010200-228, рамка 4 поста белая | 1
 | ABB 612-010200-271, рамка 1 пост белая | 1
 | ABB 612-010200-271, рамка 1 пост белая | 2
 | ABB 612-010200-271, рамка 1 пост белая | 1
 | ABB 612-010200-271, рамка 1 пост белая | 1
 | ABB 612-010200-271, рамка 1 пост белая | 1
 | ABB 612-010200-271, рамка 1 пост белая | 1
 | ABB 612-010200-271, рамка 1 пост белая | 1
 | ABB 612-010200-271, рамка 1 пост белая | 1
 | ABB 612-010200-271, рамка 1 пост белая | 2
 | ABB 612-010200-271, рамка 1 пост белая | 1
 | ABB 612-010200-271, рамка 1 пост белая | 1
 | ABB 612-010200-271, рамка 1 пост белая | 2
 | ABB 612-010200-271, рамка 1 пост белая | 1
 | ABB 612-010200-271, рамка 1 пост белая | 1
 | ABB 612-010200-271, рамка 1 пост белая | 1
 | ABB 612-010200-271, рамка 1 пост белая | 2
 | ABB 612-010200-271, рамка 1 пост белая | 3
 | ABB 612-010200-271, рамка 1 пост белая | 2
 | ABB 612-010200-271, рамка 1 пост белая | 1
 | ABB 612-010200-271, рамка 1 пост белая | 1
QS-1.1 (свет) | ABB 619-010200-205, выключатель кнопочный одноклавишный | 1
QS-2.1 | ABB 619-010200-205, выключатель кнопочный одноклавишный | 1
QS-3.1 (свет) | ABB 619-010200-205, выключатель кнопочный одноклавишный | 1
QS-4.1 (свет) | ABB 619-010200-205, выключатель кнопочный одноклавишный | 1
QS-5.1 (свет) | ABB 619-010200-205, выключатель кнопочный одноклавишный | 1
QS-5.2 | ABB 619-010200-205, выключатель кнопочный одноклавишный | 1
QS-6.1..QS-6.3 | ABB 619-010200-205, выключатель кнопочный одноклавишный | 3
QS-6.4 | ABB 619-010200-205, выключатель кнопочный одноклавишный | 1
QS-6.7 | ABB 619-010200-205, выключатель кнопочный одноклавишный | 1
QS-6.5, QS-6.6 | ABB 619-010200-205, выключатель кнопочный одноклавишный | 2
QS-9.1 | ABB 619-010200-205, выключатель кнопочный одноклавишный | 1
QS-1.1 (жалюзи) | ABB 619-010200-216, выключатель кнопочный 2-клавишный для управления жалюзи | 1
QS-3.1..QS-3.3 (жалюзи) | ABB 619-010200-216, выключатель кнопочный 2-клавишный для управления жалюзи | 3
QS-4.1 (жалюзи) | ABB 619-010200-216, выключатель кнопочный 2-клавишный для управления жалюзи | 1
QS-5.1 (жалюзи) | ABB 619-010200-216, выключатель кнопочный 2-клавишный для управления жалюзи | 1
XS-7.1..XS-7.4 | ABB 619-010200-218, модуль розеточный с заземлением и крышкой, белый | 4
XS-9.1,XS-9.2 | ABB 619-010200-218, модуль розеточный с заземлением и крышкой, белый | 2
BA-1.1, BA-1.2 | ABB 619-010200-241, аудиорозетка двойная, белая | 2
BA-3.1, BA-3.2 | ABB 619-010200-241, аудиорозетка двойная, белая | 2
BA-4.1, BA-4.2 | ABB 619-010200-241, аудиорозетка двойная, белая | 2
BA-5.1, BA-5.2 | ABB 619-010200-241, аудиорозетка двойная, белая | 2
XS-1.1, XS-1.2 | ABB 619-010200-243, модуль розеточный с заземлением и шторками, белый | 2
XS-1.3, XS-1.4 | ABB 619-010200-243, модуль розеточный с заземлением и шторками, белый | 2
XS-1.5… XS-1.8 | ABB 619-010200-243, модуль розеточный с заземлением и шторками, белый | 4
XS-1.9, XS-1.10 | ABB 619-010200-243, модуль розеточный с заземлением и шторками, белый | 2
XS-1.11, XS-1.12 | ABB 619-010200-243, модуль розеточный с заземлением и шторками, белый | 2
XS-1.13.. XS-1.18 | ABB 619-010200-243, модуль розеточный с заземлением и шторками, белый | 6
XS-2.1,XS-2.2 | ABB 619-010200-243, модуль розеточный с заземлением и шторками, белый | 2
XS-2.3,XS-2.4 | ABB 619-010200-243, модуль розеточный с заземлением и шторками, белый | 2
XS-2.5...XS-2.8 | ABB 619-010200-243, модуль розеточный с заземлением и шторками, белый | 4
XS-3.1,XS-3.2 | ABB 619-010200-243, модуль розеточный с заземлением и шторками, белый | 2
XS-3.3..XS-3.5 | ABB 619-010200-243, модуль розеточный с заземлением и шторками, белый | 3
XS-3.6..XS-3.9 | ABB 619-010200-243, модуль розеточный с заземлением и шторками, белый | 4
XS-3.10..XS-3.13 | ABB 619-010200-243, модуль розеточный с заземлением и шторками, белый | 4
XS-3.14,XS-3.15 | ABB 619-010200-243, модуль розеточный с заземлением и шторками, белый | 2
XS-3.16..XS-3.19 | ABB 619-010200-243, модуль розеточный с заземлением и шторками, белый | 4
XS-4.1..XS-4.3 | ABB 619-010200-243, модуль розеточный с заземлением и шторками, белый | 3
XS-4.4..XS-4.6 | ABB 619-010200-243, модуль розеточный с заземлением и шторками, белый | 3
XS-4.7,XS-4.8 | ABB 619-010200-243, модуль розеточный с заземлением и шторками, белый | 2
XS-4.9..XS-4.11 | ABB 619-010200-243, модуль розеточный с заземлением и шторками, белый | 3
XS-4.12,XS-4.13 | ABB 619-010200-243, модуль розеточный с заземлением и шторками, белый | 2
XS-4.14..XS-4.19 | ABB 619-010200-243, модуль розеточный с заземлением и шторками, белый | 6
XS-5.3,XS-5.4 | ABB 619-010200-243, модуль розеточный с заземлением и шторками, белый | 2
XS-5.5..XS-5.8 | ABB 619-010200-243, модуль розеточный с заземлением и шторками, белый | 4
XS-5.20..XS-5.23 | ABB 619-010200-243, модуль розеточный с заземлением и шторками, белый | 4
XS-6.1..XS-6.8 | ABB 619-010200-243, модуль розеточный с заземлением и шторками, белый | 8
XS-6.11,XS-6.12 | ABB 619-010200-243, модуль розеточный с заземлением и шторками, белый | 2
XL-1.1 | ABB 619-010200-247, розетка RJ-45, белая | 1
XL-1.3 | ABB 619-010200-247, розетка RJ-45, белая | 1
XL-1.2 | ABB 619-010200-247, розетка RJ-45, белая | 1
XL-2.1 | ABB 619-010200-247, розетка RJ-45, белая | 1
XL-2.2 | ABB 619-010200-247, розетка RJ-45, белая | 1
XL-3.1 | ABB 619-010200-247, розетка RJ-45, белая | 1
XL-3.4 | ABB 619-010200-247, розетка RJ-45, белая | 1
XL-3.3 | ABB 619-010200-247, розетка RJ-45, белая | 1
XL-3.2 | ABB 619-010200-247, розетка RJ-45, белая | 1
XL-4.3 | ABB 619-010200-247, розетка RJ-45, белая | 1
XL-4.2 | ABB 619-010200-247, розетка RJ-45, белая | 1
XL-4.1 | ABB 619-010200-247, розетка RJ-45, белая | 1
XL-4.5 | ABB 619-010200-247, розетка RJ-45, белая | 1
XL-4.4 | ABB 619-010200-247, розетка RJ-45, белая | 1
XL-5.1 | ABB 619-010200-247, розетка RJ-45, белая | 1
QS-1.2 | ABB 619-010200-257, выключатель кнопочный двуклавишный | 1
QS-1.3 | ABB 619-010200-257, выключатель кнопочный двуклавишный | 1
QS-3.2 (свет) | ABB 619-010200-257, выключатель кнопочный двуклавишный | 1
QS-3.3 (свет) | ABB 619-010200-257, выключатель кнопочный двуклавишный | 1
QS-4.2 | ABB 619-010200-257, выключатель кнопочный двуклавишный | 1
QS-4.3 | ABB 619-010200-257, выключатель кнопочный двуклавишный | 1
QS-6.9 | ABB 619-010200-257, выключатель кнопочный двуклавишный | 1
BGRV-6.2 | ABB 619-010200-262, датчик движения релейный | 1
BGRV-6.1 | ABB 619-010200-262, датчик движения релейный | 1
XT-1.1 | ABB 619-010200-273, розетка ТВ оконечная с экранированием, белая | 1
XT-3.1 | ABB 619-010200-273, розетка ТВ оконечная с экранированием, белая | 1
XT-5.1 | ABB 619-010200-273, розетка ТВ оконечная с экранированием, белая | 1
 | ABB 619-010200-299, заглушка белая | 2

Sheet: ДКС для спеки
ДКС 10034, PDB коробка монтажная под 2 модуля "Brava" | 4
ДКС 10482, коробка в сборе с силовой электрической розеткой, с заземлением, с защитными шторками | 14
ДКС 53500R, коробка круглая ответвительная | 5
ДКС 75010W, рамка для монтажа ЭУИ "Brava" в стены и коробки PDD-N60, одноместная (2 модуля) | 11
ДКС 75012W, рамка для монтажа ЭУИ "Brava" в стены и коробки PDD-N60, двухместная (4 модуля) | 31
ДКС 75014W, рамка для монтажа ЭУИ "Brava" в стены и коробки PDD-N60, четыреххместная (8 модулей) | 10
ДКС 75015W, рамка для монтажа ЭУИ "Brava" в стены и коробки PDD-N60, пятиместная (10 модулей) | 4
ДКС 75023W, каркас для монтажа ЭУИ "Brava" в стены и коробки PDD-N60, белый, без лапок | 133
ДКС 76021B, кнопка белая, 1 модуль | 26
ДКС 76022B, кнопка белая, 2 модуля | 16
ДКС 76482B, модуль розеточный с заземлением и шторками, белый | 88
ДКС 76616B, заглушка 1 модуль, белая | 3
ДКС 76655B, компьютерная розетка RJ-45 с 1 разъемом, 2 модуля, белая | 15
ДКС 76721B, розетка ТВ, 1 модуль, белая | 3
ДКС 10034, PDB коробка монтажная под 2 модуля "Brava" | 1
ДКС 10034, PDB коробка монтажная под 2 модуля "Brava" | 1
ДКС 10034, PDB коробка монтажная под 2 модуля "Brava" | 1
ДКС 10034, PDB коробка монтажная под 2 модуля "Brava" | 1
ДКС 10482, коробка в сборе с силовой электрической розеткой, с заземлением, с защитными шторками | 2
ДКС 10482, коробка в сборе с силовой электрической розеткой, с заземлением, с защитными шторками | 2
ДКС 10482, коробка в сборе с силовой электрической розеткой, с заземлением, с защитными шторками | 2
ДКС 10482, коробка в сборе с силовой электрической розеткой, с заземлением, с защитными шторками | 3
ДКС 10482, коробка в сборе с силовой электрической розеткой, с заземлением, с защитными шторками | 2
ДКС 10482, коробка в сборе с силовой электрической розеткой, с заземлением, с защитными шторками | 3
ДКС 53500R, коробка круглая ответвительная | 3
ДКС 53500R, коробка круглая ответвительная | 2
ДКС 75010W, рамка для монтажа ЭУИ "Brava" в стены и коробки PDD-N60, одноместная (2 модуля) | 1
ДКС 75010W, рамка для монтажа ЭУИ "Brava" в стены и коробки PDD-N60, одноместная (2 модуля) | 1
ДКС 75010W, рамка для монтажа ЭУИ "Brava" в стены и коробки PDD-N60, одноместная (2 модуля) | 3
ДКС 75010W, рамка для монтажа ЭУИ "Brava" в стены и коробки PDD-N60, одноместная (2 модуля) | 2
ДКС 75010W, рамка для монтажа ЭУИ "Brava" в стены и коробки PDD-N60, одноместная (2 модуля) | 1
ДКС 75010W, рамка для монтажа ЭУИ "Brava" в стены и коробки PDD-N60, одноместная (2 модуля) | 1
ДКС 75010W, рамка для монтажа ЭУИ "Brava" в стены и коробки PDD-N60, одноместная (2 модуля) | 1
ДКС 75010W, рамка для монтажа ЭУИ "Brava" в стены и коробки PDD-N60, одноместная (2 модуля) | 1
ДКС 75012W, рамка для монтажа ЭУИ "Brava" в стены и коробки PDD-N60, двухместная (4 модуля) | 1
ДКС 75012W, рамка для монтажа ЭУИ "Brava" в стены и коробки PDD-N60, двухместная (4 модуля) | 2
ДКС 75012W, рамка для монтажа ЭУИ "Brava" в стены и коробки PDD-N60, двухместная (4 модуля) | 1
ДКС 75012W, рамка для монтажа ЭУИ "Brava" в стены и коробки PDD-N60, двухместная (4 модуля) | 3
ДКС 75012W, рамка для монтажа ЭУИ "Brava" в стены и коробки PDD-N60, двухместная (4 модуля) | 1
ДКС 75012W, рамка для монтажа ЭУИ "Brava" в стены и коробки PDD-N60, двухместная (4 модуля) | 1
ДКС 75012W, рамка для монтажа ЭУИ "Brava" в стены и коробки PDD-N60, двухместная (4 модуля) | 2
ДКС 75012W, рамка для монтажа ЭУИ "Brava" в стены и коробки PDD-N60, двухместная (4 модуля) | 1
ДКС 75012W, рамка для монтажа ЭУИ "Brava" в стены и коробки PDD-N60, двухместная (4 модуля) | 3
ДКС 75012W, рамка для монтажа ЭУИ "Brava" в стены и коробки PDD-N60, двухместная (4 модуля) | 2
ДКС 75012W, рамка для монтажа ЭУИ "Brava" в стены и коробки PDD-N60, двухместная (4 модуля) | 4
ДКС 75012W, рамка для монтажа ЭУИ "Brava" в стены и коробки PDD-N60, двухместная (4 модуля) | 1
ДКС 75012W, рамка для монтажа ЭУИ "Brava" в стены и коробки PDD-N60, двухместная (4 модуля) | 2
ДКС 75012W, рамка для монтажа ЭУИ "Brava" в стены и коробки PDD-N60, двухместная (4 модуля) | 1
ДКС 75012W, рамка для монтажа ЭУИ "Brava" в стены и коробки PDD-N60, двухместная (4 модуля) | 0.5
ДКС 75012W, рамка для монтажа ЭУИ "Brava" в стены и коробки PDD-N60, двухместная (4 модуля) | 0.5
ДКС 75012W, рамка для монтажа ЭУИ "Brava" в стены и коробки PDD-N60, двухместная (4 модуля) | 0.5
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
Коробка установочная 65-68 мм, глубина не менее 40 мм | 1
Коробка установочная 65-68 мм, глубина не менее 40 мм | 1
Коробка установочная 65-68 мм, глубина не менее 40 мм | 1
Коробка установочная 65-68 мм, глубина не менее 40 мм | 1
Коробка установочная 65-68 мм, глубина не менее 40 мм | 1
Коробка установочная 65-68 мм, глубина не менее 40 мм | 1
Коробка установочная 65-68 мм, глубина не менее 40 мм | 1
Коробка установочная 65-68 мм, глубина не менее 40 мм | 1
Коробка установочная 65-68 мм, глубина не менее 40 мм | 3
Коробка установочная 65-68 мм, глубина не менее 40 мм | 1
Коробка установочная 65-68 мм, глубина не менее 40 мм | 1
