antony-sm/Ovrajnaya_stadia_RD/04 ЭОМ СС/спецификация.xlsx

Sheet: Лист1
Позиция | Наименование и технические характеристики | Тип, марка, обозначение документа, опросного листа | Код оборуд. изделия, материалов | Завод изготовитель | Единица измерения | Кол-во | Примечание | Цена | Стоимость
 | Освещение
1 | Светильник настенно-потолочный | A6462PL-3CK ARCHIMEDE 3xE27 60W 220V IP |  | Arte Lamp | шт. | 8
2 | Светильник настенно-потолочный | ARCHIMEDE A6462AP-1CK (1х40) |  | Arte Lamp | шт. | 8
3 | Светильник настенный | Citilux CL512523 Готика |  |  | шт. | 3
4 | Потолочный светильник | Arte Lamp 95 A8252PL-1CK |  |  | шт. | 2
5 | Блок питания | ARPV-12045B (12V, 3.75A, 45W) |  |  | шт. | 3
6 | Светильник светодиод. настенно-потолочный 7Вт бел.IP65 | 94822 NBL-PO1-7-4K-WH-IP65-LED |  | Navigator | шт. | 2
7 | Светильник светодиодный 600x600 мм | SLIM LED 595 (40) 4000K |  | Световые технологии | шт. | 3
8 | Датчик движения потолочный |  |  |  | шт. | 2
 | ЭУИ
1 | Модуль розеточный с заземлением и шторками, белый |  | 619-010200-243 | ABB | шт. | 84
2 | Модуль розеточный с заземлением и крышкой, белый |  | 619-010200-218 | ABB | шт. | 6
3 | Розетка RJ-45, белая |  | 619-010200-247 | ABB | шт. | 15
4 | Розетка ТВ оконечная с экранированием, белая |  | 619-010200-273 | ABB | шт. | 3
5 | Выключатель кнопочный одноклавишный |  | 619-010200-205 | ABB | шт. | 14
6 | Выключатель кнопочный двуклавишный |  | 619-010200-257 | ABB | шт. | 7
7 | Выключатель кнопочный 2-клавишный для управления жалюзи |  | 619-010200-216 | ABB | шт. | 6
8 | Аудиорозетка двойная, белая |  | 619-010200-241 | ABB | шт. | 8
9 | Датчик движения релейный |  | 619-010200-262 | ABB | шт. | 2
10 | Заглушка белая |  | 619-010200-299 | ABB | шт. | 2
11 | Рамка 1 пост белая |  | 612-010200-271 | ABB | шт. | 27
12 | Рамка 2 поста белая |  | 612-010200-226 | ABB | шт. | 29
13 | Рамка 3 поста белая |  | 612-010200-227 | ABB | шт. | 2
14 | Рамка 4 поста белая |  | 612-010200-228 | ABB | шт. | 14
15 | Коробка 84х84х45 мм | 53700 |  | ДКС | шт. | 50
16 | Коробка телефонная на 3 плинта LSA 2/10 пластиковая | KR-INBOX-30-S |  | Hyperline | шт. | 1
17 | Плинт LSA-PLUS 2/10 10 пар неразмык. контакты маркировка 0…9 | Krone 6089 1 002-06 LSA-PLUS 2/10 |  | Tyco Electoniсs | шт. | 2
18 | Коробка установочная ГСК 1 пост Dвнеш=68мм Н=40мм пластик лапки с винтами | Тусо 10170 |  | Рувинил | шт. | 240
19 | Крышка D=90мм расстояние между винтами 60мм | Тусо КР7072 |  | Рувинил | шт. | 50
20 | Реле контроля напряжения в розетку | РН-116 |  | ООО «НОВАТЕК-ЭЛЕКТРО» | шт. | 1 | для холодильника
 | Слаботочка
1 | Колонка настенная | MS-40T(В) |  | Roxton | шт. | 8 | вторая очередь
2 | Колонка потолочная встраиваемая | CM5EH White |  | Apart | шт. | 2
3 | Часы вторичные |  |  |  | шт. | 7 | вторая очередь
4 | Шкаф автоматики |  |  |  | шт. | 3
 | Климатика
1 | Головка электротермическая нормально открытая двухпроводная 24В | 1929 |  | FAR | шт. | 4 | учтено в ВК
2 | Пульт управления кондиционером | KWC |  | Kentatsu | шт. | 1 | учтено в ОвиК
3 | Регулятор 0/1-10В | Rotary SR-2202-IN |  | Arlight | шт. | 4
4 | Резистор переменный 10 кОм* |  |  |  | шт. | 2
5 | Электропривод воздушных клапанов | DA04N24P |  | Luftberg | шт. | 9 | учтено в ОвиК
 | Автоматика
1 | Датчик протечки (из комплекта «Аквасторож») |  |  |  | шт. | 3 | учтено в ВК
2 | Датчик температуры и влажности | SHT1x |  |  | шт. | 8 | вторая очередь
3 | Датчик температуры | DS18B20 |  |  | шт. | 3
4 | Датчик температуры | VT.AC501.0.0 |  | VALTEC | шт. | 2
5 | Детектор углекислого газа | SNS-MQ135 |  |  | шт. | 4 | вторая очередь
6 | Дифференциальный датчик давления | QBM2030-1U |  | Siemens | шт. | 7 | вторая очередь
7 | Извещатель магнитоконтактный врезной | ИО 102-5 |  |  | шт. | 8
8 | Извещатель магнитоконтактный накладной для металлических конструкций | ИО 102-29 "Эстет-сейф" |  |  | шт. | 1
9 | Извещатель магнитоконтактный накладной | ИО 102-14 |  |  | шт. | 17
10 | Контроллер «Аквасторож-Эксперт» |  |  |  | шт. | 1 | учтено в ВК
11 | Сервопривод | FS5103R |  |  | шт. | 6 | 1 есть
12 | Счетчик воды с импульсным выходом ½ Valtec |  |  |  | шт. | 2 | учтено в ВК
13 | Счетчик воды с импульсным выходом ¾ ВСКМ 90-20 |  |  |  | шт. | 2 | учтено в ВК
14 | Фоторезистор |  |  |  | шт. | 4
15 | Энкодер | miniQ |  |  | шт. | 6 | 1 есть
16 | Светодиод с держателем желтый 12V |  |  |  | шт. | 2
 | Система безопасности
1 | Аудиодомофон |  |  |  | шт. | 1
2 | Звонок дверной |  |  |  | шт. | 1
3 | Камера-видеоглазок цветная |  |  |  | шт. | 1
4 | Кнопка звонка |  |  |  | шт. | 1
5 | Монитор TFT миниатюрный цветной |  |  |  | шт. | 1
6 | Кнопка включения монитора |  |  |  | шт. | 1
7 | Реле времени |  |  |  | шт. | 1
 | Пожарная сигнализация
1 | Извещатель пожарный дымовой адресный | ДИП-34А-03 |  | Болид | шт. | 9
2 | Блок реле | С2000-СП1 |  | Болид | шт. | 1
3 | Контроллер двухпроводной линии | С2000-КДЛ |  | Болид | шт. | 1
4 | Пульт контроля и управления | С2000М |  | Болид | шт. | 1
5 | Расширитель адресный | С2000-АР1 исп.01 |  | Болид | шт. | 3
6 | Источник питания | СКАТ-1200С |  | Бастион | шт. | 1
7 | Аккумулятор 12В 7Ач |  |  |  | шт. | 1
8 | Кабель огнестойкий | КПСнг(А)-FRLS 1x2x0,5 мм |  |  | м | 80
9 | Извещатель тепловой линейный (термокабель) | ИПЛТ 138/280 EPC |  |  | м | 5
10 | Преобразователь USB-RS232 |  |  | Болид | шт. | 1
 | Кабели
1 | Кабель силовой | ВВГнг(А)-LS 2x1,5 |  |  | м | 450
2 | Кабель силовой | ВВГнг(А)-LS 3x1,5 |  |  | м | 270
3 | Кабель силовой | ВВГнг(А)-LS 3x2,5 |  |  | м | 340
4 | Кабель силовой | ВВГнг(А)-LS 3x4 |  |  | м | 10
5 | Кабель силовой | ВВГнг(А)-LS 3x6 |  |  | м | 20
6 | Кабель контрольный | КВВГнг(А)-LS 5х0,75 |  |  | м | 30
7 | Кабель связи | КСПВ 2х0,50 мм |  |  | м | 200
8 | Кабель связи | РК75-4,9-312А (RG-6) |  |  | м | 60
9 | Кабель связи | ParLan U/UTP 2х2х0,52 мм |  |  | м | 260
10 | Кабель связи | ParLan U/UTP 4х2х0,52 мм |  |  | м | 530
11 | Аудиошнур 2х2,5 кв.мм ГОСТ прозрачный | 40183 |  |  | м | 130
 | Лотки
1 | Лоток проволочный 30х150х3000 мм | FC3015 |  | ДКС | шт. | 4
2 | Лоток проволочный 30х100х3000 мм | FC3010 |  | ДКС | шт. | 5
3 | Лоток проволочный 30х50х3000 мм | FC3005 |  | ДКС | шт. | 8
 | Трубы
1 | Труба ПВХ 16 мм, легкая с протяжкой | 91916 |  | ДКС | м | 560
2 | Труба ПВХ 20 мм, легкая с протяжкой | 91920 |  | ДКС | м | 250
3 | Труба ПВХ 25 мм, легкая с протяжкой | 91925 |  | ДКС | м | 10
4 | Держатель 16 мм | 51016 |  | ДКС | шт. | 200
5 | Держатель 20 мм | 51020 |  | ДКС | шт. | 100
6 | Держатель 25 мм | 51025 |  | ДКС | шт. | 10
7 | Держатель 16 мм |  |  |  | шт. | 700
8 | Держатель 20 мм |  |  |  | шт. | 250
6 | Держатель 25 мм |  |  |  | шт. | 20
9 | Трубка медная ¼" (6,35 мм) |  |  |  | м | 75
 | Клеммники
1 | Зажим безвинтовой 3х(0,5-2,5) кв.мм с пастой для меди и алюминия | 2273-243 |  | Wago | шт. | 100
2 | Зажим безвинтовой 4х(0,5-2,5) кв.мм с пастой для меди и алюминия | 2273-244 |  | Wago | шт. | 100
3 | Зажим безвинтовой | 221-413 |  | Wago | шт. | 20
4 | Шина «ноль» 7 отв. | 507F |  | ДКС | шт. | 3
 | Дополнительная система уравнивания потенциалов (ДСУП)
1 | Провод 6 кв.мм желто-зеленый | ПУГВ 1х6 ж/з |  |  | м | 12
2 | Провод 4 кв.мм желто-зеленый | ПУГВ 1х4 ж/з |  |  | м | 100
3 | Наконечник 6 кв.мм изолированный | E6012 6,0-12 |  |  | шт. | 2
4 | Наконечник 4 кв.мм изолированный | E4009 4,0-9 |  |  | шт. | 50
5 | Наконечник 4 кв.мм изолированный двойной | TE4012 4,0-12 |  |  | шт. | 50
6 | Наконечник 6,0-5 кольцевой 6мм2 изолированный желтый | RV5.5-5 |  |  | шт. | 40
7 | Зажим для троса 3 мм |  |  |  | шт. | 40
8 | Коробка уравнивания потенциалов 150х110х70мм для откр.устан.шина 13 зажимов 63А | Э1065 |  | МПО Электромонтаж | шт. | 1 | туалет
9 | Шина N20 ноль 2 изолятора на 20 присоединений никелированная латунь 63А | Э1322 |  | МПО Электромонтаж | шт. | 1 | гл. щит
 | Щит
1 | WR-профиль вертикальный | ZW372 |  | ABB | шт. | 2
2 | WR-перемычка, ширина 3 GU (750 мм) | ZW166 |  | ABB | шт. | 2
3 | Кронштейн монтажный | ZW64 |  | ABB | шт. | 4
5 | Модуль Combiline-M для устройств на DIN-рейку, 750х450 мм, расстояние 125 мм | MBG303 | 41663 | ABB | шт. | 1
6 | Модуль Combiline-M для клемм, 750х450 мм | MBK308 | 41693 | ABB | шт. | 1
7 | Держатель проводки 28,5 мм, 10 шт. | ED44P10 |  | ABB | к-т | 5
 | Аппаратура щита
8 | Выключатель-рубильник | SD202/63 | 2CDD282101R0063 | ABB | шт. | 2
9 | Расцепитель независимый | S2C-A1 | 2CDS200909R0001 | ABB | шт. | 2
10 | Прибор комбинированный | P94-ML-1-0,5-RS485 |  | OMIX | шт. | 1
11 | Трансформатор тока | TRFM/60 | 2CSM100070R1111 | ABB | шт. | 1
12 | Устройство защитное | РН-260t |  | НоваТек | шт. | 1
13 | Выключатель автоматический | S201-B10 | 2CDS251001R0105 | ABB | шт. | 9
14 | Выключатель автоматический | S201-B16 | 2CDS251001R1165 | ABB | шт. | 12
15 | Выключатель автоматический | S201-C10 | 2CDS251001R0104 | ABB | шт. | 3
16 | Выключатель автоматический | S201-C16 | 2CDS251001R0164 | ABB | шт. | 3
17 | Выключатель автоматический | S201-C20 | 2CDS251001R0204 | ABB | шт. | 1
18 | Выключатель автоматический | S201-C32 | 2CDS251001R0324 | ABB | шт. | 2
19 | Устройство защитного отключения | F202 A S-63/0.1 |  | ABB | шт. | 1 | если будет срабатывать этажное
20 | Устройство защитного отключения | F202 A-16/0.01 | 2CSF202101R0160 | ABB | шт. | 10
21 | Устройство защитного отключения | F202 A-25/0.03 | 2CSF202101R1250 | ABB | шт. | 1
22 | Устройство защитного отключения | F202 A-40/0.03 | 2CSF202101R1400 | ABB | шт. | 4
23 | Устройство защитного отключения | F202 A-63/0.03 | 2CSF202101R1630 | ABB | шт. | 3
24 | Реле блокировочное | E290-16-10/24 | 2TAZ312000R2041 | ABB | шт. | 11
25 | Реле блокировочное | E291S-16-20/24 | 2TAZ313000R2042 | ABB | шт. | 3
26 | Реле влажности | RH-1 |  |  | шт. | 1
27 | Реле задержки времени | RV-01 |  |  | шт. | 1
28 | Источник питания | «МОЛЛЮСК-12/1,3 DIN» |  |  | шт. | 1
29 | Коробка для двух розеток со шторками |  |  | ABB | шт. | 1
30 | ИБП | APC Smart-UPS XL 1000 ВА |  | APC | шт. | 1
31 | Блок розеток 19" 8 розеток евро, 16А, клеммное подключение | MDX-PDU-8E-16A-Term |  |  | шт. | 1
32 | Патч-панель 19", 1U, 16 портов RJ-45, категория 5e | PP3-19-16-8P8C-C5E-110D |  |  | шт. | 1
33 | Коммутатор 16 портов управляемый | TL-SG3216 |  | TP-LINK | шт. | 1
34 | Разветвитель ТВ 1 на 3 | 05-6002 |  | Rexant | шт. | 1
35 | Компьютер одноплатный | Paspberry Pi 2B |  |  | шт. | 1
36 | Адаптер 5В 1А, выход microUSB |  |  |  | шт. | 1
37 | Компьютер одноплатный | Paspberry Pi B+ |  |  | шт. | 5
38 | Аудиомодуль | HiFiBerry Amp+ |  |  | шт. | 5
39 | Источник питания 12В 10А | МОЛЛЮСК-12/10 IP20-DIN |  | Бастион | шт. | 1
40 | Коммутатор 8 портов неуправляемый | TL-SG108 |  | TP-LINK | шт. | 1
41 | Клемма | ZS4-D1 |  | ABB | шт. | 4
42 | Компьютер одноплатный | Paspberry Pi 3B |  |  | шт. | 1
43 | Адаптер 5В 1А, выход microUSB |  |  |  | шт. | 1
44 | Преобразователь USB-RS485 |  |  |  | шт. | 2
45 | Терморегулятор | ТР 510 |  | Теплолюкс | шт. | 1
46 | Терморегулятор | TC F-3,7/1 |  |  | шт. | 1
47 | Контроллер | AF-KS |  | Kentatsu | шт. | 1
48 | Реле промежуточное 12В 1 перекл. | CR-P012DC1 |  | ABB | шт. | 2
49 | Колодка реле | CR-PLSx |  | ABB | шт. | 2
50 | Клемма | ZS4 |  | ABB | шт. | 5
53 | Источник питания 24В 2А | SKAT-24-2.0-DIN |  | Бастион | шт. | 1
54 | Плинт 10 пар неразмык. контакты маркировка 0…9 | LSA-PLUS 2/10 |  | Krone | шт. | 6
55 | Хомут монтажный на 3 плинта 2/10 глубина 30мм шаг 22,5мм | KR-FRAME-30 |  | Hyperline | шт. | 2
56 | Патч-корд |  |  |  | шт. | 21
57 | Шнур питания |  |  |  | шт. | 1 | штатный
58 | Удлинитель USB |  |  |  | шт. | 2
59 | F-разъем |  |  |  | шт. | 4
60 | Блок клеммный | ИЕК |  |  | шт. | 1
61 | Клемма | ZS4 | 1SNK505010R0000 | ABB | шт. | 73
62 | Клемма | ZS4-BL | 1SNK505020R0000 | ABB | шт. | 46
63 | Клемма | MRK 4 1652 |  |  | шт. | 23
64 | Клемма | NSYTRV62 |  | SE | шт. | 2
65 | Клемма | NSYTRV62BL |  | SE | шт. | 2
66 | Пластина торцевая | NSYTRAС22 |  | SE | шт. | 2
67 | Перемычка | JB5-10 | 1SNK905310R0000 | ABB | шт. | 3
68 | Блок клеммный | JHUKK-80 |  |  | шт. | 18
69 | Держатель шины |  | 12541 | ABB | шт. | 2
70 | Шина 25 отв. |  |  |  | шт. | 2
71 | Ограничитель на DIN-рейку | YXD10 |  | IEK | шт. | 25
72 | Изолятор торцевой | ES4 | 1SNK505910R0000 | ABB | шт. | 10
76 | Гребенка для автоматов 12 полюсов 63 А | PS1/12 | 2CDL210001R1012 | ABB | шт. | 3
77 | Торцевая заглушка | PS-END 0 | 2CDL200001R0004 | ABB | шт. | 12
78 | Гребенка для УЗО | PS2/12 | 2CDL220001R1012 | ABB | шт. | 3
79 | Торцевая заглушка | PS-END | 2CDL200001R0001 | ABB | шт. | 6
80 | Провод 10 кв.мм белый | ПУГВ 1х10 бел. |  |  | м | 7
81 | Провод 10 кв.мм голубой | ПУГВ 1х10 гол. |  |  | м | 7
82 | Провод 10 кв.мм желто-зеленый | ПУГВ 1х10 ж/з. |  |  | м | 7
83 | Провод 6 кв.мм белый | ПУГВ 1х6 бел. |  |  | м | 4
84 | Провод 6 кв.мм голубой | ПУГВ 1х6 гол. |  |  | м | 4
85 | Провод 4 кв.мм белый | ПУГВ 1х4 бел. |  |  | м | 3
86 | Провод 4 кв.мм голубой | ПУГВ 1х4 гол. |  |  | м | 3
87 | Провод 2,5 кв.мм красный | ПУГВ 1х2,5 кр. |  |  | м | 12
88 | Провод 2,5 кв.мм черный | ПУГВ 1х2,5 ч. |  |  | м | 12
89 | Провод 2,5 кв.мм белый | ПУГВ 1х2,5 бел. |  |  | м | 85
90 | Провод 2,5 кв.мм желто-зеленый | ПУГВ 1х2,5 ж/з. |  |  | м | 2
91 | Провод 2,5 кв.мм голубой | ПУГВ 1х2,5 гол. |  |  | м | 40
92 | Наконечник 2,5 кв.мм | НШВ 2,5-8 |  |  | шт. | 450
93 | Наконечник 4 кв.мм | НШВ 4,0-9 |  |  | шт. | 10
94 | Наконечник 6 кв.мм | НШВ 6,0-12 |  |  | шт. | 20
95 | Наконечник 10 кв.мм | НШВ 10-12 |  |  | шт. | 40
96 | ТУТ прозрачная 6/3 |  | Т3422 |  | м | 10
97 | ТУТ прозрачная 8/4 |  | Т3429 |  | м | 2
98 | Пресс-клещи HD-005 для медных неизолированных наконечников 0,5-10 кв. мм |  | И0655 |  | шт. | 1

Sheet: Лист2
Позиция | Наименование и технические характеристики | Тип, марка, обозначение документа, опросного листа | Код оборуд. изделия, материалов | Завод изготовитель | Единица измерения | Кол-во | Примечание
 | Туалет
1 | Трансформатор 220/24-0,04 0,04кВА тороидальный | Штиль ОСМ Т 220/24-0,04 0,04кВА | Б3810 | Тульский завод трансформаторов | шт. | 1
2 | Бокс белый на 6 модулей белая непрозрачная дверь IP41 (Текфор Москва) | UNN40-06-2 | Е0379 |  | шт. | 1
3 | Зажим безвинтовой 2х(0,08-4,0) кв.мм для медного провода | 222-412 | К4627 | Wago | шт. | 4
 | Кладовая, ША-2.1
1 | Клемма | MRK 2,5 1612 |  |  | шт. | 7
2 | Плинт 10 пар размык. контакты маркировка 0…9 | NMC-PL10-DU-10 LSA-PROFIL 2/10 | К1483 | Nikomax | шт. | 10
3 | Коробка телефонная на 10 плинтов LSA 2/10 пластик | KRB2-100 |  |  | шт. | 1
4 | Бокс белый на 6 модулей белая непрозрачная дверь IP41 (Текфор Москва) | UNN40-06-2 | Е0379 |  | шт. | 1
 | Кладовая, ША-2.2
1 | Блок питания 1ф выход 24В пост. тока 2,5А стабилизированный | MDR-60-24 | К9959 | Mean Well | шт. | 1
2 | Трансформатор 220/24-0,025 0,025кВА тороидальный | Штиль ОСМ Т 220/24-0,025 0,025кВА | Б3807 | Тульский завод трансформаторов | шт. | 1
3 | Клемма | ZS4 | 1SNK505010R0000 | ABB | шт. | 10
4 | Перемычка | JB5-10 | 1SNK905310R0000 | ABB | шт. | 1
5 | Изолятор торцевой | ES4 | 1SNK505910R0000 | ABB | шт. | 1
6 | Клемма | MRK 2,5 1612 |  |  | шт. | 2
7 | Ограничитель на DIN-рейку | MR 35 арт. 1222 |  | ONKA Турция | шт. | 2
8 | Светосигнальная арматура зеленая AC 230В со светодиодом | CL2-523G | 1SFA619403R5232 | ABB | шт. | 1
9 | Переключатель черный 2з 2 положения с фиксацией | C2SS1-30B-20 | 1SFA619200R3026 | ABB | шт. | 1
10 | Шкаф 290х250х155мм светло-серый с монтажной платой без реек | 402S R5 | Б0115 | Щитэлектрокомплект | шт. | 1
 | Детская
1 | Клемма | MRK 2,5 1612 |  |  | шт. | 2
2 | Плинт 10 пар размык. контакты маркировка 0…9 | NMC-PL10-DU-10 LSA-PROFIL 2/10 | К1483 | Nikomax | шт. | 3
3 | Коробка распределительная с опорной рамой на 3 плинта | KRB2-30 |  |  | шт. | 1
4 | Бокс белый на 4 модуля белая непрозрачная дверь IP41 (Текфор Москва) | UNN40-04-2 | Е0376 |  | шт. | 1
 | Кухня
1 | Клемма | MRK 2,5 1612 |  |  | шт. | 2
2 | Плинт 10 пар размык. контакты маркировка 0…9 | NMC-PL10-DU-10 LSA-PROFIL 2/10 | К1483 | Nikomax | шт. | 3
3 | Коробка распределительная с опорной рамой на 3 плинта | KRB2-30 |  |  | шт. | 1
4 | Бокс белый на 4 модуля белая непрозрачная дверь IP41 (Текфор Москва) | UNN40-04-2 | Е0376 |  | шт. | 1
