antony-sm/Ovrajnaya_stadia_RD/04 ЭОМ СС/маркировка.xls

Sheet: клеммы
X7 | X35 | X65 | X4 | X32
X7 | X35 | X66 | X5 | X32
X7 | X36 | X67 | X6 | X43
X8 | X36 | X68 | X9 | X43
X8 | X37 | X69 | X9
X8 | X37 | X70 | X11
X8 | X38 | X71 | X11
X10 | X38 | X72 | X11
X10 | X39 | X72 | X12
X10 | X39 | X73 | X12
X15 | X40 | X73 | X12
X15 | X40 | X74 | X12
X16 | X41 | X74 | X18
X16 | X41 | X75 | X18
X17 | X42 | X75 | X18
X17 | X42 | X76 | X18
X19 | X44 | X76 | X94
X19 | X44 | X77 | X95
X19 | X45 | X77
X20 | X45 | X78
X20 | X46 | X78
X21 | X46 | X79
X21 | X47 | X79
X22 | X47 | X80
X22 | X48 | X80
X23 | X48 | X81
X23 | X48 | X81
X24 | X49 | X82
X24 | X49 | X82
X25 | X49 | X83
X25 | X50 | X83
X26 | X50 | X84
X26 | X50 | X84
X27 | X51 | X85
X27 | X52 | X85
X28 | X53 | X86
X28 | X54 | X86
X29 | X55 | X87
X29 | X56 | X87
X30 | X57 | X88
X30 | X58 | X88
X31 | X59 | X89
X31 | X60 | X89
X33 | X61 | X90
X33 | X62 | X90
X34 | X63 | X91
X34 | X64 | X91
 |  | X91

Sheet: провода
0 | 0 | 0 | 0 | 0 | 0 | 0 | 0 | 0 | 0
0 | 0 | 0 | 0 | 0 | 0 | 0 | 0 | 0 | 0
0 | 0 | 0 | 0 | 0 | 0 | 0 | 0 | 0 | 0
0 | 0 | 0 | 0 | 0 | 0 | 0 | 0 | 0 | 0
0 | 0 | 0 | 0 | 0 | 0 | 0 | 0 | 0 | 0
0 | 0 | 0 | 0 | 0 | 0 | 0 | 0 | 0 | 0
0 | 0 | 0 | 0 | 0 | 0 | 0 | 0 | 0 | 0
0 | 0 | 0 | 0 | 0 | 0 | 0 | 0 | 0 | 0
0 | 0 | 0 | 0 | 0 | 0 | 0 | 0 | 0 | 0
0 | 0 | 0 | 0 | 0 | 0 | 0 | 0 | 0 | 0
0 | 0 | 0 | 0 | 0 | 0 | 0 | 0 | 0 | 0
0 | 0 | 0 | 0 | 0 | 0 | 0 | 0 | 0 | 0
0 | 0 | 0 | 0 | 0 | 0 | 0 | 0 | 0 | 0
0 | 0 | 0 | 0 | 0 | 0 | 0 | 0 | 0 | 0
0 | 0 | 0 | 0 | 0 | 0 | 0 | 0 | 0 | 0
0 | 0 | 0 | 0 | 0 | 0 | 0 | 0 | 0 | 0
0 | 0 | 0 | 0 | 0 | 0 | 0 | 0 | 0 | 0
0 | 0 | 0 | 0 | 0 | 0 | 0 | 0 | 0 | 0
0 | 0 | 0 | 0 | 0 | 0 | 0 | 0 | 0 | 0
0 | 0 | 0 | 0 | 0 | 0 | 0 | 0 | 0 | 0
0 | 0 | 0 | 0 | 0 | 0 | 0 | 0 | 0 | 0
0 | 0 | 0 | 0 | 0 | 0 | 0 | 0 | 0 | 0
0 | 0 | 0 | 0 | 0 | 0 | 0 | 0 | 0 | 0
0 | 0 | 0 | 0 | 0 | 0 | 0 | 0 | 0 | 0
0 | 0 | 0 | 0 | 0 | 0 | 0 | 0 | 0 | 0
0 | 0 | 0 | 0 | 0 | 0 | 0 | 0 | 0 | 0
0 | 0 | 0 | 0 | 0 | 0 | 0 | 0 | 0 | 0
0 | 0 | 0 | 0 | 0 | 0 | 0 | 0 | 0 | 0
0 | 0 | 0 | 0 | 0 | 0 | 0 | 0 | 0 | 0
0 | 0 | 0 | 0 | 0 | 0 | 0 | 0 | 0 | 0
0 | 0 | 0 | 0 | 0 | 0 | 0 | 0 | 0 | 0
0 | 0 | 0 | 0 | 0 | 0 | 0 | 0 | 0 | 0
0 | 0 | 0 | 0 | 0 | 0 | 0 | 0 | 0 | 0
0 | 0 | 0 | 0 | 0 | 0 | 0 | 0 | 0 | 0
0 | 0 | 0 | 0 | 0 | 0 | 0 | 0 | 0 | 0
0 | 0 | 0 | 0 | 0 | 0 | 0 | 0 | 0 | 0
0 | 0 | 0 | 0 | 0 | 0 | 0 | 0 | 0 | 0
0 | 0 | 0 | 0 | 0 | 0 | 0 | 0 | 0 | 0
0 | 0 | 0 | 0 | 0 | 0 | 0 | 0 | 0 | 0
0 | 0 | 0 | 0 | 0 | 0 | 0 | 0 | 0 | 0
0 | 0 | 0 | 0 | 0 | 0 | 0 | 0 | 0 | 0
0 | 0 | 0 | 0 | 0 | 0 | 0 | 0 | 0 | 0
0 | 0 | 0 | 0 | 0 | 0 | 0 | 0 | 0 | 0
0 | 0 | 0 | 0 | 0 | 0 | 0 | 0
0 | 0 | 0 | 0 | 0 | 0 | 0 | 0
0 | 0 | 0 | 0 | 0 | 0 | 0 | 0

Sheet: модулька
Q1 | QD1
Q2 | QD2
UZM1 | QD3
VA1 | QD4
T1 | QD5
ER1 | QD6
QF1 | QD7
QF2 | QD8
QF3 | QD9
QF4 | QD10
QF5 | QD11
QF6 | QD12
QF7 | QD13
QF8 | QD14
QF9 | QD15
QF10 | QD16
QF11 | QD17
QF12 | QD18
QF13 | K1
QF14 | K2
QF15 | K3
QF16 | K4
QF17 | K5
QF18 | K6
QF19 | K7
QF20 | K8
QF21 | K9
QF22 | K10
QF23 | K11
QF24 | K12
QF25 | K13
QF26 | K14
QF27 | K15
QF28 | K16
QF29 | K17
QF30 | K18

Sheet: модулька новая
VA1 |  |  |  |  | Q1 |  | K1 | T1
 |  |  |  |  | Ввод |  | от
 |  |  |  |  |  |  | ПС
UZM1 |  |  | Q2 |  | K2 | QD11 |  | K18
Общее |  |  | Климат. |  | от | Климат. |  | Задержка
 |  |  | обор-ие |  | ПС | обор-ие |  | кондиционера
K4 | K5 | K6 | K7 | K8 | K9 | K10 | K11 | K12 | K13 | K14 | K15
Свет | Свет | Бра 1 | Бра 2 | Свет | Свет | Свет | Бра 1 | Бра 2 | Свет | Свет | Свет
клад. | спал. | спал. | спал. | кабин. | мак. | детск. | детск. | детск. | кухня | кор. | лодж.
K16 | K17 | QD1 |  | QD2 |  | QD3 |  | QD4 |  | QD5
Свет | Свет | Розетки |  | Розетка |  | Розетки |  | Розетки |  | Вароч.п.
ван. | туал. | спал.клад.каб. |  | ИБП |  | детск.корид. |  | кухня |  | Дух.шкаф
QD6 |  | QD7 |  | QD8 |  | QD9 |  | QD10 |  | QD12
Стирал. |  | Сушил. |  | Розетки |  | Розетки |  | Розетки |  | Водо
маш. |  | маш. |  | ванная |  | туалет |  | лоджия |  | нагреватель
QD13 |  | QD14 |  | QD15 |  | QD16 |  | QD17 |  | QD18
Тепл.пол |  | Автома- |  | Освещение |  | Освещение |  | Освещение |  | Освещение
лоджия |  | тика |  | основное |  | лоджия |  | ванная |  | туалет
QF1 | QF2 | QF3 | QF4 | QF5 | QF6 | QF7 | QF8 | QF9 | QF10 | QF11 | QF12
Роз. | Роз. | Роз. | Роз. | Роз. | Роз. | Роз. | Вар. | Дух. | Стир. | Суш. | Роз.
спал. | клад. | каб. | ИБП | детс. | кор. | кух. | пан. | шк. | маш. | маш. | ван.
QF13 | QF14 | QF15 | QF16 | QF17 | QF18 | QF19 | QF20 | QF21 | QF22 | QF23 | QF24
Роз. | Роз. | Пож. | Вент. | Конд | Водо | Тепл.п. | Авт. | Авт. | Свет | Свет | Свет
туал. | лод. | сигн. | увл. | иц. | нагр. | лодж. | гр.1 | гр.2 | клад. | спал. | кабин.
QF25 | QF26 | QF27 | QF28 | QF29 | QF30 | ER1
Свет | Свет | Свет | Свет | Свет | Свет | Кнопки
детск. | кухня | кор. | лодж. | ван. | туал. | реле освещ.
