antony-sm/Ovrajnaya_stadia_RD/05 ОВиК/расчёты.xls

Sheet: общее
Вентиляция
Норматив на 1 чел, куб. м/час | Кол-во чел | Производительность, куб. м/час | Мощность калорифера, Вт
30 | 4 | 120 | 2000
Кондиционирование, вариант 1
Помещение | Объем помещения, куб. м | Требуемая холодопроизводительность, кВт | Сечение воздуховода, кв. м | Диаметр круглого воздуховода, м | Сечение воздуховода 200х150 мм
Спальня | 39 | 1.17 | 0.020 | 0.161 | 0.03
Кабинет | 37 | 1.11 | 0.019 | 0.157 | 0.03
Детская | 35 | 1.05 | 0.018 | 0.152 | 0.03
Итого |  | 3.33
Добавка |  | 1
ИТОГО требуемая холодопроизводительность, кВт |  | 4.33
Кондиционирование, вариант 2
http://www.rfclimat.ru/htm/con_calc.htm
ИТОГО требуемая холодопроизводительность, кВт |  | 7
Кондиционирование, итоговое
ИТОГО требуемая холодопроизводительность, кВт |  | 5.665
Модель | Габариты, мм
Daikin FDXS60F
Kentatsu KSKT53HFAN1
Потери
Наименование | Поз на схеме
Воздуховод кондиционирования кабинета
Воздуховод кондиционирования детской

Sheet: потери
Типоразмер, мм | [эквивалентный] диаметр, мм | Расход, куб.м/ч | Потери на 1 м, Па | Потери в повороте, Па
200х150 | 200 | 272 | 0.8 | 1.7
110х55 | 90 | 30 | 0.32 | 0
204x60 | 122 | 105 | 1.2 | 2
 | 100 | 105 | 3.5 | 4
122x60 | 100 | 70 | 1.8 | 1.8
122x60 | 100 | 35 | 0.35 | 0
Наименование | Обозначение на схеме | Расход, куб.м/ч | Типоразмер, мм | [эквивалентный] диаметр, мм | Длина прямых участков, м | Кол-во поворотов | Потери на 1 м, Па | Потери в повороте, Па | Прочие потери, Па | Всего, Па | Примеч
Воздуховод кондиционирования кабинета | R1 | 272 | 200х150 | 200 | 0.964 | 1 | 0.8 | 0.8 |  | 1.6
Воздуховод кондиционирования детской | R2 | 272 | 200х150 | 200 | 4.629 | 3 | 0.8 | 0.8 |  | 6.1
Воздуховод кондиционирования спальни | R3 | 272 | 200х150 | 200 | 1 | 1 | 0.8 | 0.8 |  | 1.6
Приточный воздуховод | R13 | 160 |  | 160 | 5.2 | 1 | 0.5 | 3 | 40 | 50.0 | фильтр — 40, калорифер
Переточная решетка туалета | R14 | 135 | 204х60 |  |  |  |  |  |  | 5 | приблизительно
Отвод, клапан и потолочная решетка туалета | R15 | 30 | 110х55 |  |  |  |  |  |  | 5 | приблизительно
Приточный воздуховод увлажнения, горизонтальная часть | R16 | 105 | 204х60 | 122 | 1.4 | 0 | 1.2 | 2 |  | 1.7
Приточный воздуховод увлажнения, вертикальная часть | R16 | 105 |  | 100 | 1 | 1 | 3.5 | 4 |  | 7.5
Переточная решетка туалет-техзона | R17 | 30 | 110х55 |  |  |  |  |  |  | 1 | приблизительно
Вытяжной воздуховод туалета | R20 | 30 | 110х55 | 90 | 2 |  | 0.32 | 0 |  | 0.6
Переточная решетка ванной | R18 | 30 | 204х60 |  |  |  |  |  |  | 0.5 | приблизительно
Вытяжной воздуховод ванной | R19 | 30 | 110х55 | 90 | 0.5 |  | 0.32 | 0 |  | 0.2
Переточная решетка кухни | R21 | 100 | 300х200 |  |  |  |  |  |  | 2 | АП 300х200
Вытяжной воздуховод кухни | R22 | 100 |  |  |  |  |  |  |  | 1 | приблизительно
Магистраль увлажнения 1, вертикальная часть | R23 | 105 |  | 100 | 1 | 1 | 3.5 | 4 |  | 7.5
Магистраль увлажнения 1, горизонтальная часть | R23 | 105 | 204х60 | 122 | 1.4 | 0 | 1.2 | 2 |  | 1.7
Магистраль увлажнения 2 | R24 | 70 | 122x60 | 100 | 7 | 1 | 1.8 | 1.8 |  | 14.4
Вохдуховод увлажнения кабинета | R25 | 35 | 122x60 | 100 | 1 | 0 | 0.35 | 0 |  | 0.3
Вохдуховод увлажнения детской | R26 | 35 | 122x60 | 100 | 1.4 | 0 | 0.35 | 0 |  | 0.5
Вохдуховод увлажнения спальни | R27 | 35 | 122x60 | 100 | 1.9 | 1 | 0.35 | 0 |  | 0.7

Sheet: утепление
Воздуховоды 200х150
Периметр утепления | 0.82
Длина воздуховода, мм | Площадь, кв.м
1250 | 1.025
1250 | 1.025
340 | 0.2788
540 | 0.4428
1030 | 0.8446
350 | 0.287
Коллектор и отводы
Размеры элемента, мм | Площадь, кв.м
290х650 | 0.1885
290х650 | 0.1885
920х650 | 0.598
Повороты
Размеры элемента, мм | Площадь, кв.м
450х450 | 0.2025
450х450 | 0.2025
300х150 | 0.045
250х150 | 0.0375
250х150 | 0.0375
250х150 | 0.0375
Всего
Воздуховоды 200х150 | 3.9032
Коллектор и отводы | 0.975
Повороты | 2.8125
ИТОГО | 7.6907
