antony-sm/Ovrajnaya_stadia_RD/кожух.FCStd

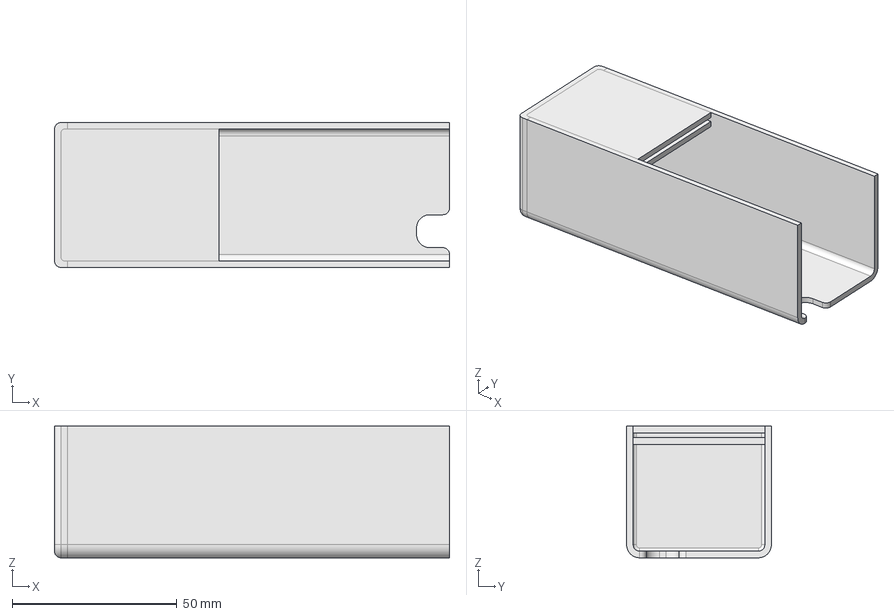
[picture p22: CAD file, 2020-12-21]
кожух.FCStd
120.0 x 44.0 x 40.0 mm
