antony-sm/Ovrajnaya_stadia_RD/(list of files, cad)

Other CAD files:
00 Сводное/01 Спальня/04 стена 1-2.dwg
00 Сводное/02 Кладовая/04 стена 2-9.dwg
00 Сводное/03 Кабинет/03 стена 13-15.dwg
00 Сводное/04 Детская/03 стена 24-25.dwg
00 Сводное/05 Кухня/05 стена 30.dwg
00 Сводное/06 Коридор/12 стена 27-26.dwg
00 Сводное/07 Ванная/03 стена 29-28.dwg
00 Сводное/08 Туалет/04 стена 29-38.dwg
00 Сводное/план сводный.dwg
04 ЭОМ СС/03 схемы подключения.dwg
05 ОВиК/02 план.dwg
06 ВК/общий.dwg
07 Перегородки потолки звукоизоляция/021 потолки спальня.dwg
08 Окна/вид.dwg
09 Полы/план.dwg
100 Мебель/2021-3.dwg
100 Мебель/Санузлы/2021-3 — ред. 2.dwg
20 Развертки/05 кухня.dwg
00 Сводное/01 Спальня/03 стена 4-1.dwg
00 Сводное/02 Кладовая/02 стена 8-7.dwg
00 Сводное/03 Кабинет/04 стена 15-9.dwg
00 Сводное/04 Детская/02 стена 21-24.dwg
00 Сводное/05 Кухня/04 стена 36.dwg
00 Сводное/06 Коридор/03 стена 16-3.dwg
00 Сводное/07 Ванная/04 стена 28-30.dwg
00 Сводное/08 Туалет/разрез З-З.dwg
04 ЭОМ СС/00 общие данные.dwg
05 ОВиК/03 адаптер.dwg
06 ВК/схема.dwg
07 Перегородки потолки звукоизоляция/022 потолки кладовая.dwg
100 Мебель/2021-2.dwg
100 Мебель/Санузлы/2021-3 — ред. 4.dwg
20 Развертки/02 кладовая.dwg
кладка ПГП.dwg
00 Сводное/01 Спальня/02 стена 3-4.dwg
00 Сводное/02 Кладовая/01 стена 9-8.dwg
00 Сводное/03 Кабинет/01 стена 9-10.dwg
00 Сводное/04 Детская/04 стена 25-20.dwg
00 Сводное/05 Кухня/02 стена 32-35.dwg
00 Сводное/06 Коридор/07 стена 15-14.dwg
00 Сводное/07 Ванная/01 стена 30-37.dwg
00 Сводное/08 Туалет/01 стена 38-27.dwg
04 ЭОМ СС/04 схемы щитов.dwg
05 ОВиК/04 ввод П.dwg
07 Перегородки потолки звукоизоляция/01 перегородки.dwg
100 Мебель/кухня.dwg
100 Мебель/Санузлы/ванная.dwg
20 Развертки/03 кабинет.dwg
00 Сводное/01 Спальня/01 стена 2-3.dwg
00 Сводное/02 Кладовая/03 стена 7-2.dwg
00 Сводное/03 Кабинет/02 стена 10-13.dwg
00 Сводное/04 Детская/01 стена 20-21.dwg
00 Сводное/05 Кухня/01 стена 37-32.dwg
00 Сводное/06 Коридор/08 стена 14-25.dwg
00 Сводное/07 Ванная/02 стена 37-29.dwg
00 Сводное/08 Туалет/вид Ж.dwg
04 ЭОМ СС/01 структурки.dwg
05 ОВиК/01 схема.dwg
07 Перегородки потолки звукоизоляция/10 звукоизоляция 13-15.dwg
20 Развертки/06 коридор ванная туалет.dwg
00 Сводное/05 Кухня/03 стена 35-36.dwg
00 Сводное/06 Коридор/04 стена 3-7.dwg
00 Сводное/08 Туалет/03 стена 28-29.dwg
04 ЭОМ СС/02 план.dwg
07 Перегородки потолки звукоизоляция/09 звукоизоляция 9-10.dwg
20 Развертки/04 детская.dwg
00 Сводное/05 Кухня/06 стена 30-31.dwg
00 Сводное/06 Коридор/11 стена 30-27.dwg
00 Сводное/08 Туалет/02 стена 27-28.dwg
04 ЭОМ СС/05 эскиз щита.dwg
07 Перегородки потолки звукоизоляция/04 звукоизоляция 1-2.dwg
20 Развертки/01 спальня.dwg
00 Сводное/06 Коридор/10 стена 31-30.dwg
07 Перегородки потолки звукоизоляция/звукоизоляция.dwg
20 Развертки/ванная.dwg
00 Сводное/06 Коридор/01 стена 26-39.dwg
07 Перегородки потолки звукоизоляция/06 звукоизоляция 3-4.dwg
20 Развертки/туалет.dwg
00 Сводное/06 Коридор/02 стена 39-16.dwg
07 Перегородки потолки звукоизоляция/14 звукоизоляция 20-21.dwg
00 Сводное/06 Коридор/09 стена 25-31.dwg
07 Перегородки потолки звукоизоляция/12 звукоизоляция 16-3.dwg
00 Сводное/06 Коридор/06 стена 8-15.dwg
07 Перегородки потолки звукоизоляция/13 звукоизоляция 17-16.dwg
00 Сводное/06 Коридор/05 стена 7-8.dwg
07 Перегородки потолки звукоизоляция/17 звукоизоляция 31-32.dwg
07 Перегородки потолки звукоизоляция/07 звукоизоляция 2-9.dwg
07 Перегородки потолки звукоизоляция/023 потолки кабинет.dwg
07 Перегородки потолки звукоизоляция/024 потолки детская.dwg
07 Перегородки потолки звукоизоляция/025 потолки кухня.dwg
07 Перегородки потолки звукоизоляция/028 потолки туалет.dwg
07 Перегородки потолки звукоизоляция/15 звукоизоляция 24-25.dwg
07 Перегородки потолки звукоизоляция/026 потолки коридор.dwg
07 Перегородки потолки звукоизоляция/027 потолки ванная.dwg
07 Перегородки потолки звукоизоляция/05 звукоизоляция 2-3.dwg
07 Перегородки потолки звукоизоляция/16 звукоизоляция 20-25.dwg
07 Перегородки потолки звукоизоляция/11 звукоизоляция 15-9.dwg
07 Перегородки потолки звукоизоляция/08 звукоизоляция 7-8.dwg
кожух.stl
