antony-sm/Ovrajnaya_stadia_RD/08 Окна/02 окно кабинет.pdf

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

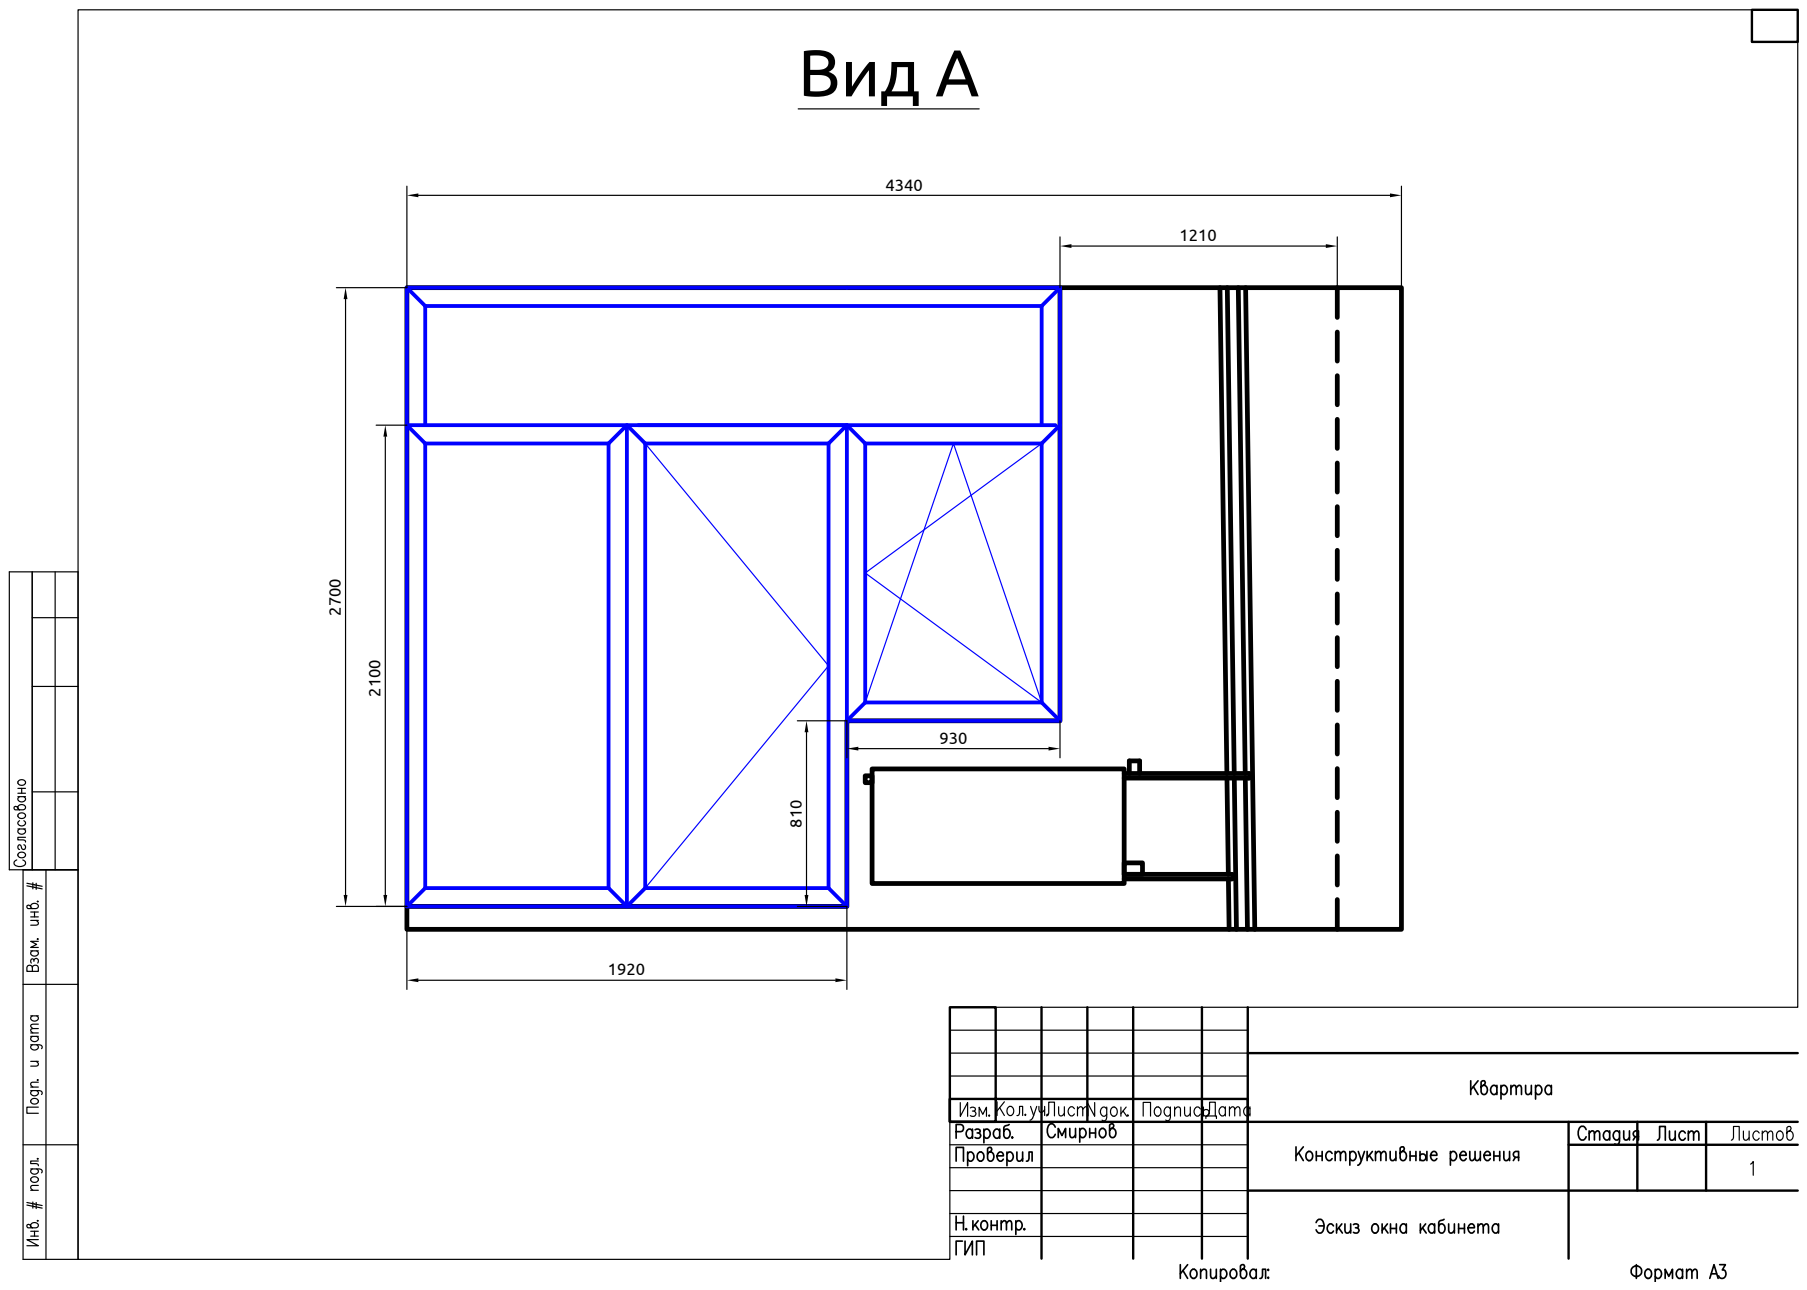
[picture p23: page 1]
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
