antony-sm/Ovrajnaya_stadia_RD/05 ОВиК/PDF/04 увлажнение.pdf

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

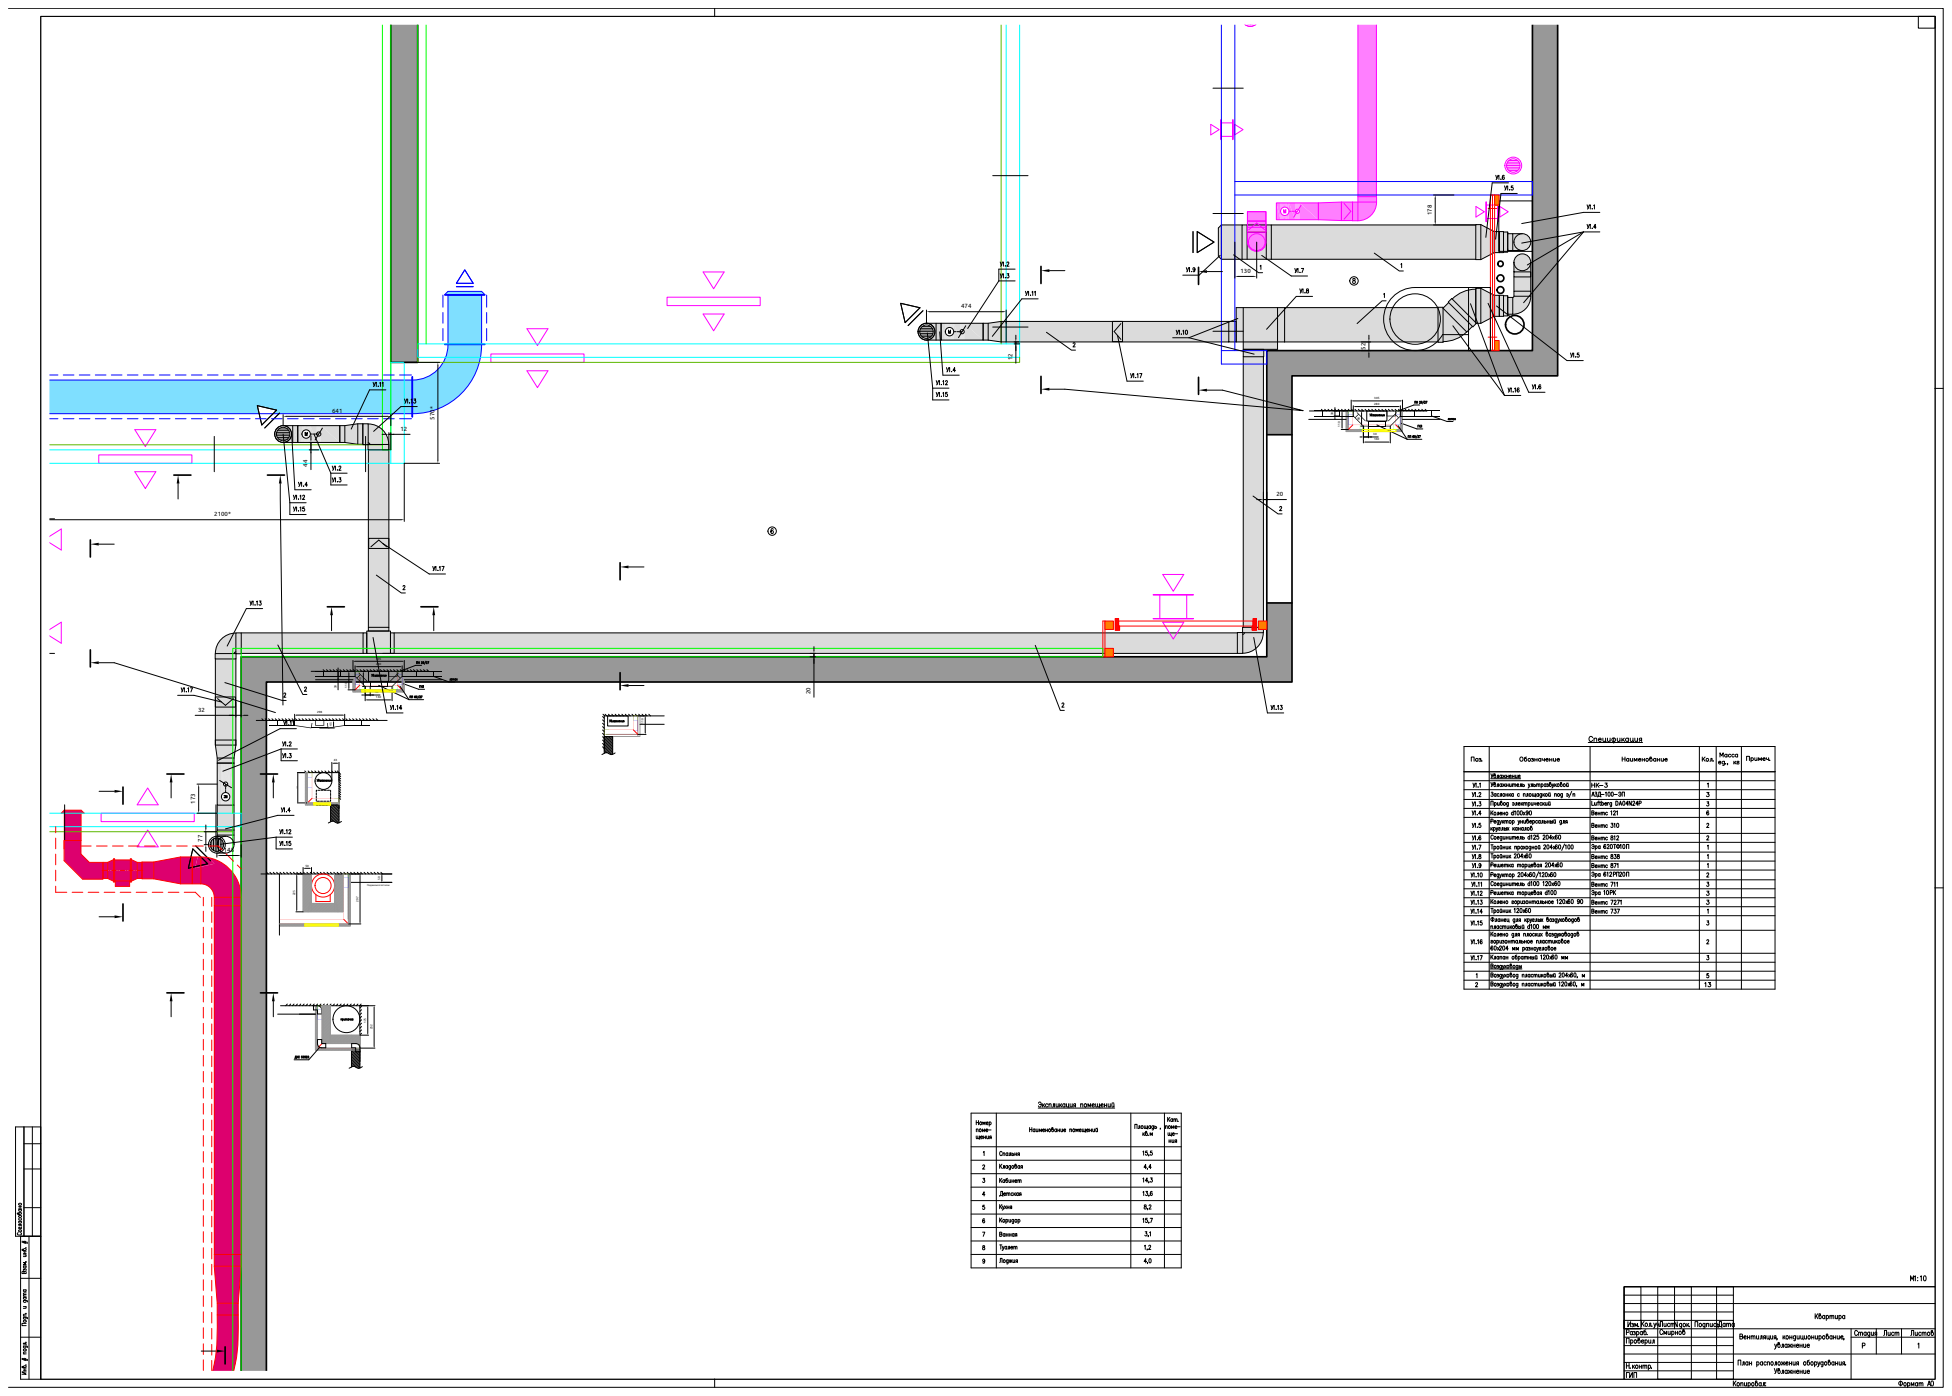
[picture p25: page 1]
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
