antony-sm/Ovrajnaya_stadia_RD/05 ОВиК/PDF/03 кондиционирование.pdf

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

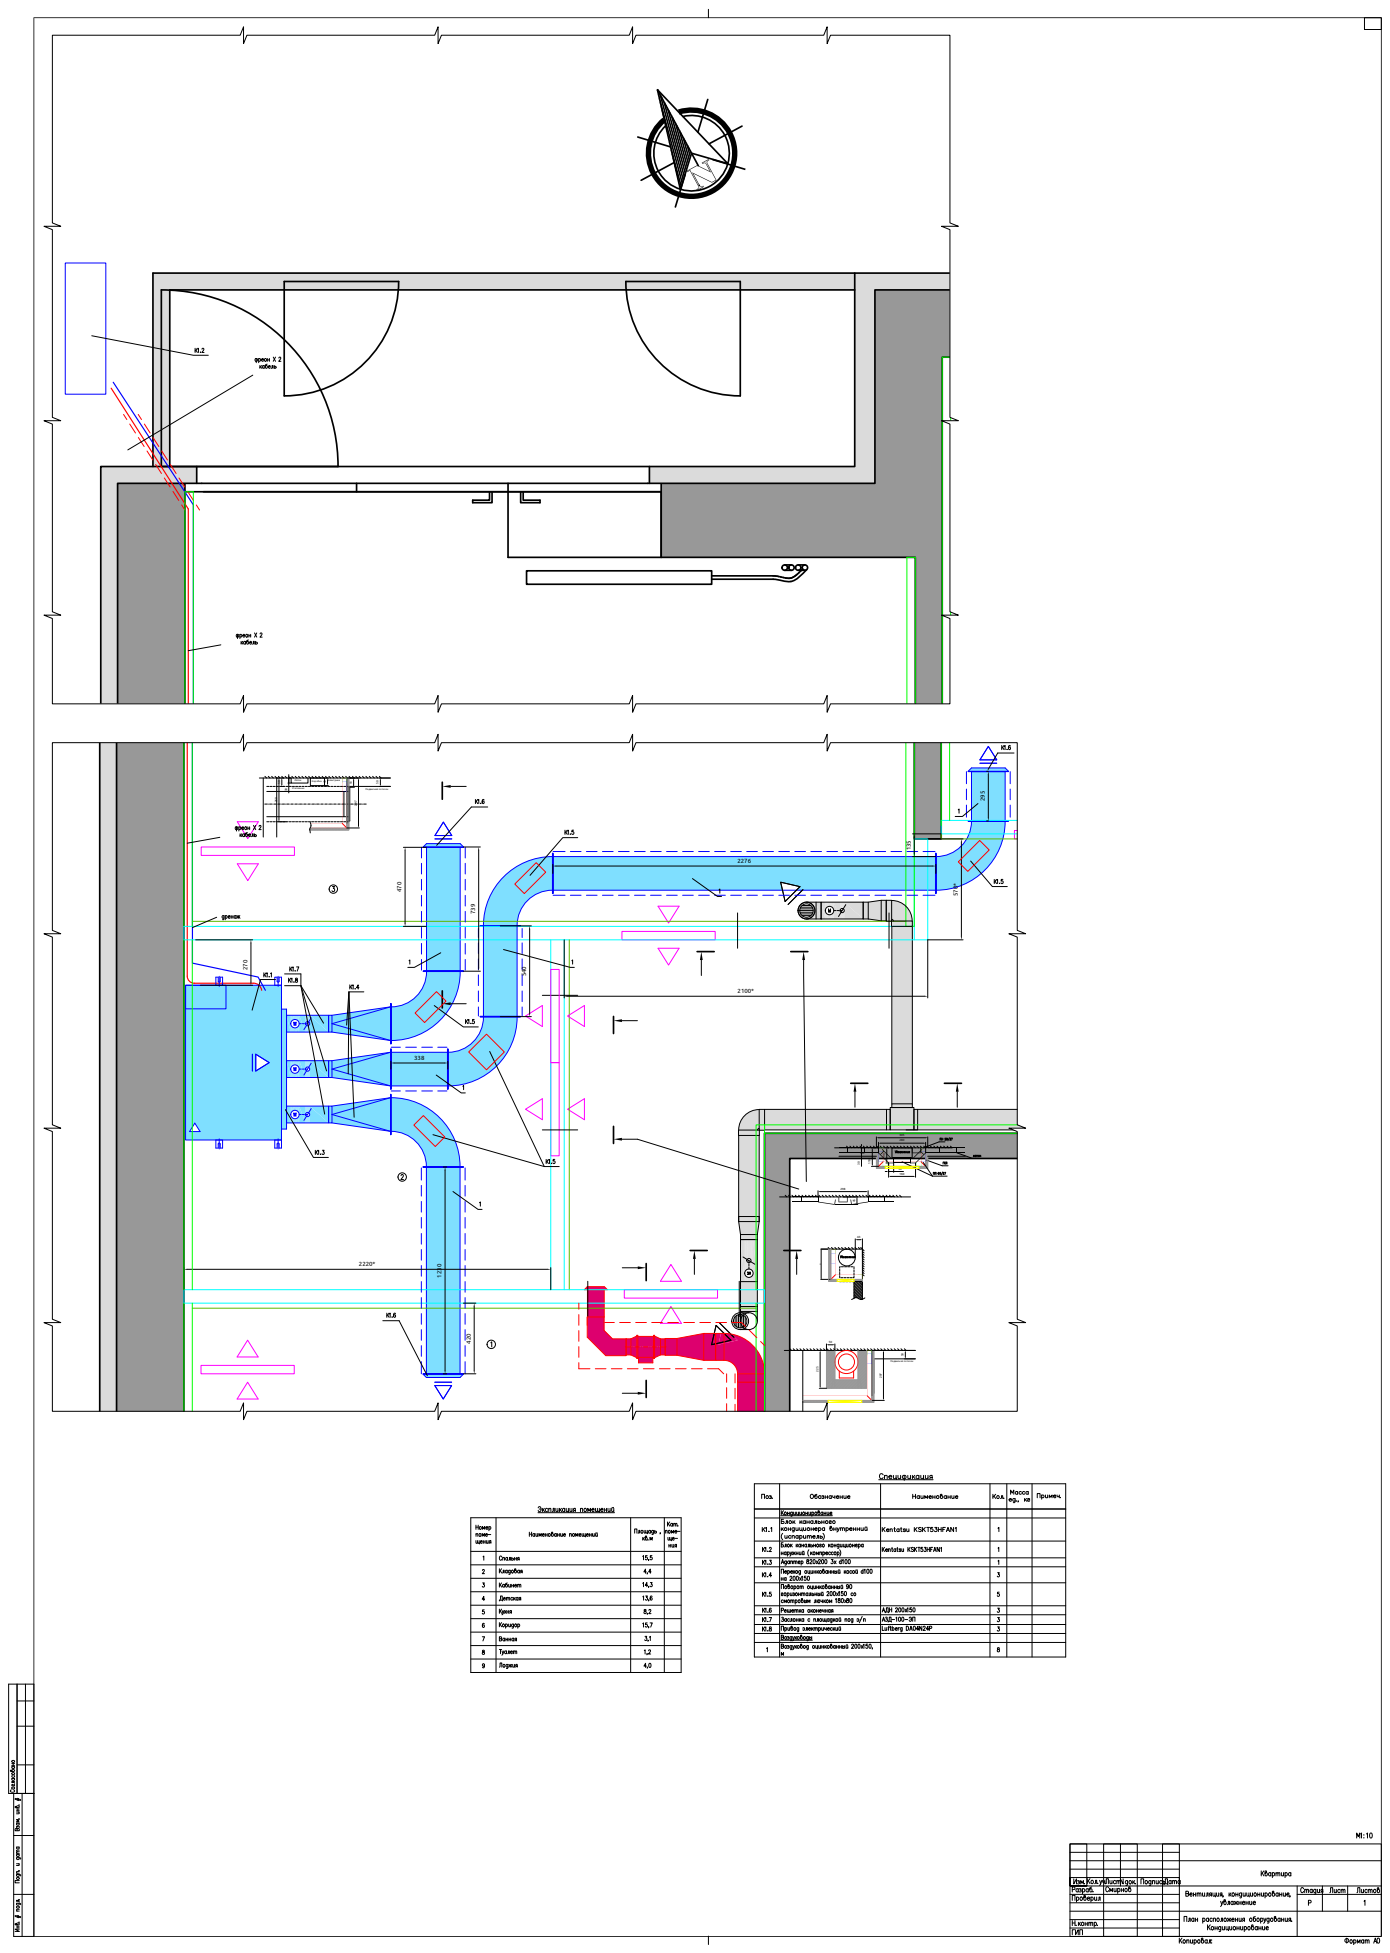
[picture p26: page 1]
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
