antony-sm/Ovrajnaya_stadia_RD/05 ОВиК/PDF/06 внутренний.pdf

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

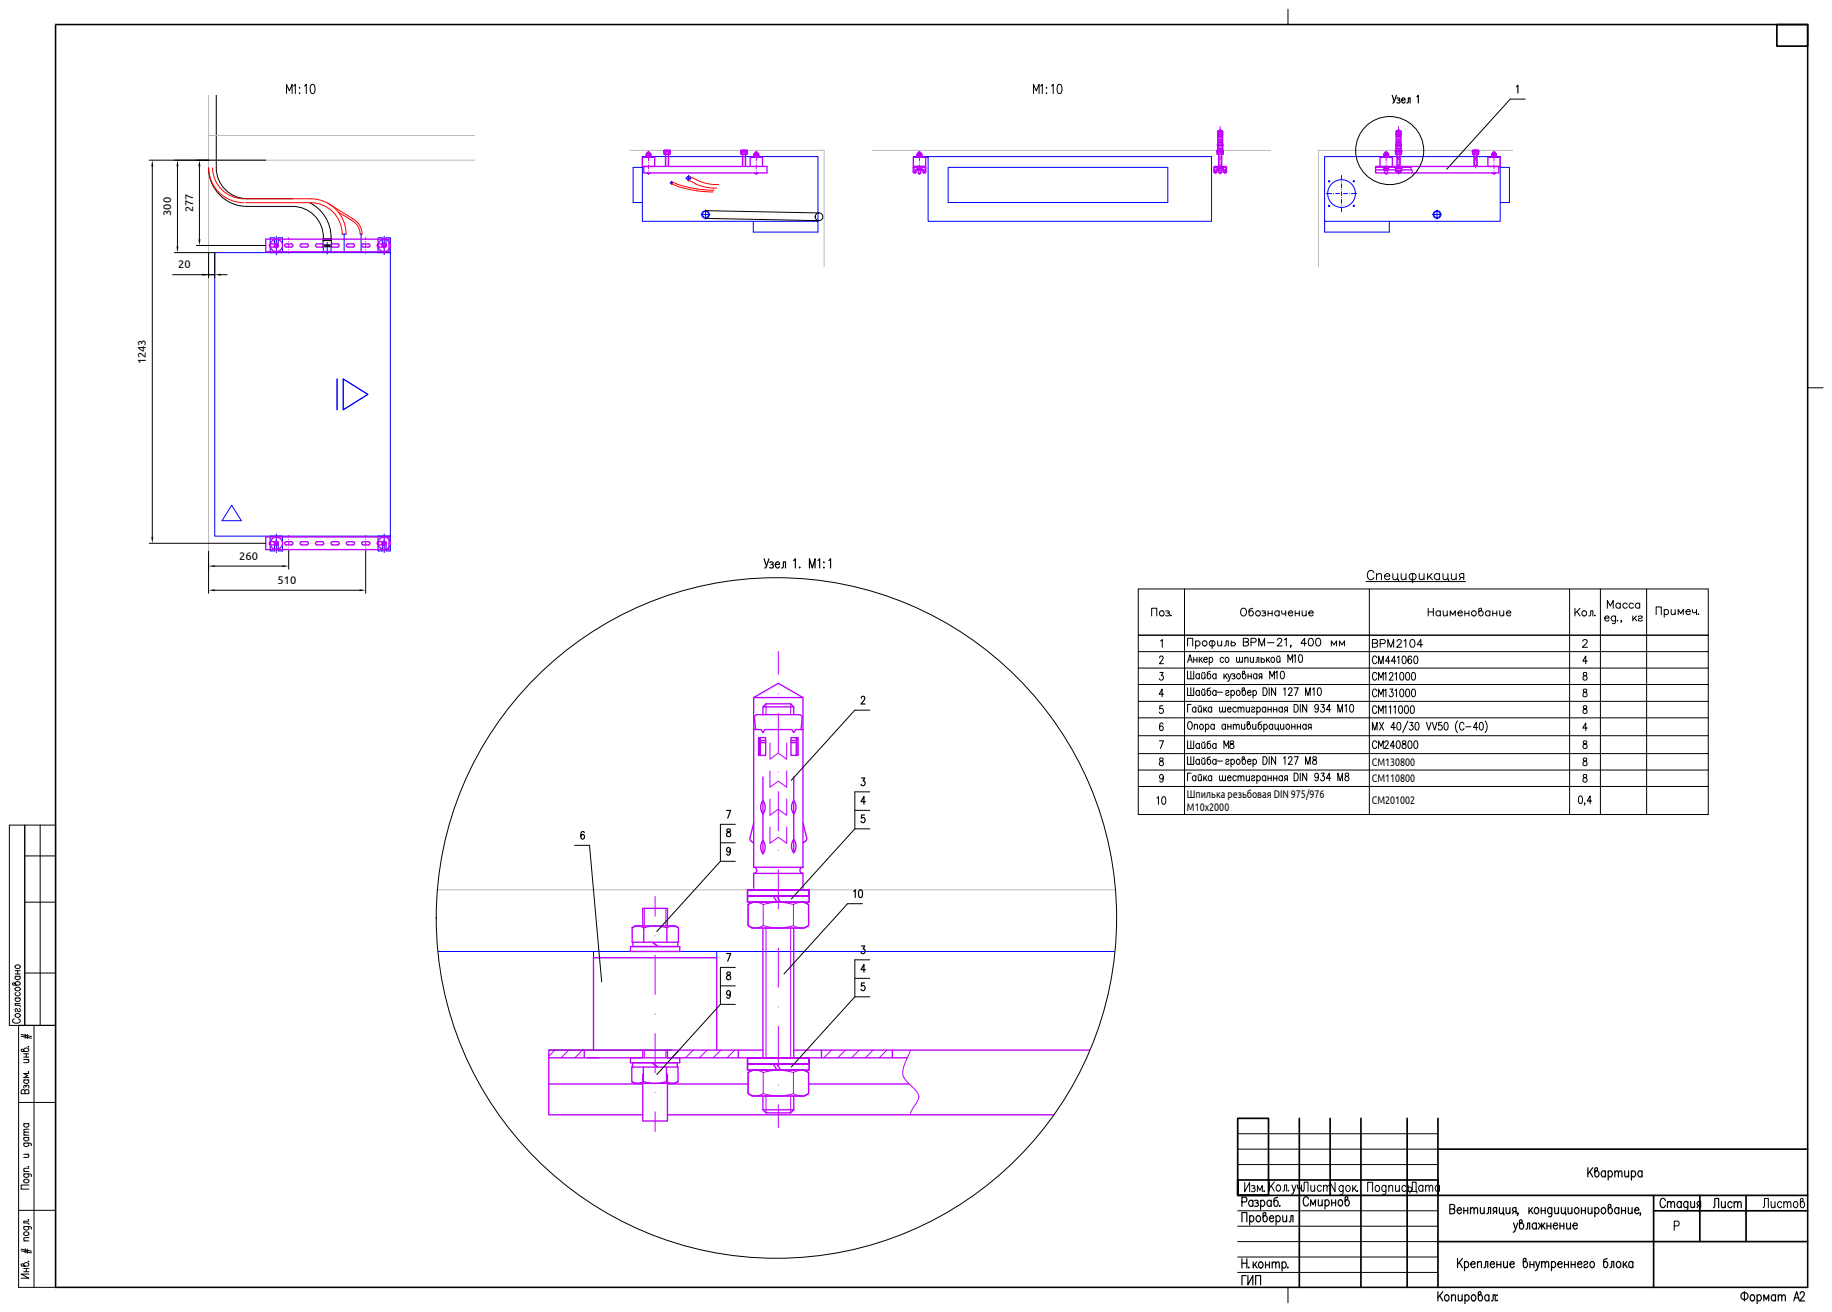
[picture p30: page 1]
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
