antony-sm/Ovrajnaya_stadia_RD/(commit log)

2017-09-24 Закончена схема подключения. Исправлен план перегородок
    [01 план.dwg, 02 план.dwg, 03 схемы подключения.dwg, план сводный.dwg]
2017-09-27 Добавлено оштукатуривание
    [01 план.dwg, specifikaciya.xls, specifikaciya.xlsx, расчеты.xls]
2017-09-30 Слаботочка. Часть 1
    [00 общие данные.dwg, 01 структурка.dwg, 02 план.dwg, 03 схемы подключения.dwg, кабжур.xls]
2017-10-01 Слаботочка. Часть 2
    [01 структурка.dwg, 02 план.dwg]
2017-10-04 Слаботочка. Часть 3
    [01 структурка.dwg, 02 план.dwg, 03 схемы подключения.dwg]
2017-10-10 Слаботочка. Часть 4
    [01 план.dwg, 01 структурка.dwg, 02 план.dwg, 03 схемы подключения.dwg]
2017-10-12 Слаботочка. Часть 5
    [01 структурка.dwg, 02 план.dwg, 03 схемы подключения.dwg, перечень элементов.xls]
2017-10-15 Слаботочка. Часть 6
    [00 общие данные.dwg, 01 план.dwg, 01 структурка.dwg, 02 план.dwg, 03 схемы подключения.dwg, кабжур.xls, перечень элементов.xls]
2017-10-18 Лотки Потолки Корректировка ОВиК
    [02 план.dwg, specifikaciya.xlsx, план сводный.dwg, разрез трасс.dwg]
2017-10-19 Изменён сводный план и прочее
    [02 план.dwg, план сводный.dwg, разрез трасс.dwg]
2017-10-23 Изменён подвесной потолок
    [02 план.dwg, план сводный.dwg, разрез трасс.dwg]
2017-10-26 Изменены лотки, подвесной потолок
    [01 план.dwg, 02 план.dwg, specifikaciya.xlsx, план сводный.dwg, план.dwg, разрез трасс.dwg, спецификация.xls]
2017-11-02 Работа над потолками
    [01 перегородки.dwg, 01 план.dwg, 02 план.dwg, 02 потолки.dwg, 03 лючки.dwg, specifikaciya.xls, specifikaciya.xlsx, план сводный.dwg]
2017-11-05 Потолки, лючки, разрезы
    [02 план.dwg, 02 потолки.dwg, specifikaciya.xlsx, план сводный.dwg, разрез трасс.dwg]
2017-11-08 Потолки, разрезы, размеры, разделены шлейфы герконов, настройка слоёв
    [01 структурка.dwg, 02 план.dwg, 02 потолки.dwg, кабжур.xls, план сводный.dwg]
2017-11-09 Развёртки стен. Часть 1
    [01 перегородки.dwg, 02 план.dwg, перечень элементов.xls, план сводный.dwg, развёртки стен.dwg]
2017-11-15 Развертки стен. Часть 2
    [02 план.dwg, вид.dwg, план сводный.dwg, развёртки стен.dwg]
2017-11-16 Развёртки стен. Часть 3
    [02 план.dwg, 02 план_recover_2017-11-16.dwg, план сводный.dwg, развёртки стен.dwg]
2017-11-20 Развертки стен. Часть 4
    [02 план.dwg, 02 план_recover_2017-11-16.dwg, план сводный.dwg, развёртки стен.dwg]
2017-11-22 Разверки стен. Часть 5
    [02 план.dwg, план сводный.dwg, развёртки стен.dwg]
2017-11-24 Развертки стен. Окончание
    [02 план (2).dwg, 02 план.dwg, план сводный.dwg, развёртки стен.dwg]
2017-11-29 Корректировка ЭОМ по результатам разработки разверток Длины кабелей
    [01 структурка.dwg, 02 план (2).dwg, 02 план.dwg, кабжур.xls, развёртки стен.dwg]
2017-12-03 Перечень элементов
    [01 структурка.dwg, 02 план.dwg, кабжур.xls, кухня.dwg, перечень элементов.xls, план сводный.dwg, развёртки стен.dwg, спецификация.xls]
2017-12-07 Спека
    [02 план.dwg, кабжур.xls, кухня.dwg, перечень элементов.xls, развёртки стен.dwg, спецификация.xls]
2017-12-09 Потолки и спека потолков
    [02 план.dwg, 02 потолки.dwg, specifikaciya.xls, план сводный.dwg, развёртки стен.dwg, расчеты.xls]
2017-12-15 Перечень элементов, спека
    [02 план.dwg, 02 потолки.dwg, specifikaciya.xls, кухня.dwg, перечень элементов.xls, развёртки стен - коррекция мебели.dwg, развёртки стен.dwg, расчеты.xls]
2018-01-02 Корректировка разверток кухни Корректировка ОВиК Продолжение разработки ЭОМ
    [01 структурка (2).dwg, 01 структурка.dwg, 02 план.dwg, 03 схемы подключения.dwg, 04 схема щита.dwg, 05 эскиз щита.dwg, specifikaciya.xlsx, кабжур.xls]
2018-01-05 Распечатка всех частей. Вводной щит. Часть 1
    [00 общие данные.dwg, 01 перегородки.dwg, 01 структурка (2).dwg, 01 структурка.dwg, 02 план.dwg, 02 потолки.dwg, 04 схема щита.dwg, 05 эскиз щита.dwg]
2018-01-07 Вводной щит. Часть 2
    [01 структурка.dwg, 02 план.dwg, 04 схема щита.dwg, кабжур.xls, развёртки стен.dwg]
2018-01-11 Вводной щит. Часть 3
    [01 структурка.dwg, 04 схема щита.dwg, план сводный.dwg, развёртки стен.dwg, спецификация.xlsx]
2018-01-14 Ввлдной щит. Часть 4 Корректировка развёрток стен
    [02 план.dwg, 04 схема щита.dwg, 05 эскиз щита.dwg, перечень элементов основной.xls, перечень элементов щита.xls, перечень элементов.xls, план сводный.dwg, развёртки стен.dwg]
2018-01-26 Вводной щит. Часть 5 Коррекция плана розеток Коррекция разверток стен
    [01 структурка.dwg, 02 план.dwg, 04 схема щита.dwg, 05 эскиз щита.dwg, перечень элементов щита.xls, развёртки стен.dwg, спецификация.xlsx]
2018-01-27 Вводной щит. Часть 6
    [04 схема щита.dwg, перечень элементов щита.xls]
2018-01-30 Вводной щит. Часть 7
    [02 план.dwg, 04 схема щита.dwg, 05 эскиз щита.dwg, перечень элементов щита.xls, расчеты.xls]
2018-02-01 Вводной щит. Часть 8
    [04 схема щита.dwg, перечень элементов щита.xls, расчеты.xls]
2018-02-05 Вводной щит. Часть 9
    [04 схема щита.dwg, 05 эскиз щита.dwg, перечень элементов щита.xls, расчеты.xls]
2018-02-08 Вводной щит. Часть 10
    [02 план.dwg, 04 схема щита.dwg, 05 эскиз щита.dwg, ванная.dwg, перечень элементов щита.xls, план сводный.dwg, развёртки стен ред. 3.dwg, спецификация.xlsx]
2018-02-13 Вводной щит. Часть 11
    [01 структурка.dwg, 02 план.dwg, 03 схемы подключения.dwg, 04 схема щита.dwg, 05 эскиз щита.dwg, перечень элементов щита.xls, расчеты.xls]
2018-02-15 Вводной щит. Часть 12
    [01 структурка.dwg, 04 схема щита.dwg, 05 эскиз щита.dwg, перечень элементов основной.xls, перечень элементов щита.xls, расчеты.xls, спецификация.xlsx]
2018-02-16 Вводной щит. Часть 13
    [00 общие данные.dwg, 01 структурка.dwg, 02 план.dwg, 05 эскиз щита.dwg, кабжур.xls, перечень элементов щита.xls, план сводный.dwg, спецификация.xlsx]
2018-02-17 Незначительные изменения
    [00 общие данные.dwg, 01 перегородки.dwg, 01 структурка.dwg, 01 структурки.dwg, 02 план.dwg, план сводный.dwg, развёртки стен.dwg]
2018-02-18 Создан сводный чертеж стен
    [01 перегородки.dwg, кладка ПГП.dwg, развёртки стен.dwg, стены сводный.dwg]
2018-02-21 Звукоизоляция. Часть 1
    [04 звукоизоляция.dwg, кладка ПГП.dwg, развёртки стен.dwg, стены сводный.dwg]
2018-02-22 Звукоизиоляция. Часть 2
    [04 звукоизоляция.dwg]
2018-02-26 Звукоизоляция. Часть 2
    [01 структурки.dwg, 02 план.dwg, 04 звукоизоляция.dwg, кабжур.xls, развёртки стен.dwg]
2018-02-27 Звукоизоляция. Часть 4
    [04 звукоизоляция.dwg, развёртки стен.dwg]
2018-02-28 Звукоизоляция. Часть 5
    [04 звукоизоляция.dwg, кладка ПГП.dwg, развёртки стен.dwg]
2018-03-01 Звукоизоляция. Часть 6
    [04 звукоизоляция.dwg]
2018-03-02 Звукоизоляция. Окончание
    [04 звукоизоляция.dwg, расчеты.xls]
2018-03-06 Звукоизоляция. Компоновка листов
    [04 звукоизоляция 1-2.dwg, 04 звукоизоляция.dwg, 05 звукоизоляция 2-3.dwg, 06 звукоизоляция 3-4.dwg, 07 звукоизоляция 2-9.dwg, 08 звукоизоляция 7-8.dwg, 09 звукоизоляция 9-10.dwg, 10 звукоизоляция 13-15.dwg]
2018-03-13 Детальная трассировка ЭОМ по помещениям. Часть 1
    [02 план.dwg, 05 эскиз щита.dwg, кабжур.xls, план сводный.dwg, развёртки стен.dwg, санузлы.fcstd]
2018-03-14 Вынос стен в сводные файлы-подложки. Часть 1
    [01 стена 2-3.dwg, 01 стена 20-21.dwg, 01 стена 26-39.dwg, 01 стена 30-37.dwg, 01 стена 37-32.dwg, 01 стена 38-27.dwg, 01 стена 9-10.dwg, 01 стена 9-8.dwg]
2018-03-14 Вынос стен в сводные файлы-подложки. Окончание Новая компоновка печати разверток. Часть 1
    [01 перегородки.dwg, 01 спальня.dwg, 01 стена 2-3.dwg, 01 стена 20-21.dwg, 01 стена 26-39.dwg, 01 стена 30-37.dwg, 01 стена 37-32.dwg, 01 стена 38-27.dwg]
2018-03-16 Новая компоновка разверток и трасс гофры. Часть 2
    [01 спальня.dwg, 02 кладовая.dwg, 02 план.dwg, 03 кабинет.dwg, 03 стена 13-15.dwg, 04 стена 15-9.dwg, план сводный.dwg]
2018-03-18 Новая компоновка разверток и трасс гофры. Часть 3 Корректировка потолков. Часть 1
    [01 спальня.dwg, 02 кладовая.dwg, 02 стена 8-7.dwg, 03 кабинет.dwg, 04 стена 15-9.dwg, план сводный.dwg, спецификация.xlsx]
2018-03-21 Новая компоновка разверток и трасс гофры. Часть 4
    [01 спальня.dwg, 01 структурки.dwg, 02 кладовая.dwg, 02 план.dwg, 02 потолки.dwg, 03 кабинет.dwg, кабжур.xls, конфигурация печати планов.cfg]
2018-03-22 Новая компоновка разверток и трасс гофры. Часть 5
    [01 спальня.dwg, 01 структурки.dwg, 02 план.dwg, 04 детская.dwg, кабжур.xls, план сводный.dwg]
2018-03-26 Новая компоновка разверток и трасс гофры. Часть 6
    [01 спальня.dwg, 01 структурки.dwg, 02 кладовая.dwg, 02 план.dwg, 02 стена 10-13.dwg, 02 стена 32-35.dwg, 03 кабинет.dwg, 04 детская.dwg]
2018-03-30 Новая компоновка разверток и трасс гофры. Часть 7
    [01 спальня.dwg, 01 структурки.dwg, 02 кладовая.dwg, 02 план.dwg, 03 кабинет.dwg, 04 детская.dwg, 05 кухня.dwg, 05 стена 7-8.dwg]
2018-04-01 Новая компоновка разверток и трасс гофры. Часть 8
    [02 потолки.dwg, 05 кухня.dwg, 06 коридор ванная туалет.dwg, план сводный.dwg, спецификация.xls]
2018-04-04 Корректировка потолков. Часть 1
    [01 спальня.dwg, 01 стена 2-3.dwg, 01 стена 20-21.dwg, 01 стена 26-39.dwg, 01 стена 37-32.dwg, 01 стена 9-8.dwg, 02 кладовая.dwg, 02 потолки.dwg]
2018-04-11 Корректировка потолков. Часть 2
    [01 стена 2-3.dwg, 01 стена 20-21.dwg, 01 стена 26-39.dwg, 01 стена 37-32.dwg, 01 стена 9-10.dwg, 01 стена 9-8.dwg, 02 стена 10-13.dwg, 02 стена 21-24.dwg]
2018-05-09 Корректировка по результатам работ
    [01 структурки.dwg, 02 план.dwg, 026 потолки коридор ванная туалет.dwg, 04 стена 29-38.dwg, specifikaciya.xlsx, вид.dwg, кабжур.xls, санузлы.fcstd]
2018-05-21 Корректировка по результатам работ Добавлены медные трубки
    [02 план.dwg, вид.dwg, кабжур.xls, перечень элементов щита.xls, спецификация.xls, спецификация.xlsx]
2018-05-26 ДСУП
    [01 структурки.dwg, 02 план.dwg, 03 схемы подключения.dwg, 04 схема щита.dwg, 05 эскиз щита.dwg, кабжур.xls, план сводный.dwg, спецификация.xls]
2018-06-11 ВК. Часть 1
    [03 схемы подключения.dwg, specifikaciya.xlsx, адреса ПС.xls, вид.dwg, план сводный.dwg, спецификация.xls]
2018-06-24 ВК. Часть 1 Различные корректировки
    [01 стена 2-3.dwg, 02 план.dwg, 021 потолки спальня.dwg, 022 потолки кладовая.dwg, 023 потолки кабинет.dwg, 024 потолки детская.dwg, 025 потолки кухня.dwg, 026 потолки коридор ванная туалет.dwg]
2018-07-25 Корректировка потолков и лючков
    [01 стена 2-3.dwg, 02 стена 3-4.dwg, 021 потолки спальня.dwg, 022 потолки кладовая.dwg, 023 потолки кабинет.dwg, 024 потолки детская.dwg, 025 потолки кухня.dwg, 026 потолки коридор ванная туалет.dwg]
2018-08-09 ВК. Часть 3
    [02 план.dwg, вид.dwg, потолки старое.dwg, спецификация.xls]
2018-09-05 Корректировка потолков
    [01 стена 2-3.dwg, 01 стена 26-39.dwg, 01 стена 9-8.dwg, 02 стена 3-4.dwg, 02 стена 39-16.dwg, 02 стена 8-7.dwg, 021 потолки спальня.dwg, 022 потолки кладовая.dwg]
2018-09-25 ВК. Часть 4
    [026 потолки коридор.dwg, 03 стена 35-36.dwg, 11 стена 30-27.dwg, вид.dwg, план сводный.dwg]
2018-10-06 ВК. Часть 4 Корректировка ЭОМ
    [01 структурки.dwg, 02 план.dwg, вид.dwg, кабжур.xls, спецификация.xls]
2018-10-16 ВК. Часть 5
    [04 звукоизоляция 1-2.dwg, 05 звукоизоляция 2-3.dwg, 06 звукоизоляция 3-4.dwg, 07 звукоизоляция 2-9.dwg, 08 звукоизоляция 7-8.dwg, 18 раскрой.dwg, вид.dwg, звукоизоляция.dwg]
2018-10-18 ВК. Часть 6
    [вид.dwg]
2018-11-06 ВК. Часть 7
    [вид.dwg, расчеты.xls, спецификация.xls]
2018-12-23 ВК. Часть 8. +различные корректировки
    [01 перегородки.dwg, 01 спальня.dwg, 01 структурки.dwg, 02 кладовая.dwg, 02 план.dwg, 02 стена 3-4.dwg, 021 потолки спальня.dwg, 022 потолки кладовая.dwg]
2019-02-17 ВК. Часть 9. Корректировка звукоизоляции, ОВиК
    [01 перегородки.dwg, 02 план.dwg, 022 потолки кладовая.dwg, 04 звукоизоляция 1-2.dwg, 04 стена 29-38.dwg, 06 звукоизоляция 3-4.dwg, 07 звукоизоляция 2-9.dwg, 09 звукоизоляция 9-10.dwg]
2019-04-21 ВК. Часть 10
    [вид.dwg, расчеты.xls, спецификация.xls]
2020-07-24 Накопленнные изменения
    [01 спальня.dwg, 01 стена 2-3.dwg, 01 стена 37-32.dwg, 02 стена 32-35.dwg, 03 схемы подключения.dwg, 04 схема щита.dwg, 05 эскиз щита.bak000.dwg, 05 эскиз щита.bak001.dwg]
2020-09-07 После монтажа щита
    [01 структурки.dwg, 02 план.dwg, 04 схема щита.dwg, 05 эскиз щита.bak000.dwg, 05 эскиз щита.bak001.dwg, 05 эскиз щита.bak002.dwg, 05 эскиз щита.dwg, кабжур.xlsx]
2020-10-18 Корректировка коробов
    [01 стена 2-3.dwg, 01 стена 20-21.dwg, 01 стена 26-39.dwg, 01 стена 37-32.dwg, 01 стена 9-10.dwg, 01 стена 9-8.dwg, 02 стена 10-13.dwg, 02 стена 21-24.dwg]
2020-12-21 Некоторые правки Добавлены щитки автоматики Добавлена модель кожуха
    [01 спальня.dwg, 02 кладовая.dwg, 03 кабинет.dwg, 03 схемы подключения.dwg, 04 детская.dwg, 04 стена 36.dwg, 04 схема щита.dwg, 04 схемы щитов.dwg]
2020-12-26 Правки после установки герконов на входные двери
    [01 структурки.dwg, 02 план.dwg, 03 схемы подключения.dwg, 06 таблицы подключения автоматики.xlsx, 06 таблицы подключения щитов автоматики.xlsx, кабжур.xlsx, план сводный.dwg]
2021-01-14 Добавлена звукоизоляция + декор потолка спальни
    [021 потолки спальня.dwg, план сводный.dwg, спецификация.xls]
2021-01-16 Исправления по результатам разводки автоматики в туалете
    [01 структурки.dwg, 02 план.dwg, 03 схемы подключения.dwg, 06 таблицы подключения автоматики.xlsx, кабжур.xls, спецификация.xls]
2021-01-20 Замена реле задержки времени
    [04 схемы щитов.dwg, кабжур.xlsx, спецификация.xlsx]
2021-01-28 Доработка звукоизоляции Разработка схемы и эскиза слаботочки ША-6. Часть 1
    [04 схемы щитов.dwg, 05 эскиз щита.dwg, 06 таблицы подключения автоматики.xlsx, 06 таблицы подключения слаботочки.xlsx, кабжур.xls, перечень элементов основной.xls, перечень элементов щита.xls, спецификация.xls]
2021-07-04 Накопившиеся корректировки
    [00 общие данные.dwg, 01 структурки.dwg, 02 план.dwg, 021 потолки спальня.dwg, 03 схемы подключения.dwg, 04 схемы щитов.dwg, 06 таблицы подключения слаботочки.xlsx, 2021-2.dwg]
